FeCoquito/Robot-s-design/RoboFEI 2024/Design Data/XLS/en-US/clearance.xls

Sheet: Ansi Unified Screw Threads
I | Sort Order -1
Fastener Type | Size | Shaft Diameters |  |  | Head Dimensions
 |  | Close | Normal | Loose | Diameter | Depth/Angle | Head Type
Flat Head Machine Screw (82) | #0 | 0.0635 | 0.07 | 0.073 | 0.119 | 82 | 2
Flat Head Machine Screw (82) | #1 | 0.076 | 0.081 | 0.089 | 0.146 | 82 | 2
Flat Head Machine Screw (82) | #2 | 0.089 | 0.096 | 0.1065 | 0.172 | 82 | 2
Flat Head Machine Screw (82) | #3 | 0.104 | 0.11 | 0.12 | 0.199 | 82 | 2
Flat Head Machine Screw (82) | #4 | 0.116 | 0.1285 | 0.136 | 0.225 | 82 | 2
Flat Head Machine Screw (82) | #5 | 0.1285 | 0.136 | 0.154 | 0.252 | 82 | 2
Flat Head Machine Screw (82) | #6 | 0.144 | 0.1495 | 0.1695 | 0.279 | 82 | 2
Flat Head Machine Screw (82) | #8 | 0.1695 | 0.177 | 0.1935 | 0.332 | 82 | 2
Flat Head Machine Screw (82) | #10 | 0.196 | 0.201 | 0.221 | 0.385 | 82 | 2
Flat Head Machine Screw (82) | #12 | 0.221 | 0.228 | 0.246 | 0.438 | 82 | 2
Flat Head Machine Screw (82) | 1/4 | 0.257 | 0.266 | 0.2812 | 0.507 | 82 | 2
Flat Head Machine Screw (82) | 5/16 | 0.323 | 0.332 | 0.3437 | 0.635 | 82 | 2
Flat Head Machine Screw (82) | 3/8 | 0.386 | 0.397 | 0.4062 | 0.762 | 82 | 2
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
