FeCoquito/Robot-s-design/RoboFEI 2014/Conjunto Roda/Vista explodida roda.png

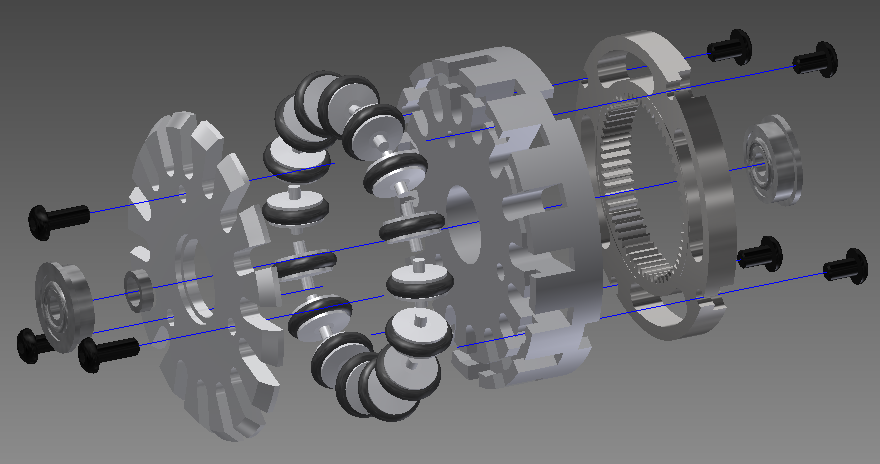
RoboFEI 2014/Conjunto Roda/Vista explodida roda.png
