FeCoquito/Robot-s-design/RoboFEI 2014/Work in Progress 2014/Projeto Nova Frente/CAD/F-180 Fundo branco.jpg

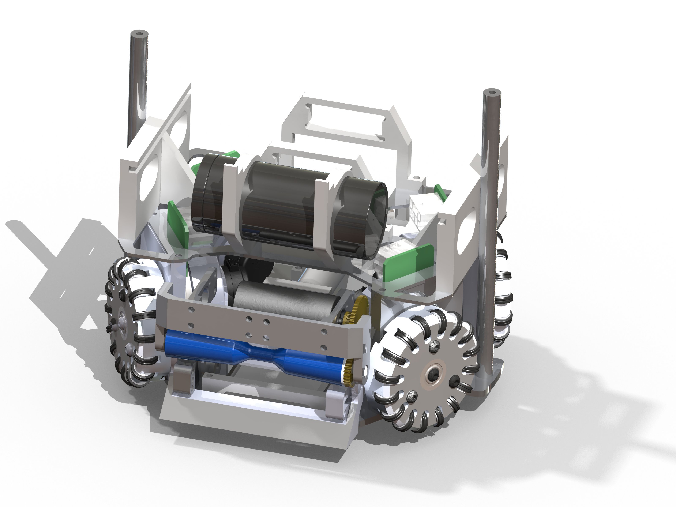
RoboFEI 2014/Work in Progress 2014/Projeto Nova Frente/CAD/F-180 Fundo branco.jpg
