FeCoquito/Robot-s-design/RoboFEI 2014/Work in Progress 2014/Projeto Nova Frente/CAD/Small Size 2011.bmp

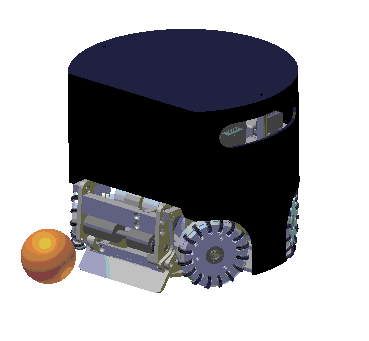
RoboFEI 2014/Work in Progress 2014/Projeto Nova Frente/CAD/Small Size 2011.bmp
