FeCoquito/Robot-s-design/RoboFEI 2014/Work in Progress 2014/Projeto Nova Frente/Distancia Polia.png

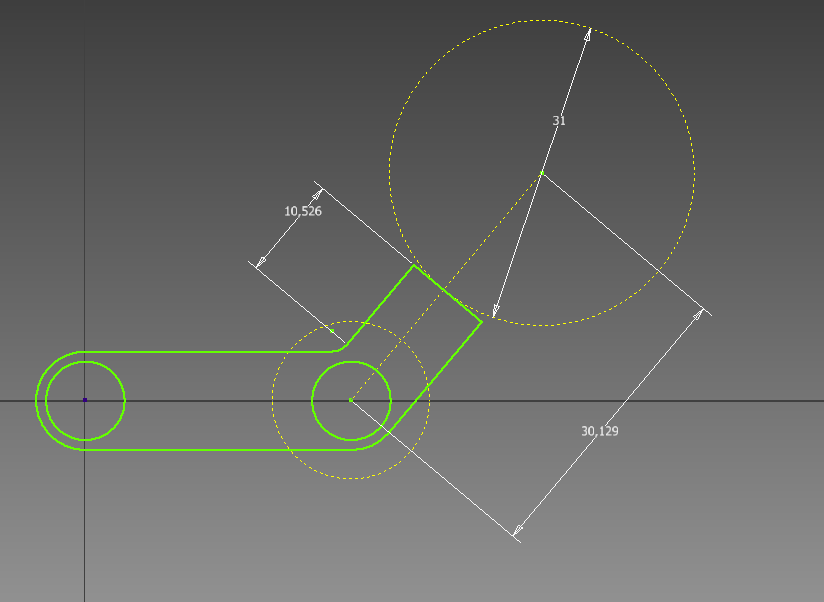
RoboFEI 2014/Work in Progress 2014/Projeto Nova Frente/Distancia Polia.png
