FeCoquito/Robot-s-design/RoboFEI 2023/2D/VistaExplodidaRodaMontada2.PNG

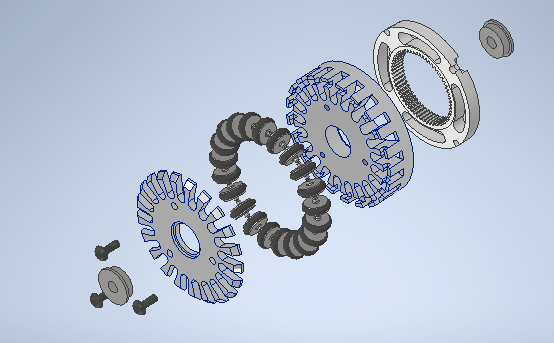
RoboFEI 2023/2D/VistaExplodidaRodaMontada2.PNG
