FeCoquito/Robot-s-design/RoboFEI 2014/Work in Progress 2014/Projeto Nova Frente/Componentes/Lista de Componentes.txt

Componentes F-180 2011

Polia motora:
https://sdp-si.com/eStore/PartDetail.asp?Opener=Group&PartID=84782&GroupID=346

Polia movida:
https://sdp-si.com/eStore/PartDetail.asp?Opener=Group&PartID=84800&GroupID=346

Correia:
https://sdp-si.com/eStore/PartDetail.asp?Opener=Group&PartID=84505&GroupID=342
