FeCoquito/Robot-s-design/Documentação - Mecânica/Checklist Mecânica materias para viagem.xlsx

Sheet: Planilha1
Chek List Mecânica
Status | Quantidade | Item | Descrição | FCA
 | 2 | Câmeras | Camêras de jogo: TAMRON CCTV Lens - M12M1412 C 1/2" 4-12 mm F/1.4 | 034341 / 034342
 | 2 | Suportes | Suporte das câmeras para fixação
 | 1 | Paquímetro | Paquímetro Digital Insize 150 mm na caixa(verde) | 45097
 | 1 | Tesoura
 | 1 | Pincel
 | 1 | Dremel e suas pontas
 | 1 | WD 40
 | 1 | Alicate Universal
 | 1 | Alicate de corte
 | 4 | Chaves de Fenda
 | 3 | Chaves Phillips
 | 1 | Alicate de Pressão
 | 1 | Super Bonder
 | 1 | Fita Crepe
 | 2 | Fita Isolante
 | 3 | Tubos cola quente
 | 1 | Pistola de cola quente
 | 1 | Abraçadeira de Nylon
 | 1 | Óculos de segurança
 | 1 | Limas agulhas
 | 1 | Lima média
 | 1 | Caixa de ferramentas
 | 1 | Fita verde (3M dupla face)
 | 1 | Caixa de peças reservas | com frente atual, chapa inferior, conjunto chipkick, suporte capacitores, batentes dianteiros, chute reto
 | 1 | Sargento
 | 1 | Cola de fixação (Loctite)
 | 1 | Cola trava-rosca (Loctite)
 | 5 | Chaves allen M3
 | 2 | Chaves allen M4
 | 5 | Lixas com granulações diferentes (36 a 320)
 | 2 | Conjuntos de machos M3
 | 1 | Conjuntos de machos M4
 | 1 | Pacote de elástico
 | 1 | Estilete
 | 1 | Kit de chaves Stanley
 | 1 | Conjunto de perfurador de pino paralelo
 | 1 | Martelo de borracha
 | 1 | Martelo de metal
 | 1 | Fita Silver Tape
 | 2 | Pratos magnéticos
 | 1 | Saco de borrachas o’rings
 | 1 | Saco de parafusos M3x6mm - reto
 | 1 | Saco de parafusos M3x6mm – oval
 | 1 | Saco de parafusos M3x8mm - reto
 | 1 | Saco de parafusos M3x8mm - oval
 | 1 | Saco de parafusos M3x12mm - reto
 | 1 | Saco de parafusos M3x12mm - oval
 | 1 | Saco de parafusos extra
 | 1 | Saco de parafusos do motor
 | 20 | Barra roscada M3 (segurar capinha)
 | 20 | Porca M3 para capinha
 | Até 24 | Espaçador f5x7mm
 | Até 24 | Arruela f5x10mm
 | Até 24 | Rolamentos f2mm
 | Até 24 | Rolamentos f4mm
 | Até 24 | Rolamentos f5mm
 | 1 | Kit para montar enconder
 | 2 | Potinho para desmontar robô
 | 1 | Rolo de fio de nylon f1 mm
OBS: |  | Sujeito à mudança nas quantidades de chaves, alicates e ferramentas em geral.

Sheet: Planilha2
Equipamentos com FCA
Quantidade | Item | Descrição | FCA
1 | Paquimetro | Páquimetro Digital Insize 150 mm na caixa(verde) | 45097
