FeCoquito/Robot-s-design/RoboFEI 2014/Work in Progress 2014/Projeto Nova Frente/IPTs/Conector femea.igs

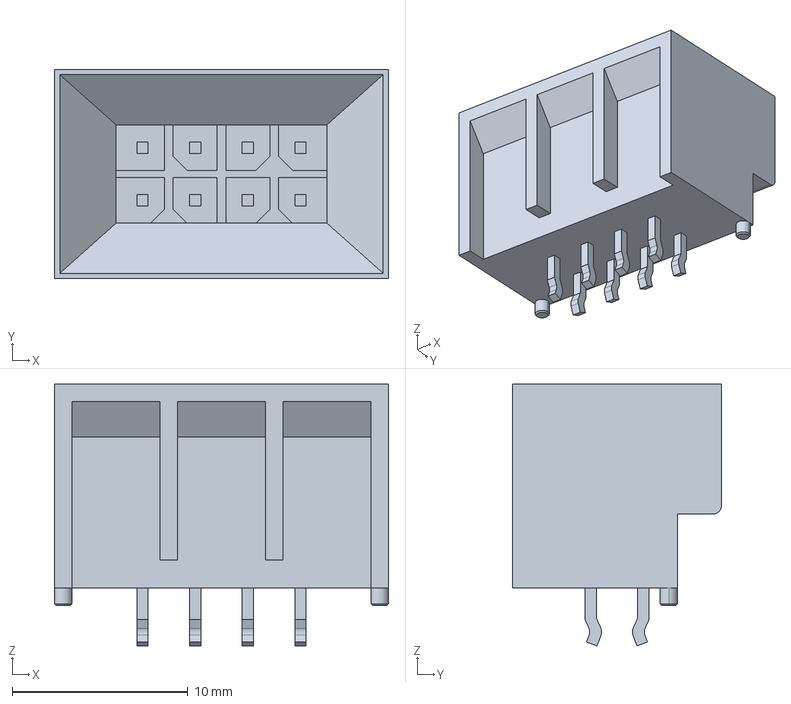
[picture p13: CAD file, 2024-11-05]
RoboFEI 2014/Work in Progress 2014/Projeto Nova Frente/IPTs/Conector femea.igs
19.0 x 11.9 x 14.9 mm
