FeCoquito/Robot-s-design/RoboFEI 2024/Espaço de trabalho/Montagem/Eletronica/Kick 2023/Placa do Robo 2023-Robo_KickBoard.STEP

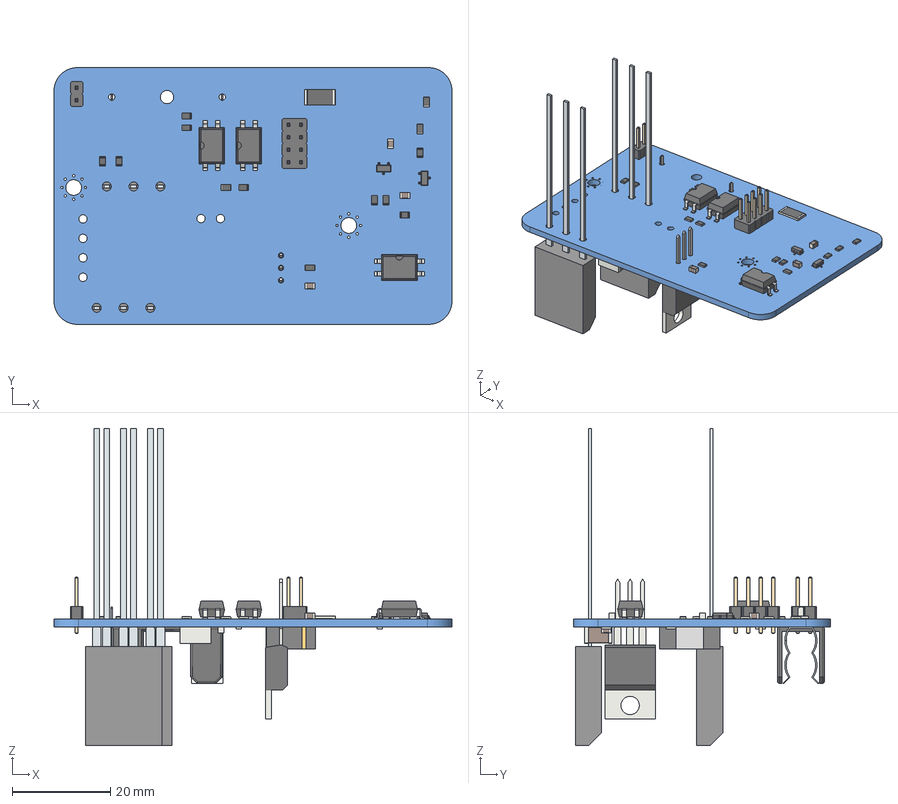
[picture p14: CAD file, 2024-11-05]
RoboFEI 2024/Espaço de trabalho/Montagem/Eletronica/Kick 2023/Placa do Robo 2023-Robo_KickBoard.STEP
81.0 x 52.2 x 64.6 mm
Local_CS_c183
Pcb_c183
PCB_Sketch_c183
J1_PinHeader_1x02_P254mm_Vertical_07a2cd0370b9
R3_R_0805_2012Metric_4932296f9c37 x 16
C4_C_0805_2012Metric_1e1440775f3d x 4
T1_SOT_23_5417db4c4c69 x 2
J2_PinHeader_2x04_P254mm_Vertical_f3ec95ff4443
U1_DIP_4_W889mm_SMDSocket_6d69d3870eff x 3
R1_R_2512_6332Metric_d473d7db04ea
PinsArray x 2
PinsArray001 x 2
PinsArray002 x 2
F1_A_Schurter_0031_8201_004fb87c2d73
C2_C_2225_5664Metric_0d0f440394aa
Q1_TO-220-3_Vertical_c507db9e14b4
