FeCoquito/Robot-s-design/RoboFEI 2014/Work in Progress 2014/Projeto Nova Frente/IPTs/Conector macho.igs

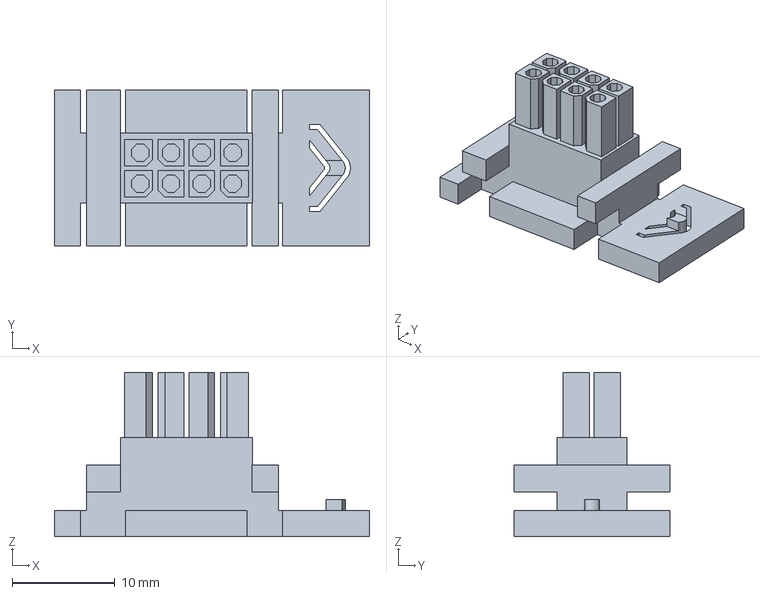
[picture p15: CAD file, 2024-11-05]
RoboFEI 2014/Work in Progress 2014/Projeto Nova Frente/IPTs/Conector macho.igs
30.7 x 15.2 x 16.0 mm
