FeCoquito/Robot-s-design/(list of files, cad)

Other CAD files:
RoboFEI 2024/Espaço de trabalho/Montagem/Eletronica/MainBoard sem componente/RoboFEI_MainBoard_v2022.0.stp
RoboFEI 2014/Work in Progress 2014/Projeto Nova Frente/Molde da Capa/Planificação da Capa.dwg
RoboFEI 2023/STEP's/Conjunto das Placas/Placa + Kick.stp
RoboFEI 2023/STEP's/Conjunto das Rodas/RBF22.P403-1 Rolete.stp
RoboFEI 2023/STEP's/Conjunto dos Mancais/EspelharEspelharEncoder_4.stp
RoboFEI 2023/STEP's/Conjunto Frontal/RBF22.P215-1 Roller.stp
RoboFEI 2023/STEP's/Conjunto Inferior/RBF22.P112-1 Amortecedor inferior.stp
RoboFEI 2023/STEP's/Conjunto Superior/RBF22.P501-1 Chapa dos Capacitores Superior.stp
RoboFEI 2023/STEP's/Montagem/RBF22.A100-1 Conjunto Inferior.stp
RoboFEI 2024/Templates/English/ANSI (in).dwg
RoboFEI 2024/Templates/Metric/DIN.dwg
RoboFEI 2024/Templates/standard.dwg
RoboFEI 2023/STEP's/Conjunto das Rodas/RBF22.P401-1 Roda.stp
RoboFEI 2023/STEP's/Conjunto dos Mancais/EspelharEspelharEncoder_6.stp
RoboFEI 2023/STEP's/Conjunto Frontal/RBF22.P202-1 Suporte do Roller Esquerdo.stp
RoboFEI 2023/STEP's/Conjunto Inferior/RBF22.P106-1 Carretel.stp
RoboFEI 2023/STEP's/Conjunto Superior/RBF22.P503-1 Amortecedor.stp
RoboFEI 2023/STEP's/Montagem/RBF22.A500-1 Conjunto Superior.stp
RoboFEI 2024/Templates/Metric/GOST.dwg
RoboFEI 2023/STEP's/Conjunto das Rodas/RBF22.P404-2 Coroa Engrenada.stp
RoboFEI 2023/STEP's/Conjunto dos Mancais/RBF22.P301-1 Mancal da Roda Par.stp
RoboFEI 2023/STEP's/Conjunto Frontal/RBF22.P212-1 Engrenagem Intermediária.stp
RoboFEI 2023/STEP's/Conjunto Inferior/RBF22.P109-1 Hastes de Suporte.stp
RoboFEI 2023/STEP's/Conjunto Superior/RBF22.P502-1 Chapa dos Capacitores Inferior.stp
RoboFEI 2023/STEP's/Montagem/RBF22.A000-1 Montagem Completa.stp
RoboFEI 2024/Templates/Metric/GB.dwg
RoboFEI 2023/STEP's/Conjunto das Rodas/RBF22.P402-1 Tampa.stp
RoboFEI 2023/STEP's/Conjunto dos Mancais/RBF22.P303-1 Eixo Par.stp
RoboFEI 2023/STEP's/Conjunto Frontal/RBF22.P205-1 Suporte do Roller Superior.stp
RoboFEI 2023/STEP's/Conjunto Inferior/RBF22.P105-1 Kick Modificado.stp
RoboFEI 2023/STEP's/Conjunto Superior/RBF22.P506-1 Haste de Fixação da Placa.stp
RoboFEI 2023/STEP's/Montagem/RBF22.A200-1 Conjunto Frontal.stp
RoboFEI 2024/Templates/Metric/BSI.dwg
RoboFEI 2023/STEP's/Conjunto das Rodas/RBF22.P405-1 Oring.stp
RoboFEI 2023/STEP's/Conjunto dos Mancais/EspelharEspelharEncoder.stp
RoboFEI 2023/STEP's/Conjunto Frontal/RBF22.P217-1 Chapa do Chip Kick.stp
RoboFEI 2023/STEP's/Conjunto Inferior/RBF22.P107-1 Carretel Flat.stp
RoboFEI 2023/STEP's/Conjunto Superior/RBF22.P502-1 Haste de Fixação das Chapas.stp
RoboFEI 2023/STEP's/Montagem/RBF22.A300-1 Mancal Ímpar.stp
RoboFEI 2024/Templates/Metric/JIS.dwg
RoboFEI 2023/STEP's/Conjunto dos Mancais/EspelharEspelharEncoder_1.stp
RoboFEI 2023/STEP's/Conjunto Frontal/RBF22.P211-1 Espaçador da engrenagem intermediaria.stp
RoboFEI 2023/STEP's/Conjunto Inferior/RBF22.P111-1 Haste do Êmbolo.stp
RoboFEI 2023/STEP's/Conjunto Superior/RBF22.P505-1 Fixação do Suporte da Placa Direita.stp
RoboFEI 2023/STEP's/Montagem/RBF22.A301-1 Mancal Par.stp
RoboFEI 2024/Templates/Metric/ISO.dwg
RoboFEI 2023/STEP's/Conjunto dos Mancais/RBF22.P302-1 Mancal da Roda Impar.stp
RoboFEI 2023/STEP's/Conjunto Frontal/RBF22.P201-2 Suporte do Roller Direito.stp
RoboFEI 2023/STEP's/Conjunto Inferior/RBF22.P110-1 Corpo do Êmbolo.stp
RoboFEI 2023/STEP's/Conjunto Superior/Capacitor 35x35.stp
RoboFEI 2023/STEP's/Montagem/RBF22.A400-1 Conjunto das Rodas.stp
RoboFEI 2024/Templates/Metric/ANSI (mm).dwg
RoboFEI 2023/STEP's/Conjunto dos Mancais/EspelharEspelharEncoder_3.stp
RoboFEI 2023/STEP's/Conjunto Frontal/RBF22.P209-1 Eixo do da Engrenagem Intermediária.stp
RoboFEI 2023/STEP's/Conjunto Inferior/RBF22.P108-1Haste de fixação traseira.stp
RoboFEI 2023/STEP's/Conjunto Superior/RBF22.P504-1 Fixação do Suporte da Placa Esquerda.stp
RoboFEI 2023/STEP's/Conjunto dos Mancais/RBF22.P305-1 Suporte Encoder.stp
RoboFEI 2023/STEP's/Conjunto Frontal/RBF22.P216-1 Suporte do Carretel Flat.stp
RoboFEI 2023/STEP's/Conjunto Inferior/RBF22.P103-1 Suporte Solenoide Traseiro.stp
RoboFEI 2023/STEP's/Conjunto Superior/Bateria.stp
RoboFEI 2023/STEP's/Conjunto dos Mancais/EspelharEspelharEncoder_7.stp
RoboFEI 2023/STEP's/Conjunto Frontal/RBF22.P203-2 Mancal Direito.stp
RoboFEI 2023/STEP's/Conjunto Inferior/RBF22.P104-1 Êmbolo Chipkick.stp
RoboFEI 2023/STEP's/Conjunto dos Mancais/RBF22.P306-1 Espaçador Encoder.stp
RoboFEI 2023/STEP's/Conjunto Frontal/RBF22.P207-1 Eixo Mancal.stp
RoboFEI 2023/STEP's/Conjunto Inferior/RBF22.P101-1 Chapa Inferior.stp
RoboFEI 2023/STEP's/Conjunto dos Mancais/EC-45.stp
RoboFEI 2023/STEP's/Conjunto Frontal/RBF22.P213-1 Engrenagem Motriz.stp
RoboFEI 2023/STEP's/Conjunto Inferior/RBF22.P102-1 Suporte Solenoide.stp
RoboFEI 2023/STEP's/Conjunto dos Mancais/EspelharEspelharEncoder_5.stp
RoboFEI 2023/STEP's/Conjunto Frontal/RBF22.P218-2 Chip Kick.stp
RoboFEI 2023/STEP's/Conjunto dos Mancais/RBF22.P304-1 Eixo Ímpar.stp
RoboFEI 2023/STEP's/Conjunto Frontal/RBF22.P214-1 Engrenagem do Eixo do Roller.stp
RoboFEI 2023/STEP's/Conjunto dos Mancais/Encoder.stp
RoboFEI 2023/STEP's/Conjunto Frontal/RBF22.P210-1 Fixação do eixo intermediario v2.stp
RoboFEI 2023/STEP's/Conjunto dos Mancais/EspelharEspelharEncoder_2.stp
RoboFEI 2023/STEP's/Conjunto Frontal/RBF22.P208-2 Eixo Roller.stp
RoboFEI 2023/STEP's/Conjunto Frontal/RBF22.P206-1 Eixo Chip Kick.stp
RoboFEI 2023/STEP's/Conjunto Frontal/RBF22.P204-2 Mancal Esquerdo.stp
RoboFEI 2014/Area 180mm.ipt
RoboFEI 2014/Capa.ipt
RoboFEI 2014/Comercial/Bateria.ipt
RoboFEI 2014/Comercial/Bola.ipt
RoboFEI 2014/Comercial/Capacitor.ipt
RoboFEI 2014/Comercial/EC-22.ipt
RoboFEI 2014/Comercial/EC-45.ipt
RoboFEI 2014/Comercial/Encoder.ipt
RoboFEI 2014/Comercial/OldVersions/Bateria.0006.ipt
RoboFEI 2014/Comercial/OldVersions/Bola.0004.ipt
RoboFEI 2014/Comercial/OldVersions/Capacitor.0006.ipt
RoboFEI 2014/Comercial/OldVersions/EC-22.0005.ipt
RoboFEI 2014/Comercial/OldVersions/EC-45.0014.ipt
RoboFEI 2014/Comercial/OldVersions/Encoder.0006.ipt
RoboFEI 2014/Comercial/OldVersions/Parafuso - Amortecimento.0004.ipt
RoboFEI 2014/Comercial/OldVersions/Placa Main.0004.ipt
RoboFEI 2014/Comercial/OldVersions/Rolamento - 13 mm.0002.ipt
RoboFEI 2014/Comercial/OldVersions/Rolamento - 8 mm.0005.ipt
RoboFEI 2014/Comercial/Parafuso - Amortecimento.ipt
RoboFEI 2014/Comercial/Parafuso - Amortecimento.newVer.ipt
RoboFEI 2014/Comercial/Placa Kick.ipt
RoboFEI 2014/Comercial/Placa Main.ipt
RoboFEI 2014/Comercial/Rolamento - 13 mm.ipt
RoboFEI 2014/Comercial/Rolamento - 8 mm.ipt
RoboFEI 2014/Conjunto Frontal/OldVersions/RBF.A1-1 Conjunto Frontal.0002.iam
RoboFEI 2014/Conjunto Frontal/OldVersions/RBF14.A1-1 Conjunto Frontal.0003.iam
RoboFEI 2014/Conjunto Frontal/OldVersions/RBF14.A100-1 Conjunto Frontal.0004.iam
RoboFEI 2014/Conjunto Frontal/OldVersions/RBF14.A200-0 Conjunto Frontal.0005.iam
RoboFEI 2014/Conjunto Frontal/OldVersions/RBF14.A200-1 Conjunto Frontal.0009.iam
RoboFEI 2014/Conjunto Frontal/OldVersions/RBF14.A200-1 Conjunto Frontal.0011.iam
RoboFEI 2014/Conjunto Frontal/OldVersions/RBF14.D202-0 Mancal Dianteiro Esquerdo.0018.ipt
RoboFEI 2014/Conjunto Frontal/OldVersions/RBF14.P100-1 Mancal Dianteiro Esquerdo.0038.ipt
RoboFEI 2014/Conjunto Frontal/OldVersions/RBF14.P100-1 Mancal Dianteiro_MIR.0014.ipt
RoboFEI 2014/Conjunto Frontal/OldVersions/RBF14.P101-1 Mancal Dianteiro Direito.0016.ipt
RoboFEI 2014/Conjunto Frontal/OldVersions/RBF14.P101-1 Mancal Dianteiro Esquerdo.0017.ipt
RoboFEI 2014/Conjunto Frontal/OldVersions/RBF14.P102-1 Bucha de bronze.0002.ipt
RoboFEI 2014/Conjunto Frontal/OldVersions/RBF14.P103-1 Eixo 4.4.0004.ipt
RoboFEI 2014/Conjunto Frontal/OldVersions/RBF14.P104-1 Chipkick.0013.ipt
RoboFEI 2014/Conjunto Frontal/OldVersions/RBF14.P105-1 Eixo 4.6.0007.ipt
RoboFEI 2014/Conjunto Frontal/OldVersions/RBF14.P106-1 Suporte Roller Direito.0019.ipt
RoboFEI 2014/Conjunto Frontal/OldVersions/RBF14.P107-1 Suporte Roller Esquerdo.0007.ipt
RoboFEI 2014/Conjunto Frontal/OldVersions/RBF14.P108-1 Eixo do Roller.0011.ipt
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
