FeCoquito/Robot-s-design/RoboFEI 2014/Montagem2.pdf

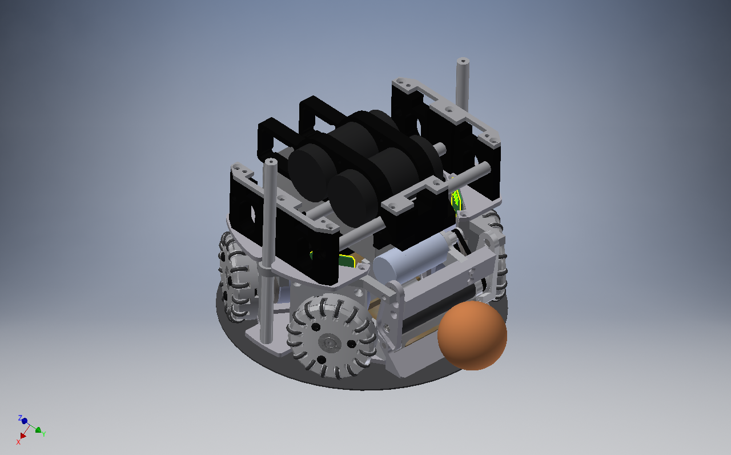
[picture p16: page 1]
