FeCoquito/Robot-s-design/RoboFEI 2024/Espaço de trabalho/Montagem/Comercial e Acessorios/Bandeira do Brasil.png

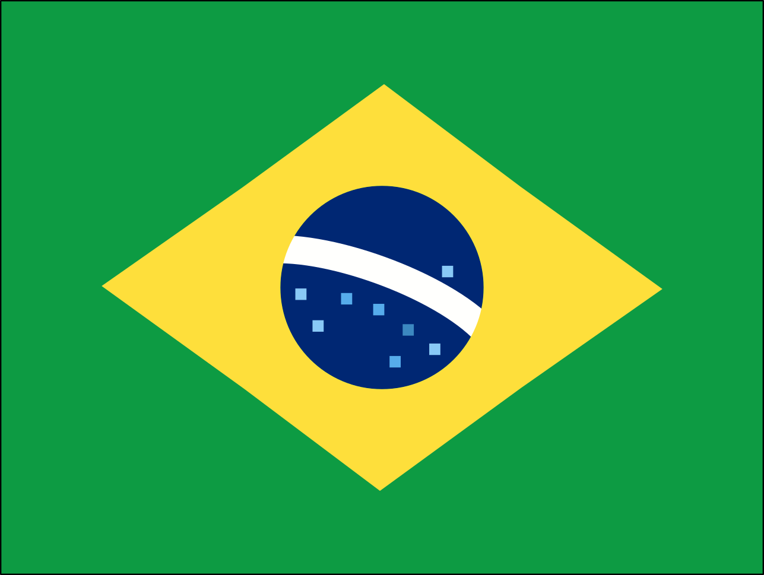
RoboFEI 2024/Espaço de trabalho/Montagem/Comercial e Acessorios/Bandeira do Brasil.png
