FeCoquito/Robot-s-design/RoboFEI 2014/Work in Progress 2014/Solução Mancal/Teste Mancais/02.03.15/Odometria Mancal Antigo.jpg

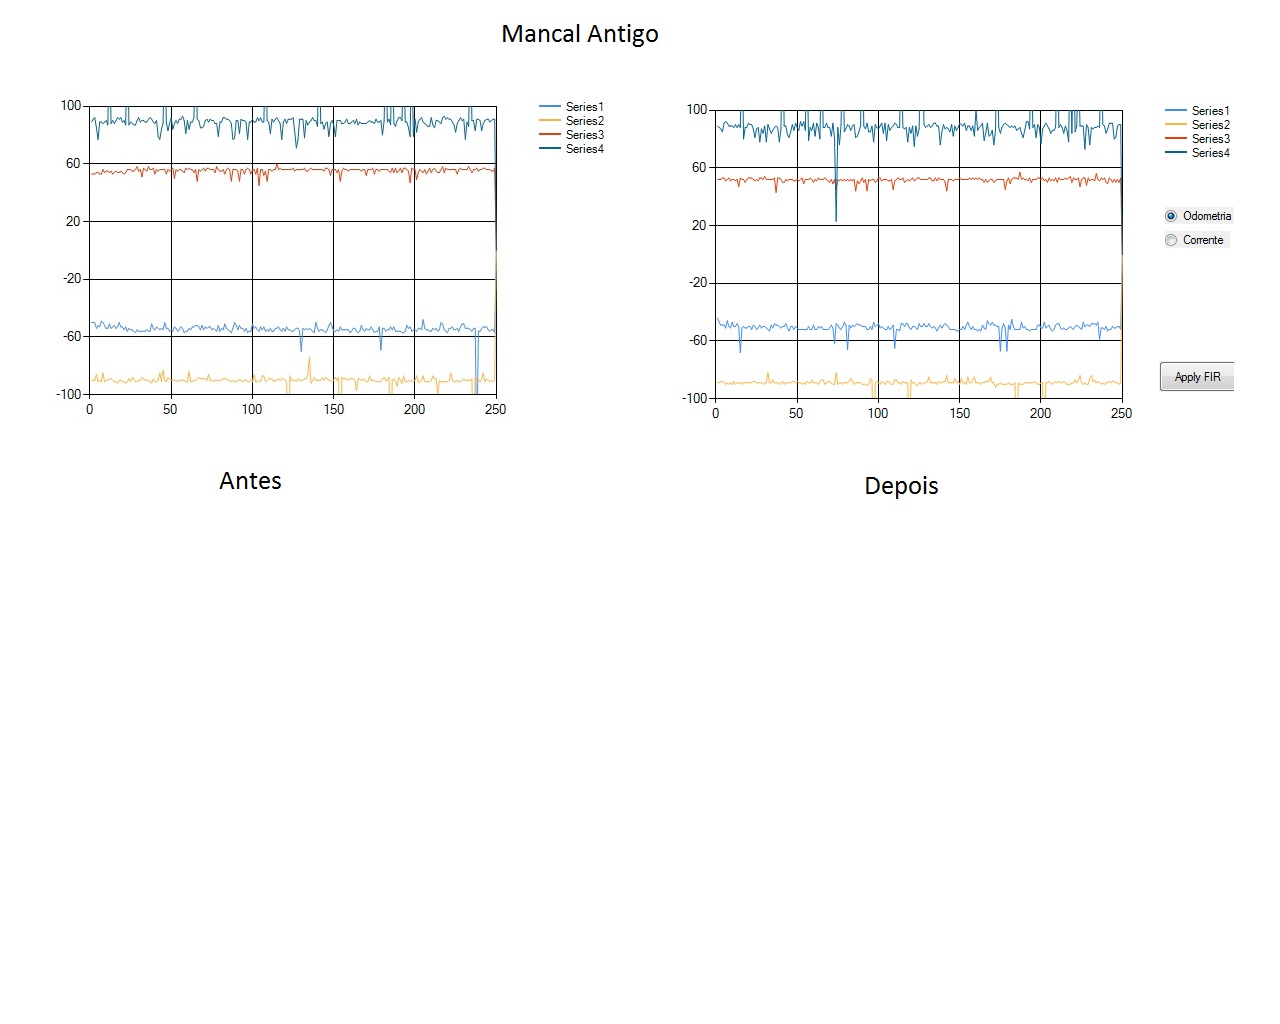
RoboFEI 2014/Work in Progress 2014/Solução Mancal/Teste Mancais/02.03.15/Odometria Mancal Antigo.jpg
