FeCoquito/Robot-s-design/RoboFEI 2014/Work in Progress 2014/Projeto Nova Frente/CAD/Montagem - Conjunto frontal.pdf

C

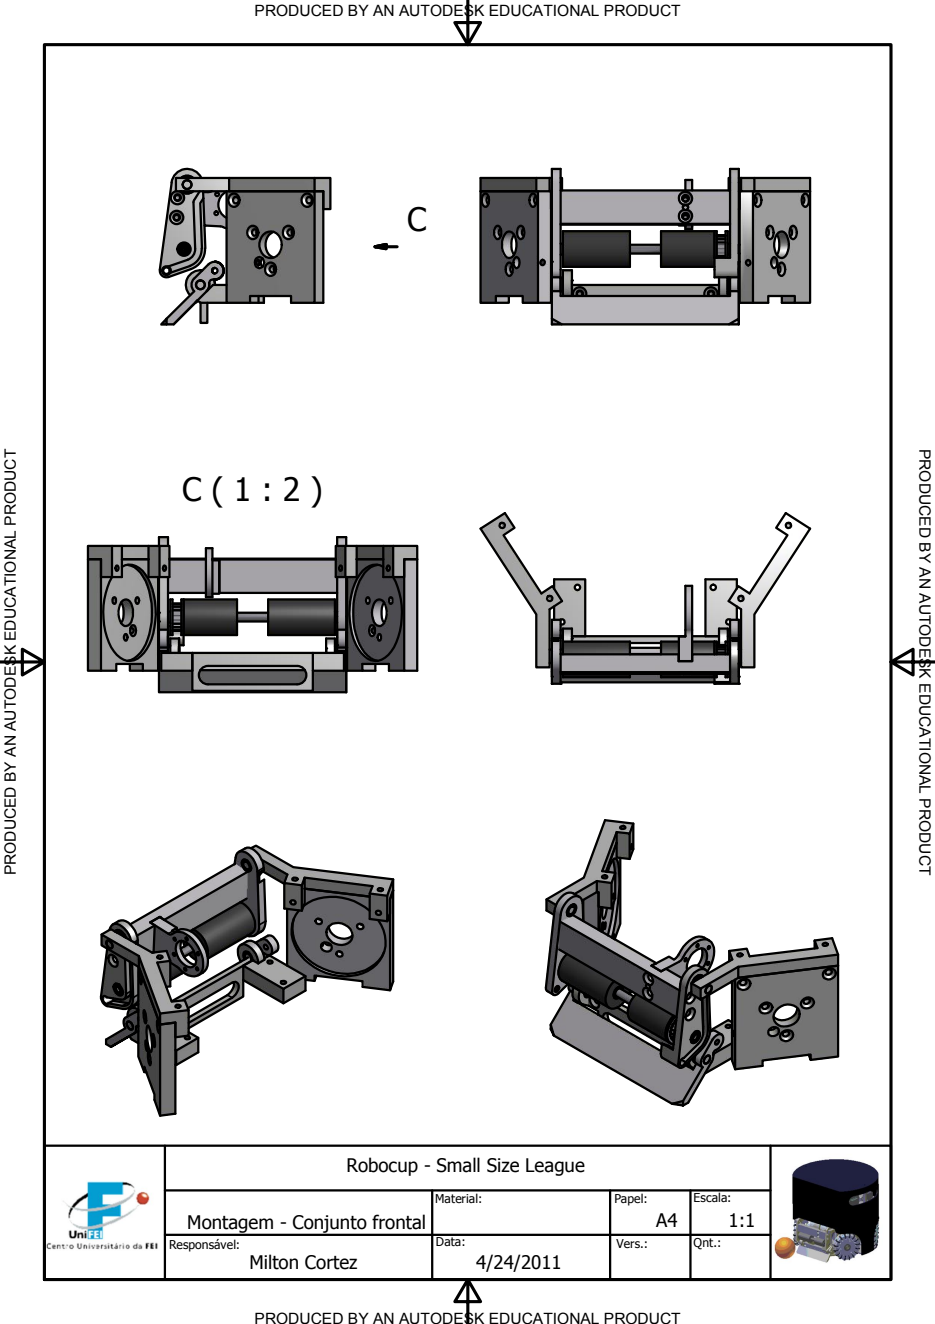
[picture p20: page 1]
TIO; A U T O D E S K E D U C A TIO; Qnt.:; Escala:; Responsivel:; Milton Cortez; Material:; Vers.:; Papel:; Data:

PRODUCED BY AN AUTODESK EDUCATIONAL PRODUCT

Robocup - Small Size League

Montagem - Conjunto frontal
