FeCoquito/Robot-s-design/RoboFEI 2014/Work in Progress 2014/Projeto Nova Frente/Conjuntos de Montagens/Conjunto Chipkick/Conjunto 5.pdf

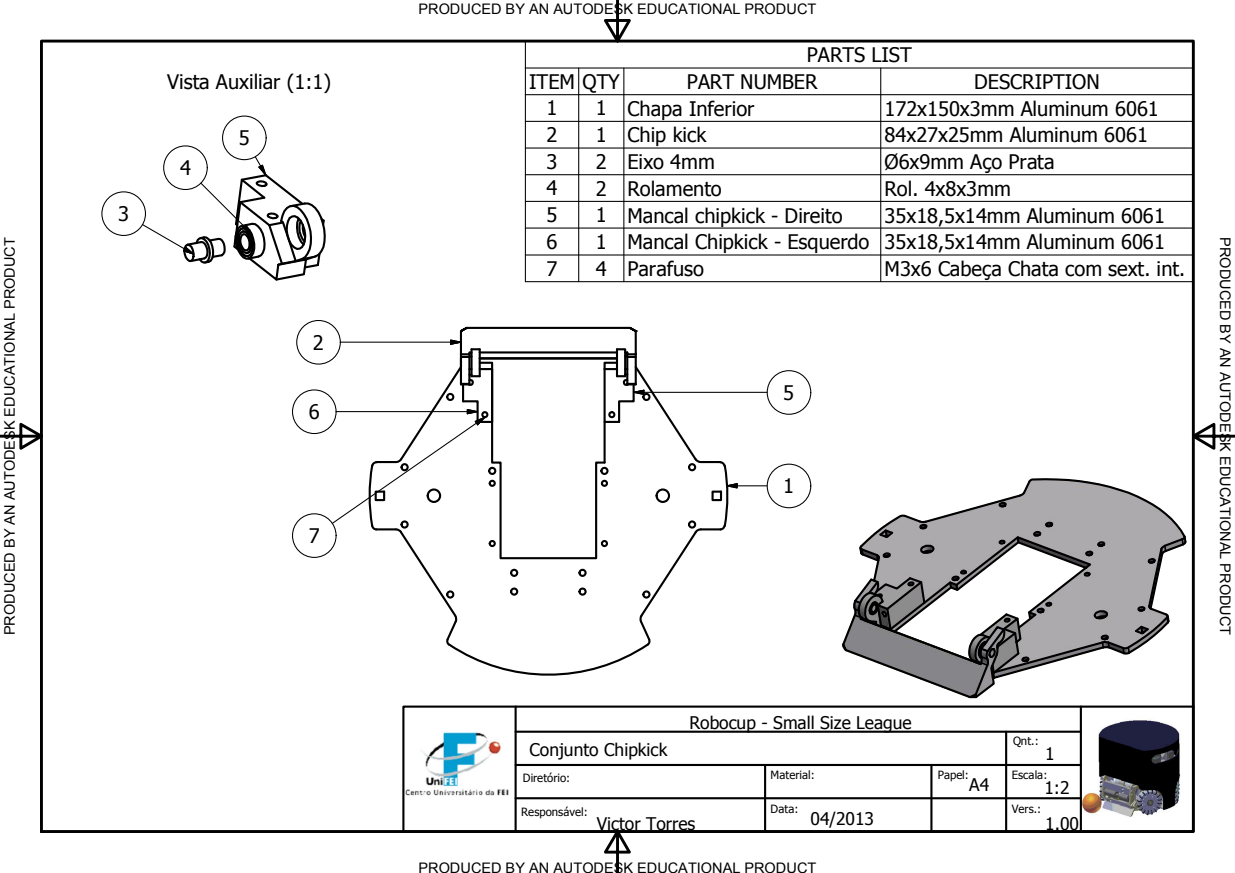
[picture p21: page 1]
PARTS LIST; ITEM; QTY; PART NUMBER; DESCRIPTION; Chapa Inferior; 172x150x3mm Aluminum 6061; Chip kick; 84x27x25mm Aluminum 6061; Eixo 4mm; Ø6x9mm Aoo Prata; Rolamento; Rol. 4x8x3mm; Mancal chipkick - Direito; 35x18,5x14mm Aluminum 6061; Mancal Chipkick - Esquerdo; Parafuso; M3x6 Cabeoa Chata com sext. int.; TIO; A U T O D E S K E D U C A TIO; Responsivel:; Victor Torres; Vers.:; Data:; Vista Auxiliar (1:1)

PRODUCED BY AN AUTODESK EDUCATIONAL PRODUCT

Robocup - Small Size League

Conjunto Chipkick | Qnt.: 1

Diretyrio: | Material: | Papel: A4 | Escala: 1:2
