FeCoquito/Robot-s-design/RoboFEI 2014/Work in Progress 2014/Projeto Nova Frente/Conjuntos de Montagens/Conjunto Roller/Conjunto 3.pdf

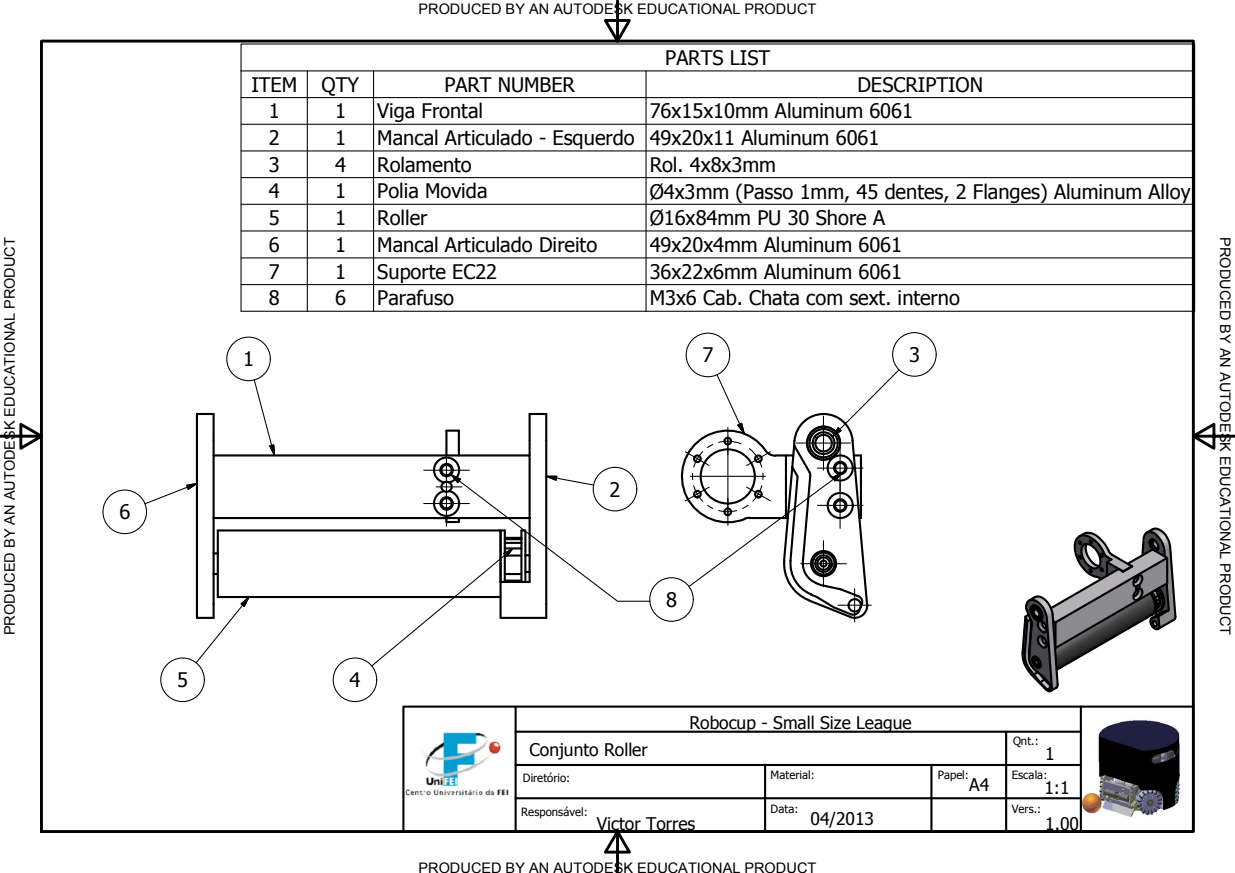
[picture p22: page 1]
PARTS LIST; ITEM; QTY; PART NUMBER; DESCRIPTION; Viga Frontal; 76x15x10mm Aluminum 6061; Mancal Articulado - Esquerdo; 49x20x11 Aluminum 6061; Rolamento; Rol. 4x8x3mm; Polia Movida; Ø4x3mm (Passo 1mm, 45 dentes, 2 Flanges) Aluminum Alloy; Roller; Ø16x84mm PU 30 Shore A; Mancal Articulado Direito; 49x20x4mm Aluminum 6061; Suporte EC22; 36x22x6mm Aluminum 6061; Parafuso; M3x6 Cab. Chata com sext. interno; TIO; A U T O D E S K E D U C A TIO; Responsivel:; Victor Torres; Vers.:; Data:

PRODUCED BY AN AUTODESK EDUCATIONAL PRODUCT

Robocup - Small Size League

Conjunto Roller | Qnt.: 1

Diretyrio: | Material: | Papel: A4 | Escala: 1:1
