FeCoquito/Robot-s-design/RoboFEI 2014/Work in Progress 2014/Projeto Nova Frente/Conjuntos de Montagens/Conjuntos PDF/Conjunto Mancal Direito.pdf

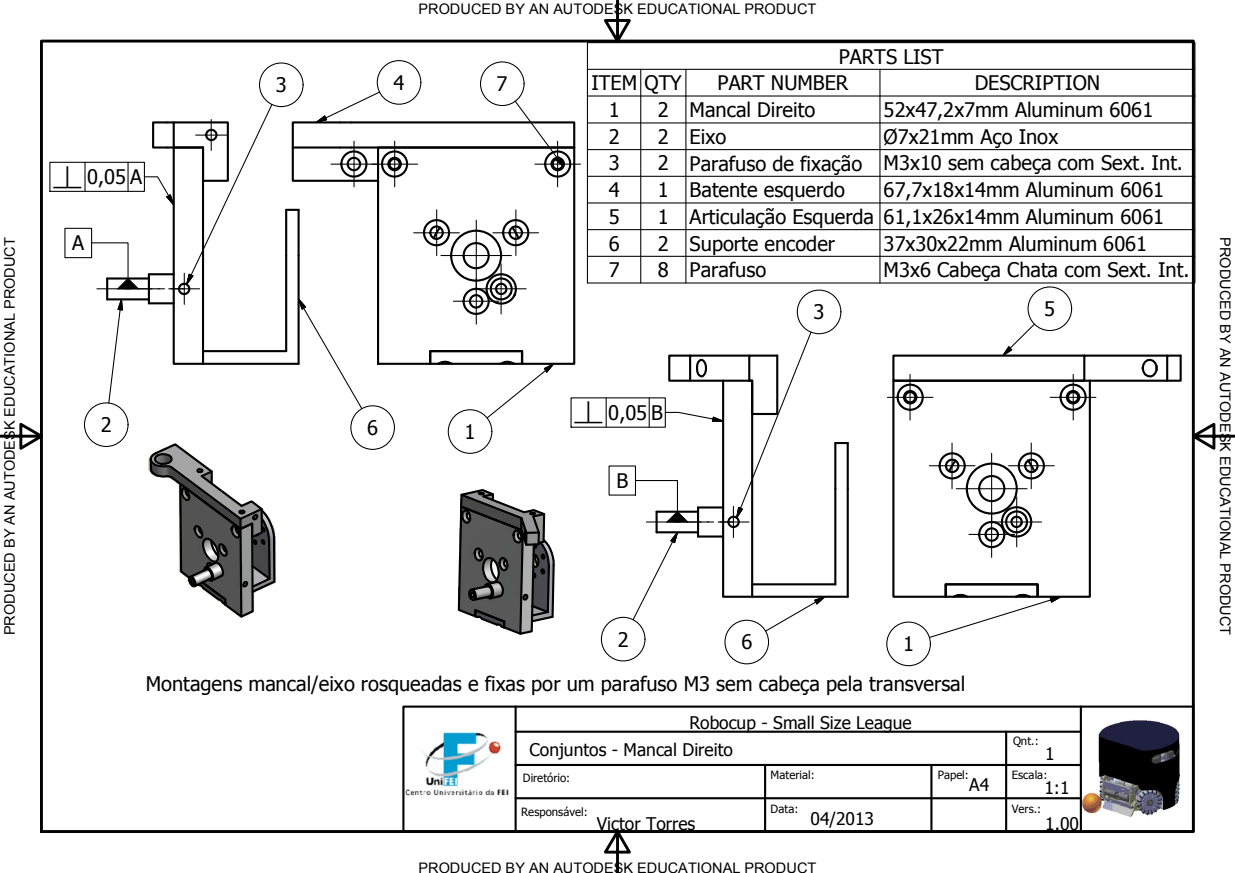
[picture p23: page 1]
PARTS LIST; ITEM; QTY; PART NUMBER; DESCRIPTION; Mancal Direito; 52x47,2x7mm Aluminum 6061; Eixo; Ø7x21mm Aoo Inox; Parafuso de fixaomo; M3x10 sem cabeoa com Sext. Int.; Batente esquerdo; 67,7x18x14mm Aluminum 6061; Articulaomo Esquerda; 61,1x26x14mm Aluminum 6061; Suporte encoder; 37x30x22mm Aluminum 6061; Parafuso; M3x6 Cabeoa Chata com Sext. Int.; TIO; A U T O D E S K E D U C A TIO; Responsivel:; Victor Torres; Vers.:; Data:

PRODUCED BY AN AUTODESK EDUCATIONAL PRODUCT

Montagens mancal/eixo rosqueadas e fixas por um parafuso M3 sem cabeoa pela transversal

Robocup - Small Size League

Conjuntos - Mancal Direito | Qnt.: 1

Diretyrio: | Material: | Papel: A4 | Escala: 1:1
