FeCoquito/Robot-s-design/RoboFEI 2014/RBF14.A300-0 Conjunto Mancal Antigo Impar-1.pdf

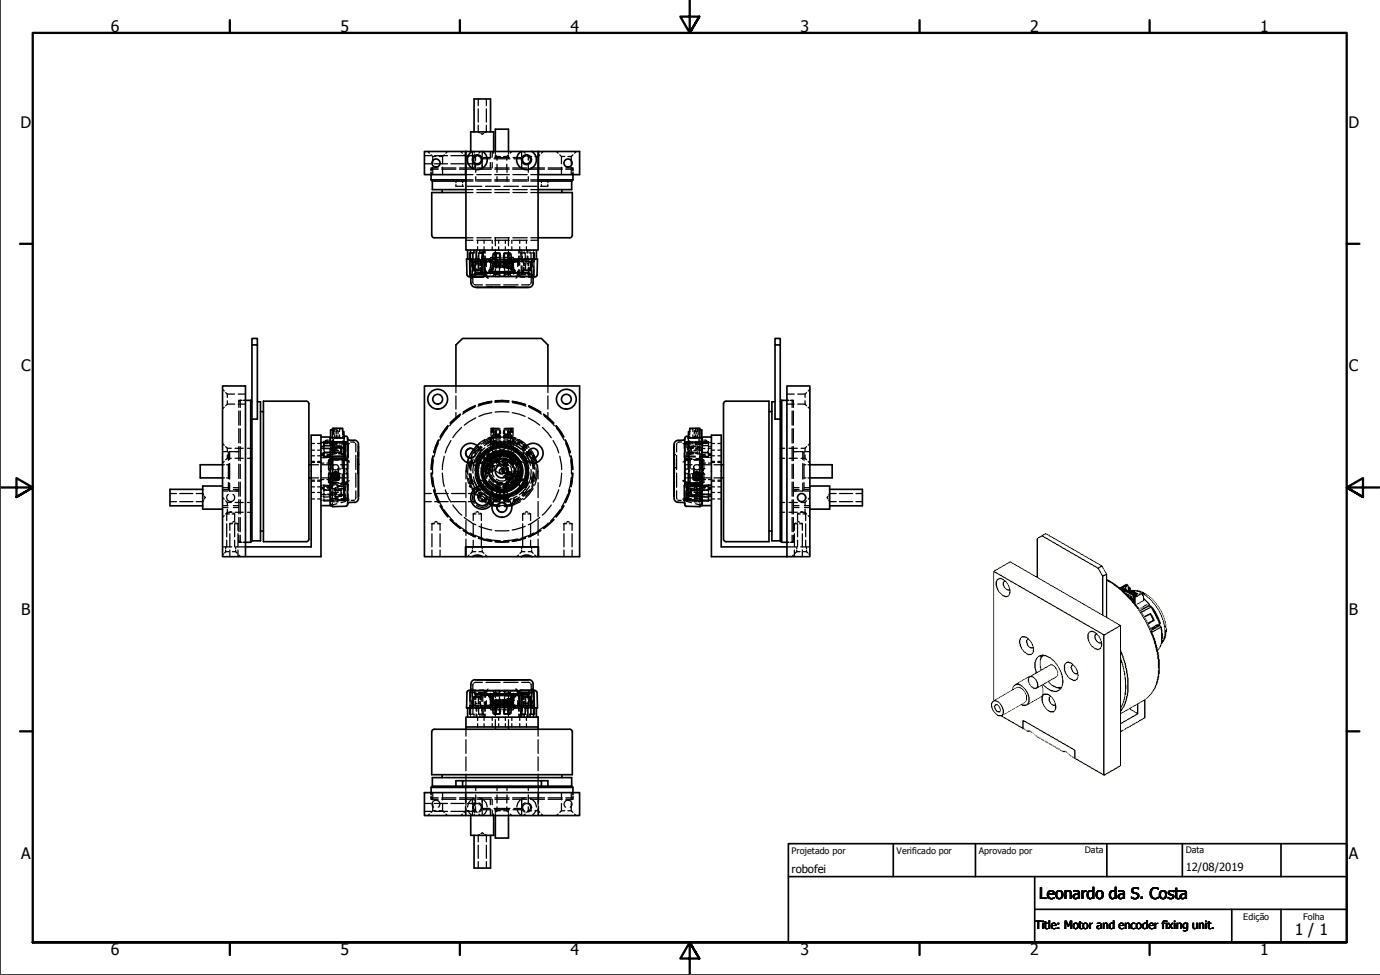
[picture p25: page 1]
Projetado por; Verificado por; Aprovado por; Data

Leonardo da S. Costa

Title: Motor and encoder fixing unit.
