FeCoquito/Robot-s-design/RoboFEI 2023/2D/Engrenagem do Eixo do Roller.pdf

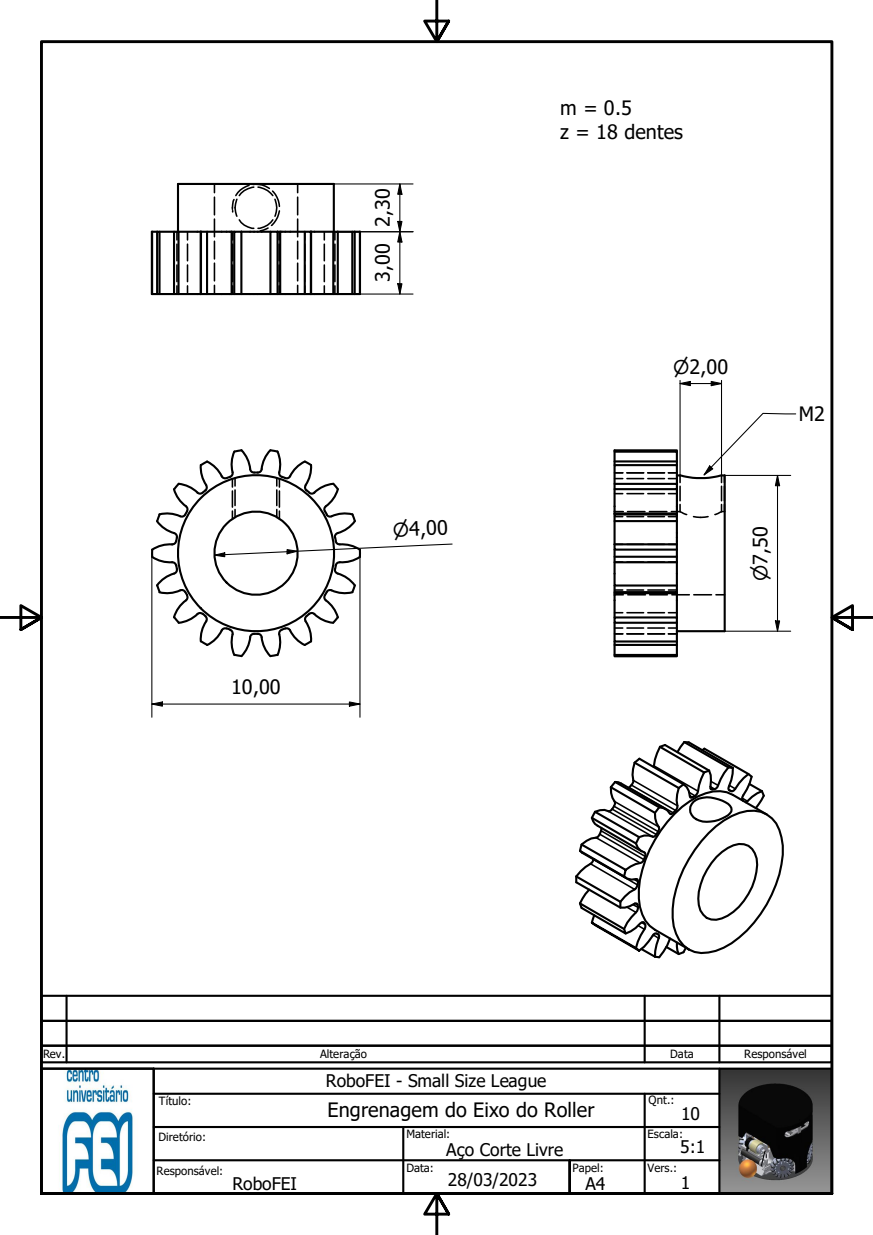
[picture p26: page 1]
m = 0.5 z = 18 dentes

RoboFEI - Small Size League

Título: Engrenagem do Eixo do Roller | Qnt.: 10

Diretório: | Material: Aço Corte Livre | Escala: 5:1

Responsável: RoboFEI | Data: 28/03/2023 | Papel: A4 | Vers.: 1
