FeCoquito/Robot-s-design/RoboFEI 2023/2D/RBF22.P212-1 Engrenagem Intermediária.pdf

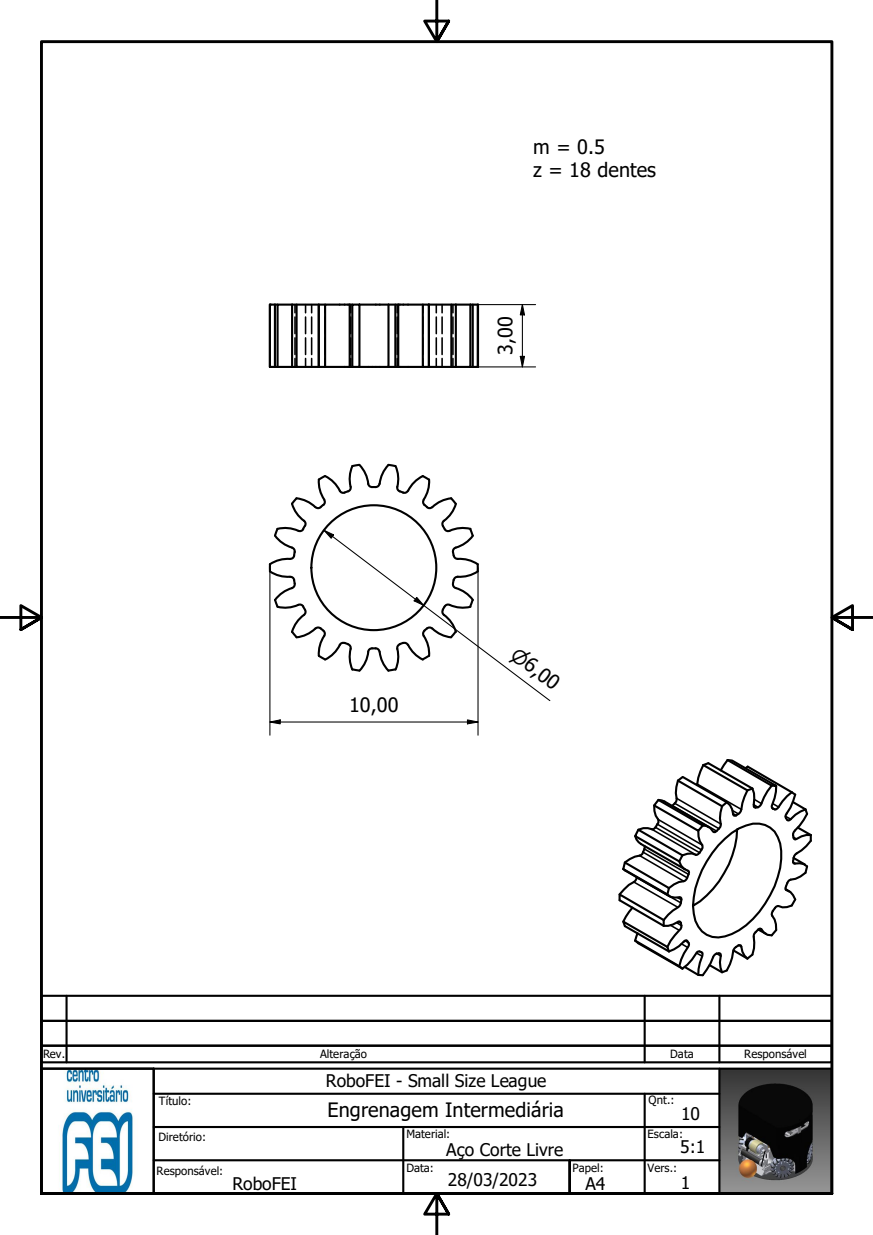
[picture p27: page 1]
m = 0.5 z = 18 dentes

RoboFEI - Small Size League

Título: Engrenagem Intermediária | Qnt.: 10

Diretório: | Material: Aço Corte Livre | Escala: 5:1

Responsável: RoboFEI | Data: 28/03/2023 | Papel: A4 | Vers.: 1
