FeCoquito/Robot-s-design/RoboFEI 2023/2D/RBF22.P213-1 Engrenagem Motriz.pdf

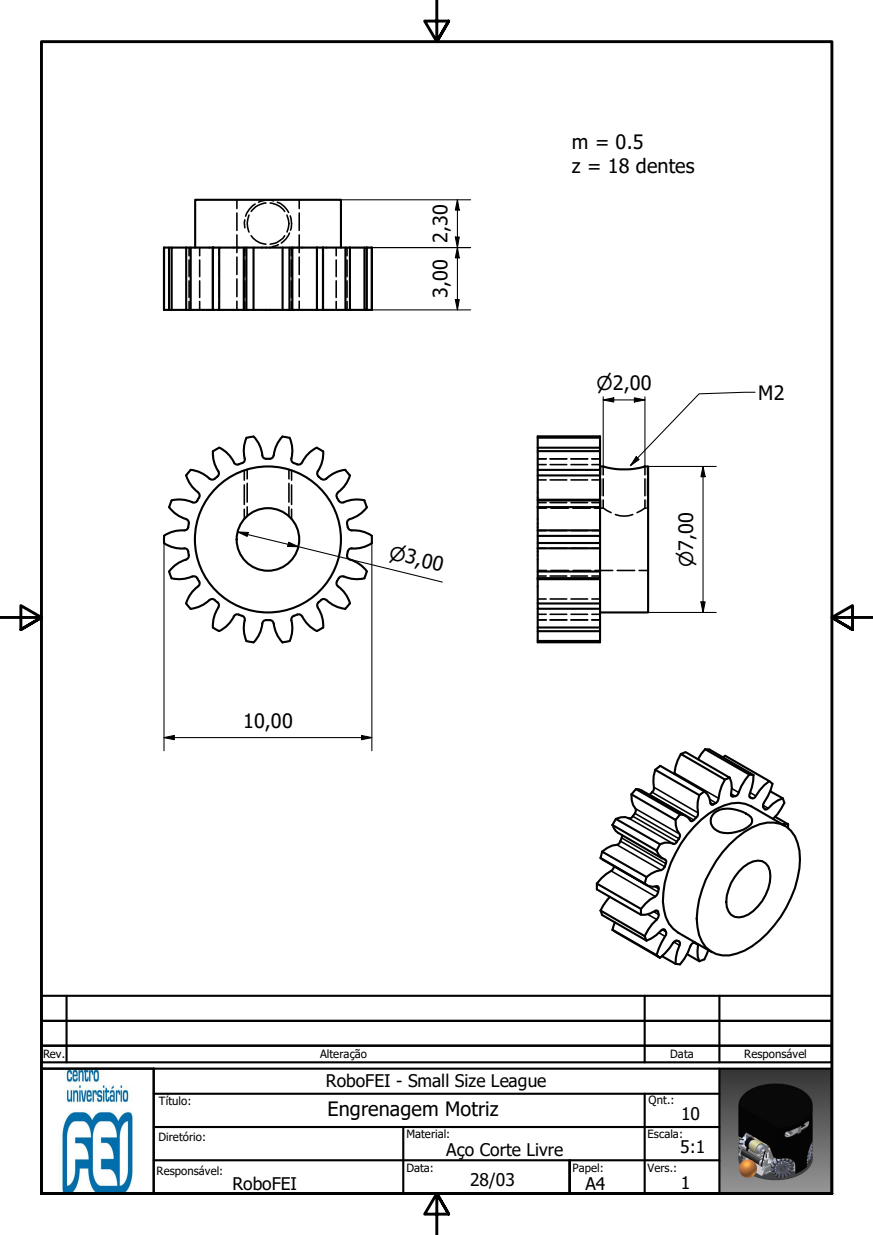
[picture p28: page 1]
m = 0.5 z = 18 dentes

RoboFEI - Small Size League

Título: Engrenagem Motriz | Qnt.: 10

Diretório: | Material: Aço Corte Livre | Escala: 5:1

Responsável: RoboFEI | Data: 28/03 | Papel: A4 | Vers.: 1
