FeCoquito/Robot-s-design/RoboFEI 2014/Work in Progress 2014/Projeto Nova Frente/CAD/Amortecedor - Chapa.pdf

A-A ( 1 : 1 )
A

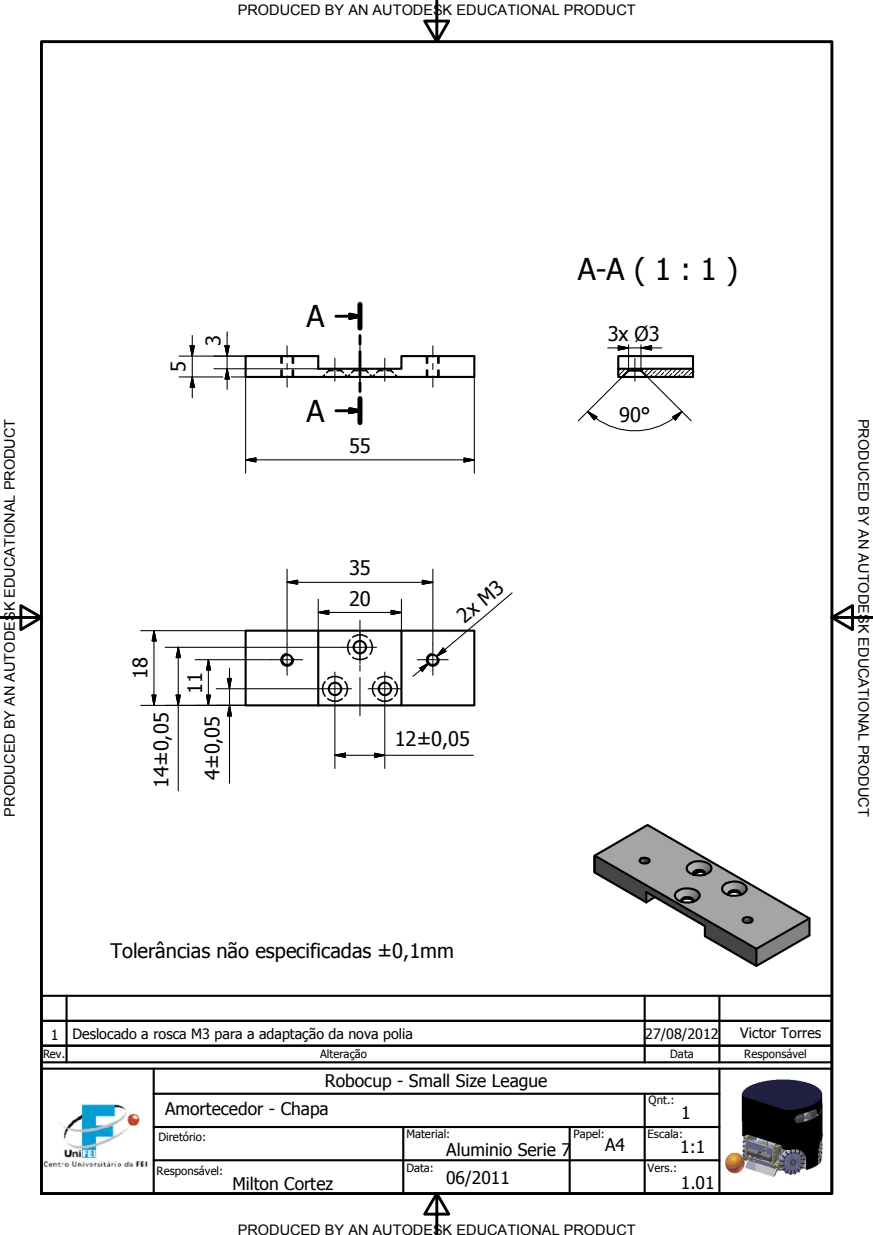
[picture p29: page 1]
TIO; A U T O D E S K E D U C A TIO; Responsivel:; Milton Cortez; Vers.:; Data:; Rev.; Alteraomo; Data; Responsivel; Deslocado a rosca M3 para a adaptaomo da nova polia; Victor Torres

PRODUCED BY AN AUTODESK EDUCATIONAL PRODUCT

Tolerkncias nmo especificadas ±0,1mm

Robocup - Small Size League

Amortecedor - Chapa | Qnt.: 1

Diretyrio: | Material: Aluminio Serie 7 | Papel: A4 | Escala: 1:1
