FeCoquito/Robot-s-design/RoboFEI 2014/Work in Progress 2014/Projeto Nova Frente/CAD/Amortecedor - Suporte.pdf

### PRODUCED BY AN AUTODESK EDUCATIONAL PRODUCT

90°

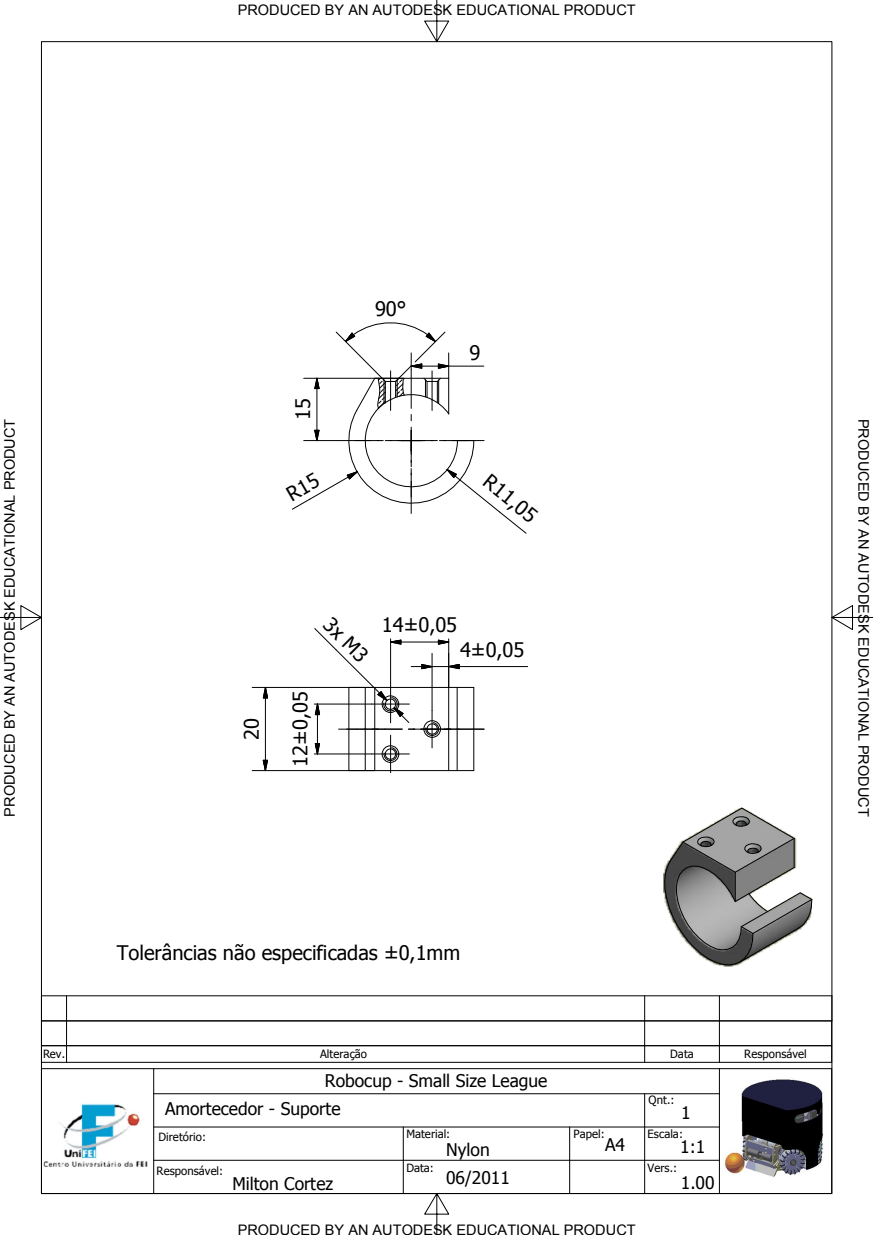
[picture p30: page 1]
TIO; A U T O D E S K E D U C A TIO; Rev.; Alteraomo; Data; Responsivel

Tolerkncias nmo especificadas ±0,1mm

Robocup - Small Size League

Amortecedor - Suporte | Qnt.: 1

Diretyrio: | Material: Nylon | Papel: A4 | Escala: 1:1

Responsivel: Milton Cortez | Data: 06/2011 | | Vers.: 1.00

PRODUCED BY AN AUTODESK EDUCATIONAL PRODUCT
