FeCoquito/Robot-s-design/RoboFEI 2014/Work in Progress 2014/Projeto Nova Frente/CAD/Batente direito.pdf

### PRODUCED BY AN AUTODESK EDUCATIONAL PRODUCT

4 M³

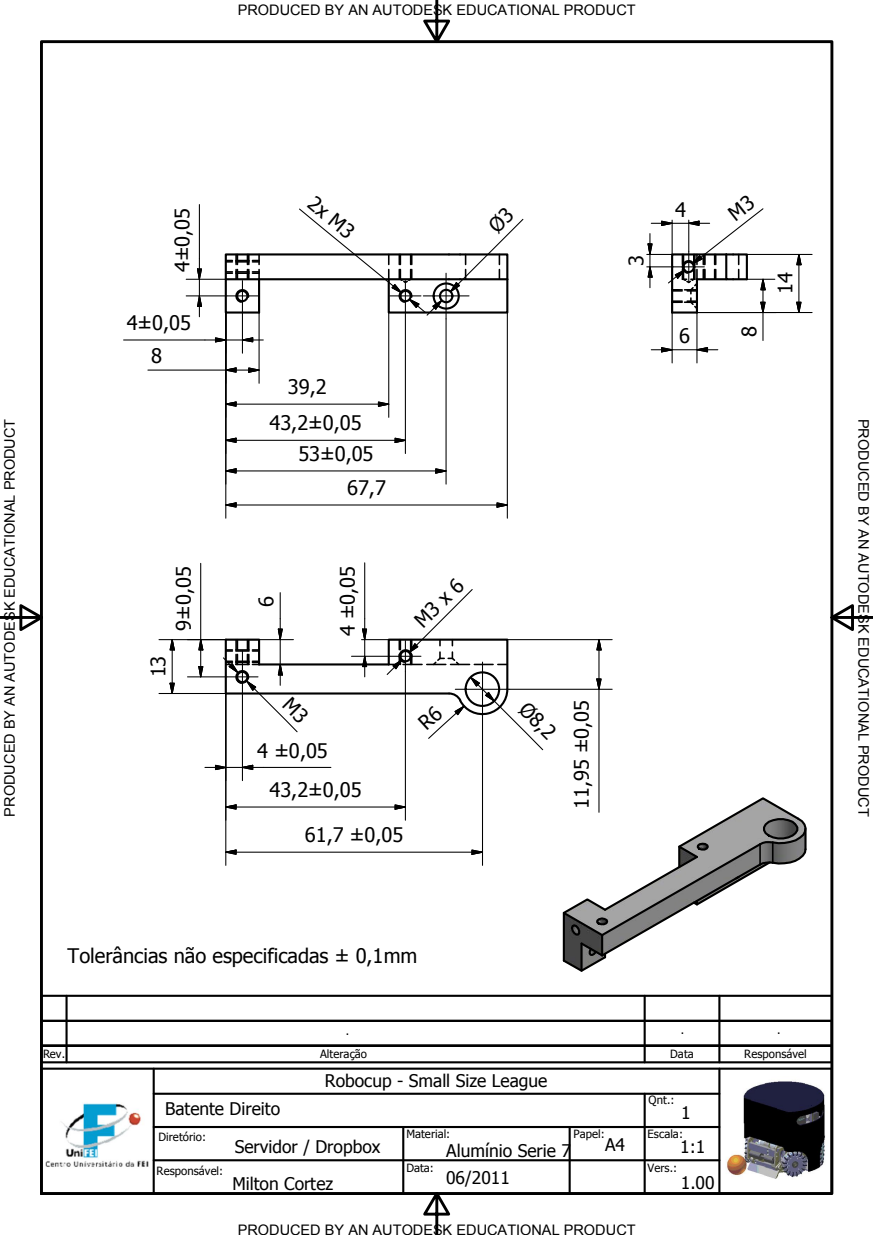
[picture p32: page 1]
TIO; A U T O D E S K E D U C A TIO

Tolerkncias nmo especificadas ± 0,1mm

Rev. | Alteraomo | Data | Responsivel

Robocup - Small Size League

Batente Direito | Qnt.: 1

D iretyrio: Servidor / Dropbox | Material: | Papel: A4 Alumtnio Serie 7 | Escala: 1:1

Responsivel: Milton Cortez | Data: 06/2011 | | Vers.: 1.00

PRODUCED BY AN AUTODESK EDUCATIONAL PRODUCT
