FeCoquito/Robot-s-design/RoboFEI 2014/Work in Progress 2014/Projeto Nova Frente/CAD/Batente Esquerdo.pdf

### PRODUCED BY AN AUTODESK EDUCATIONAL PRODUCT

4 ±0,05

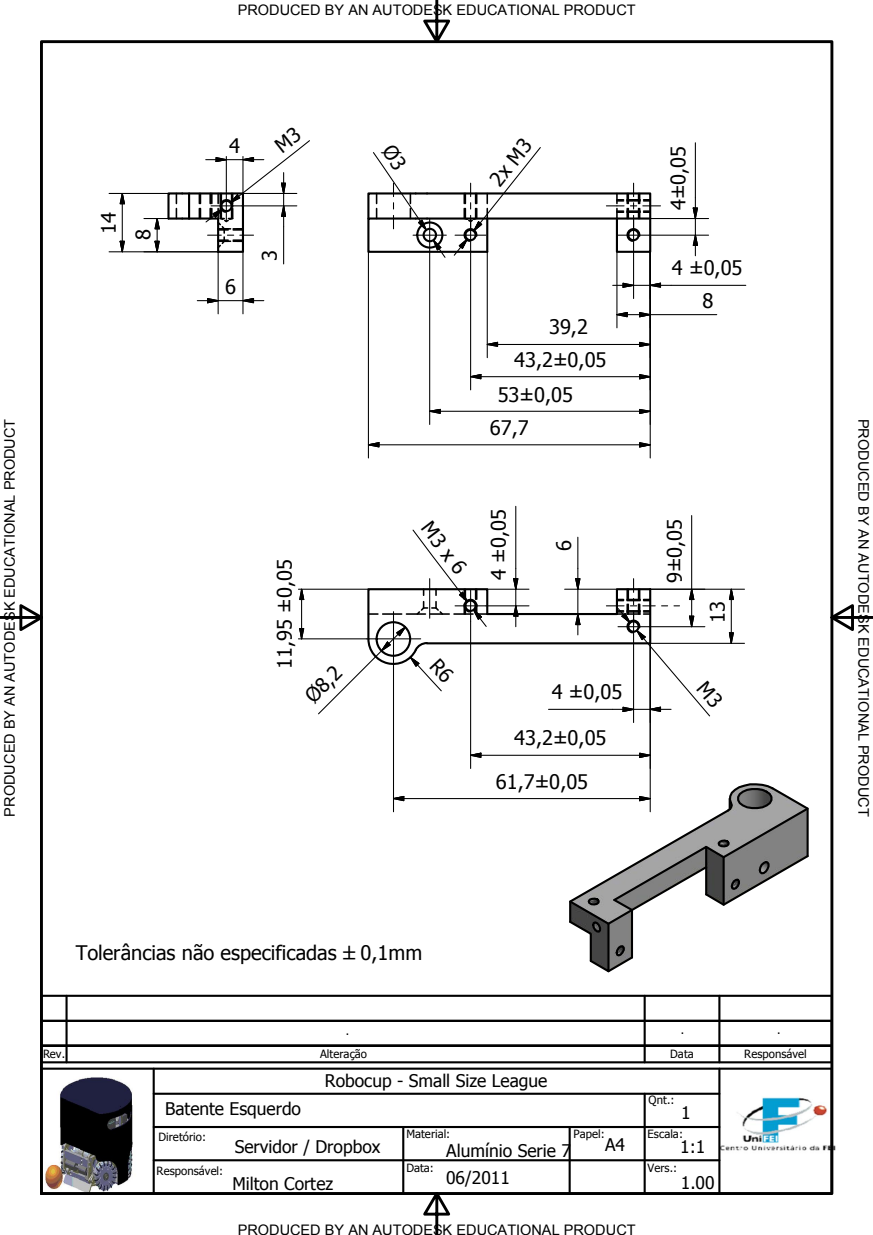
[picture p33: page 1]
TIO; A U T O D E S K E D U C A TIO

Tolerkncias nmo especificadas B0,1mm

Rev. | Alteraomo | Data | Responsivel

Robocup - Small Size League

Batente Esquerdo | Qnt.: 1

Diretyrio: Servidor / Dropbox | Material: Alumtnio Serie 7 | Papel: A4 | Escala: 1:1

Responsivel: Milton Cortez | Data: 06/2011 | | Vers.: 1.00

PRODUCED BY AN AUTODESK EDUCATIONAL PRODUCT
