FeCoquito/Robot-s-design/RoboFEI 2014/Work in Progress 2014/Projeto Nova Frente/CAD/Borracha.pdf

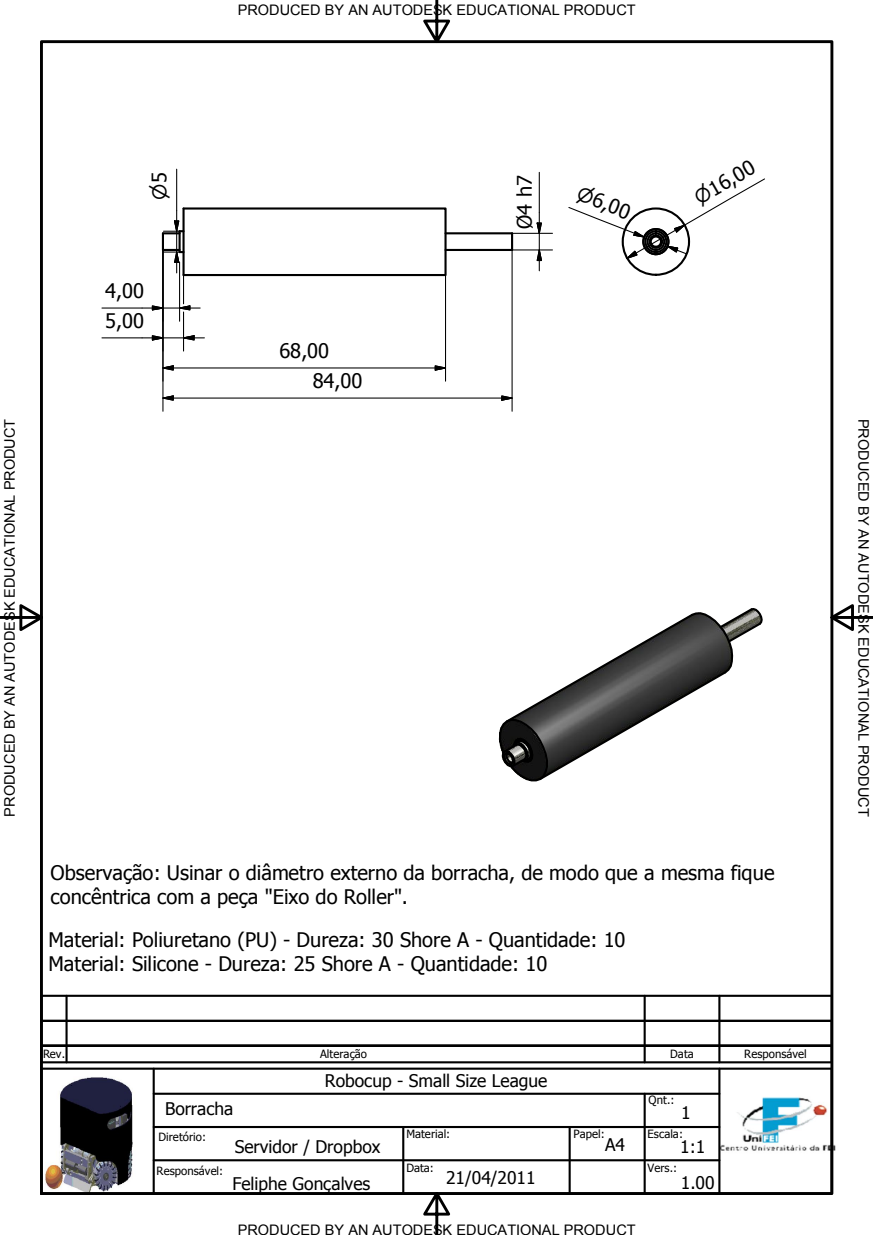
[picture p34: page 1]
TIO; A U T O D E S K E D U C A TIO; Rev.; Data; Responsivel; Alteraomo

PRODUCED BY AN AUTODESK EDUCATIONAL PRODUCT

Observaomo: Usinar o dikmetro externo da borracha, de modo que a mesma fique
concrntrica com a peoa "Eixo do Roller".

Material: Poliuretano (PU) - Dureza: 30 Shore A - Quantidade: 10
Material: Silicone - Dureza: 25 Shore A - Quantidade: 10

Robocup - Small Size League

Borracha | Qnt.: 1

Diretyrio: Servidor / Dropbox | Material: | Papel: A4 | Escala: 1:1

Responsivel: Feliphe Gonoalves | Data: 21/04/2011 | | Vers.: 1.00
