FeCoquito/Robot-s-design/RoboFEI 2014/Work in Progress 2014/Projeto Nova Frente/CAD/Chapa Inferior - Contorno.pdf

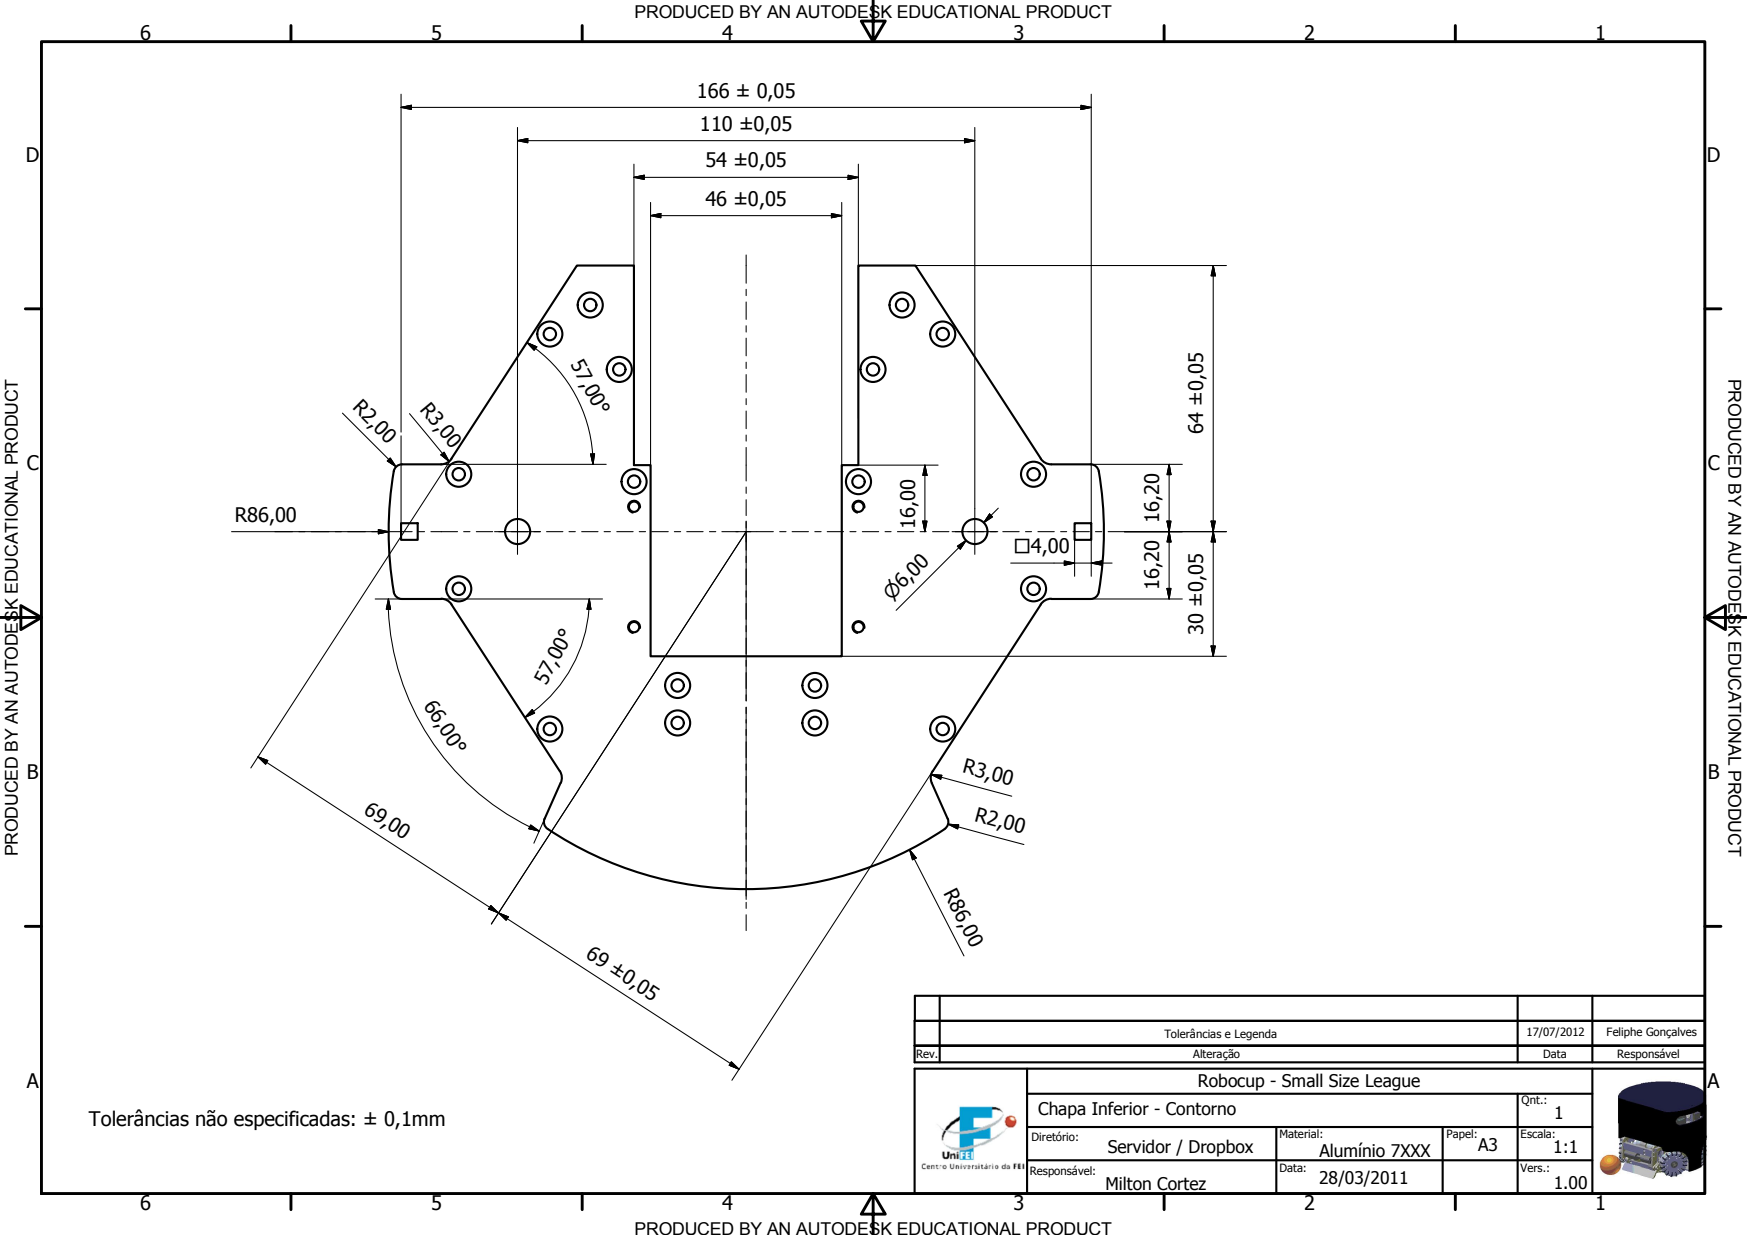
[picture p36: page 1]
TIO; P R O D U C E D B Y A N A U T O D E S K E D U C A TIO

PRODUCED BY AN AUTODESK EDUCATIONAL PRODUCT

Tolerkncias e Legenda | 17/07/2012 | Feliphe Gonoalves

Rev. | Alteraomo | Data | Responsivel

Robocup - Small Size League

Chapa Inferior - Contorno | Qnt.: 1

Tolerkncias nmo especificadas: ± 0,1mm

Diretyrio: Servidor / Dropbox | Material: Alumtnio 7XXX | Papel: A3 | Escala: 1:1

Responsivel: Milton Cortez | Data: 28/03/2011 | | Vers.: 1.00
