FeCoquito/Robot-s-design/RoboFEI 2014/Work in Progress 2014/Projeto Nova Frente/CAD/Chapa Inferior - Furação.pdf

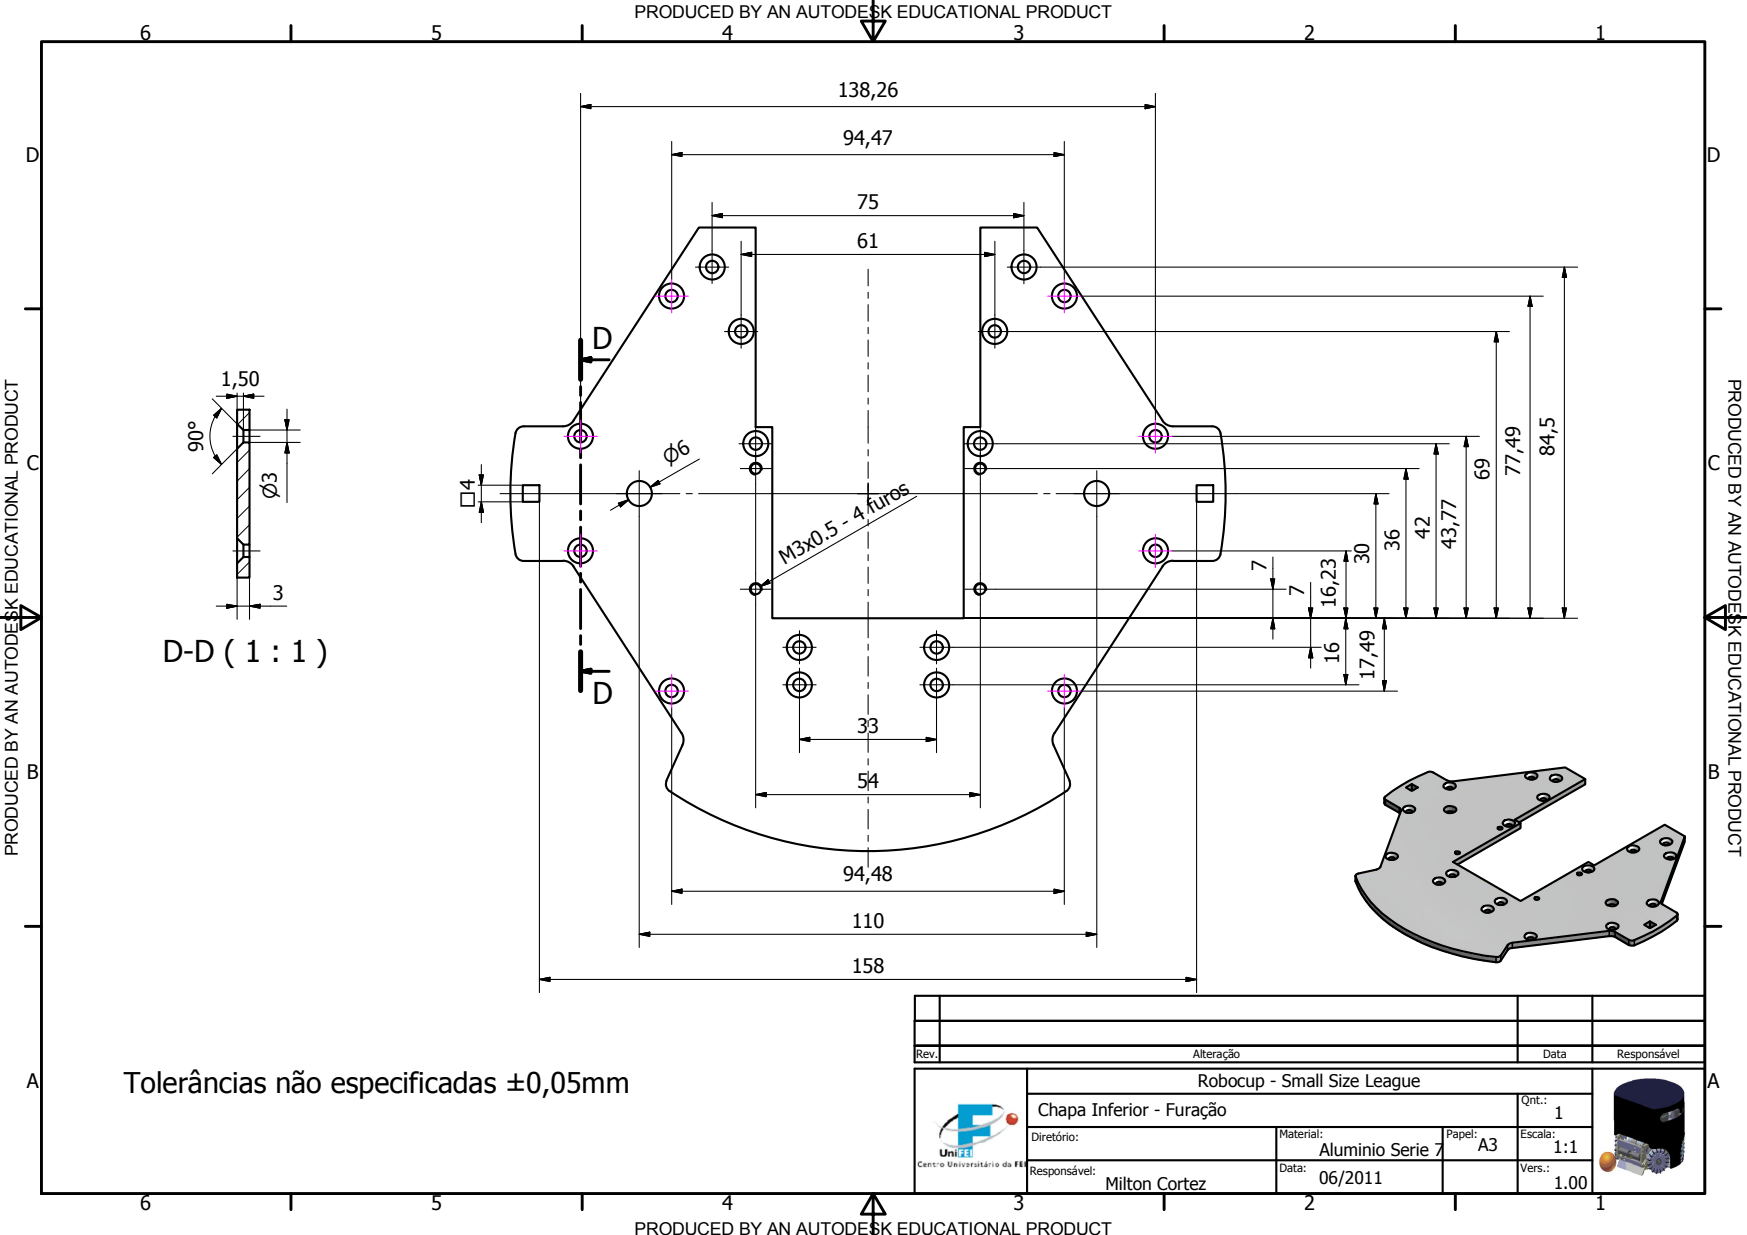
[picture p37: page 1]
TIO; P R O D U C E D B Y A N A U T O D E S K E D U C A TIO; Alteraomo; Rev.; Responsivel; Data; M3x0.5 - 4 furos

PRODUCED BY AN AUTODESK EDUCATIONAL PRODUCT

Tolerkncias nmo especificadas ±0,05mm

Robocup - Small Size League

Chapa Inferior - Furaomo | Qnt.: 1

Diretyrio: | Material: Aluminio Serie 7 | Papel: A3 | Escala: 1:1

Re M | Data: 06/2011 ilton Cortez | | Vers.: sponsivel: 1.00
