FeCoquito/Robot-s-design/RoboFEI 2014/Work in Progress 2014/Projeto Nova Frente/CAD/Chapa Lateral - Direita.pdf

### PRODUCED BY AN AUTODESK EDUCATIONAL PRODUCT

43,64

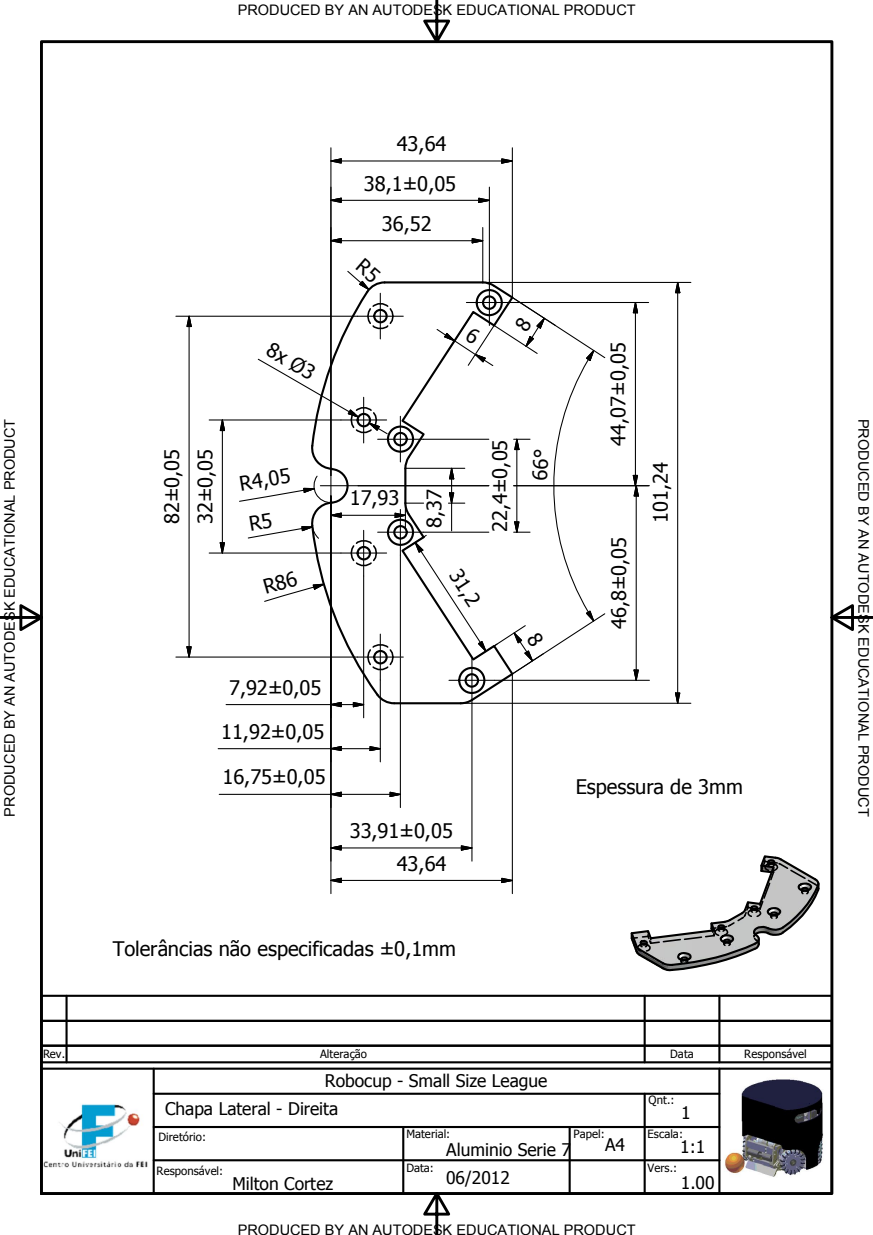
[picture p38: page 1]
TIO; A U T O D E S K E D U C A TIO; Responsivel:; Milton Cortez; Vers.:; Data:; Rev.; Alteraomo; Data; Responsivel; Espessura de 3mm

Tolerkncias nmo especificadas ±0,1mm

Robocup - Small Size League

Chapa Lateral - Direita | Qnt.: 1

Diretyrio: | Material: Aluminio Serie 7 | Papel: A4 | Escala: 1:1

PRODUCED BY AN AUTODESK EDUCATIONAL PRODUCT
