FeCoquito/Robot-s-design/RoboFEI 2014/Work in Progress 2014/Projeto Nova Frente/CAD/Chapa Superior.pdf

### PRODUCED BY AN AUTODESK EDUCATIONAL PRODUCT

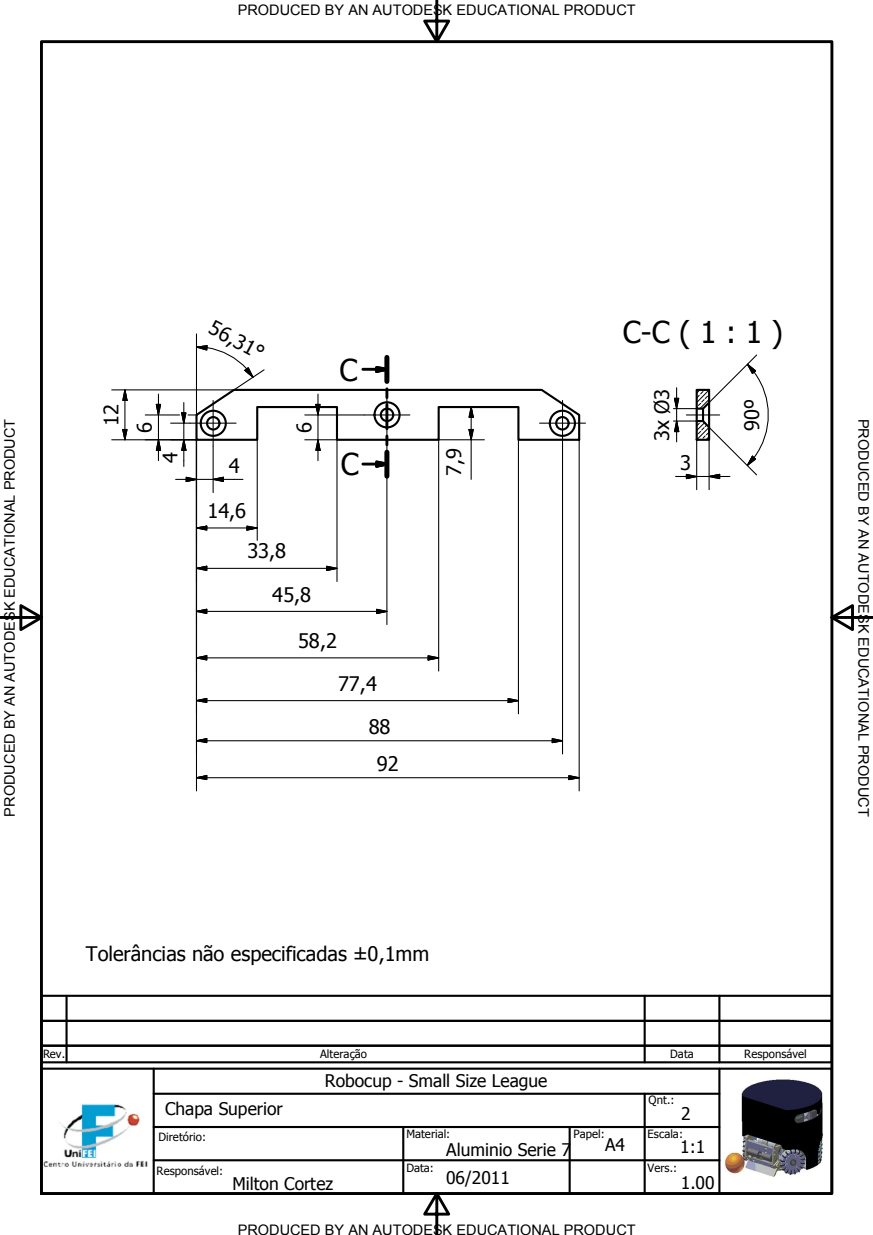
[picture p39: page 1]
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

Tolerkncias nmo especificadas ±0,1mm

Robocup - Small Size League

Chapa Superior | Qnt.: 2

Diretyrio: | Material: Aluminio Serie 7 | Papel: A4 | Escala: 1:1

PRODUCED BY AN AUTODESK EDUCATIONAL PRODUCT
