FeCoquito/Robot-s-design/RoboFEI 2014/Work in Progress 2014/Projeto Nova Frente/CAD/Chip kick.pdf

A
84

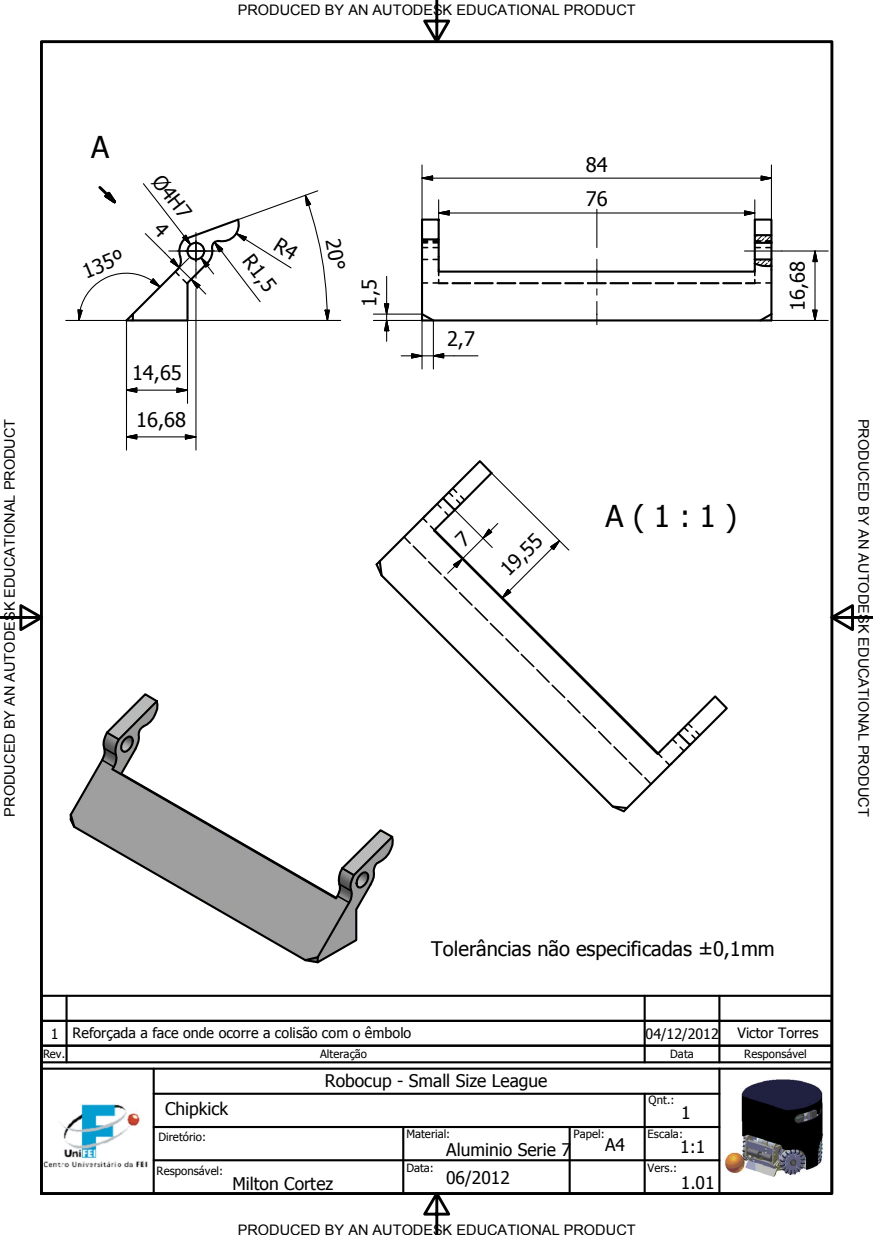
[picture p40: page 1]
TIO; A U T O D E S K E D U C A TIO; Responsivel:; Milton Cortez; Vers.:; Data:; Rev.; Alteraomo; Data; Responsivel; Reforoada a face onde ocorre a colismo com o rmbolo; Victor Torres

PRODUCED BY AN AUTODESK EDUCATIONAL PRODUCT

Tolerkncias nmo especificadas ±0,1mm

Robocup - Small Size League

Chipkick | Qnt.: 1

Diretyrio: | Material: Aluminio Serie 7 | Papel: A4 | Escala: 1:1
