FeCoquito/Robot-s-design/RoboFEI 2014/Work in Progress 2014/Projeto Nova Frente/CAD/Corpo do Êmbolo.pdf

### PRODUCED BY AN AUTODESK EDUCATIONAL PRODUCT

20

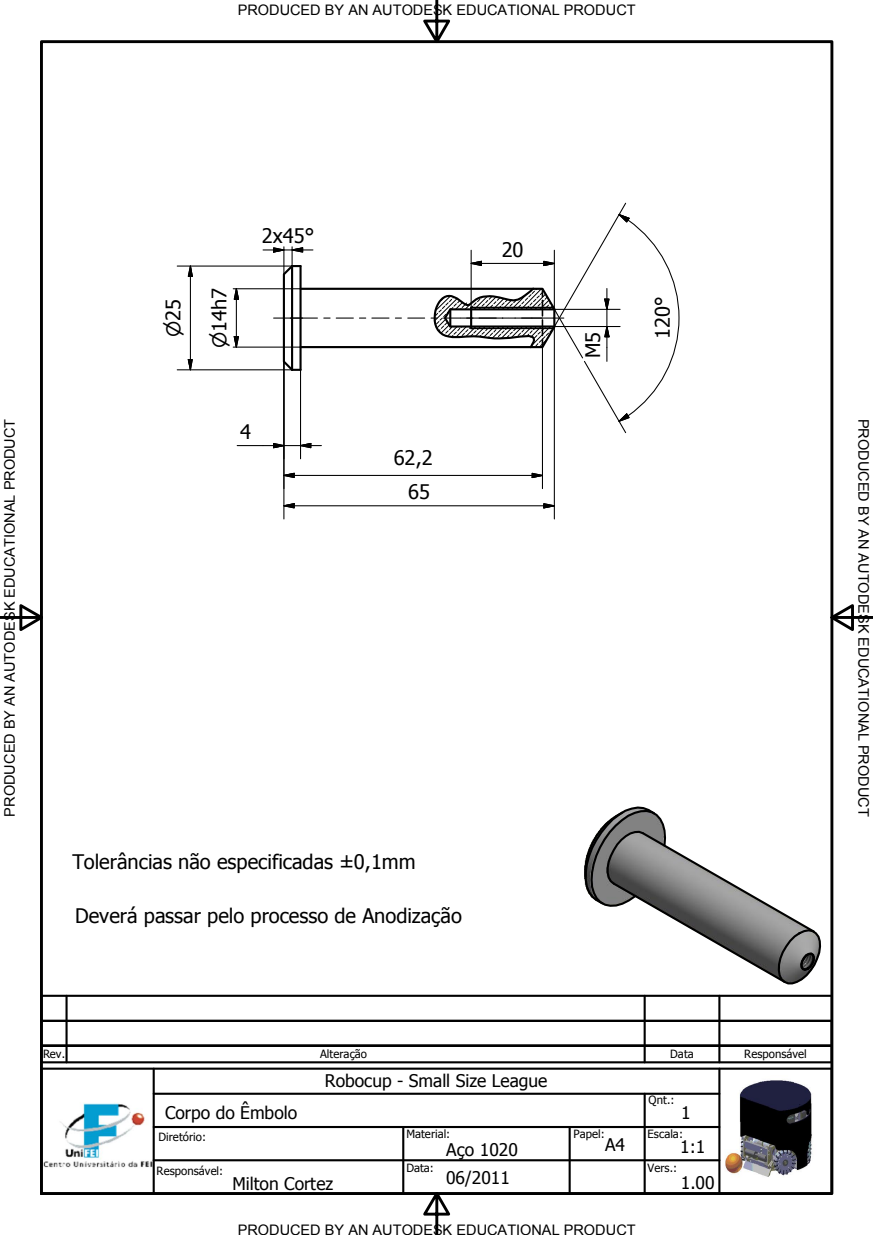
[picture p41: page 1]
TIO; A U T O D E S K E D U C A TIO; Alteraomo; Data; Responsivel; Rev.

Tolerkncias nmo especificadas ±0,1mm

Deveri passar pelo processo de Anodizaomo

Robocup - Small Size League

Corpo do Çmbolo | Qnt.: 1

Diretyrio: | Material: Aoo 1020 | Papel: A4 | Escala: 1:1

Responsivel: Milton Cortez | Data: 06/2011 | | Vers.: 1.00

PRODUCED BY AN AUTODESK EDUCATIONAL PRODUCT
