FeCoquito/Robot-s-design/RoboFEI 2014/Work in Progress 2014/Projeto Nova Frente/CAD/Eixo 4.4.pdf

### PRODUCED BY AN AUTODESK EDUCATIONAL PRODUCT

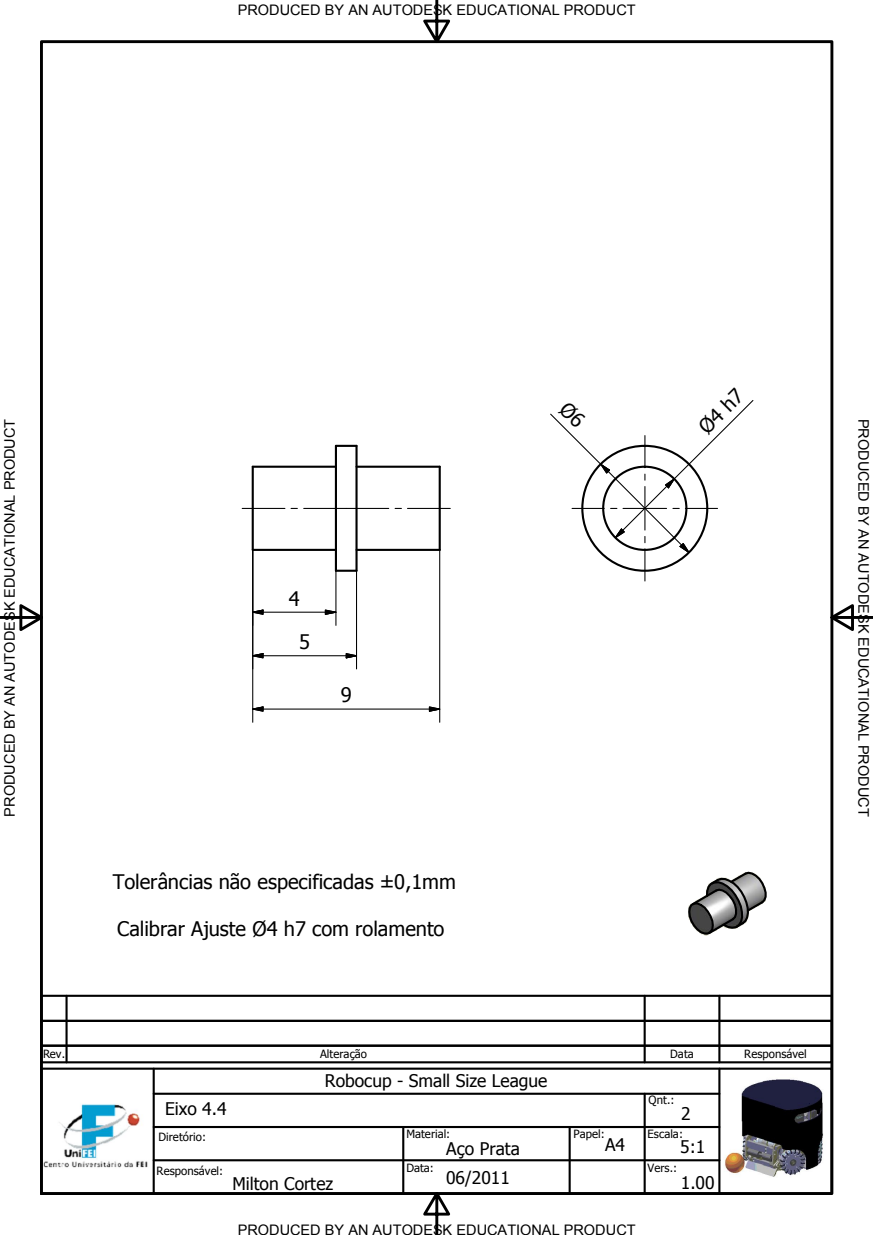
[picture p42: page 1]
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

Tolerkncias nmo especificadas ±0,1mm

Calibrar Ajuste Ø4 h7 com rolamento

Robocup - Small Size League

Eixo 4.4 | Qnt.: 2

Diretyrio: | Material: Aoo Prata | Papel: A4 | Escala: 5:1

PRODUCED BY AN AUTODESK EDUCATIONAL PRODUCT
