FeCoquito/Robot-s-design/RoboFEI 2014/Work in Progress 2014/Projeto Nova Frente/CAD/Eixo do roller.pdf

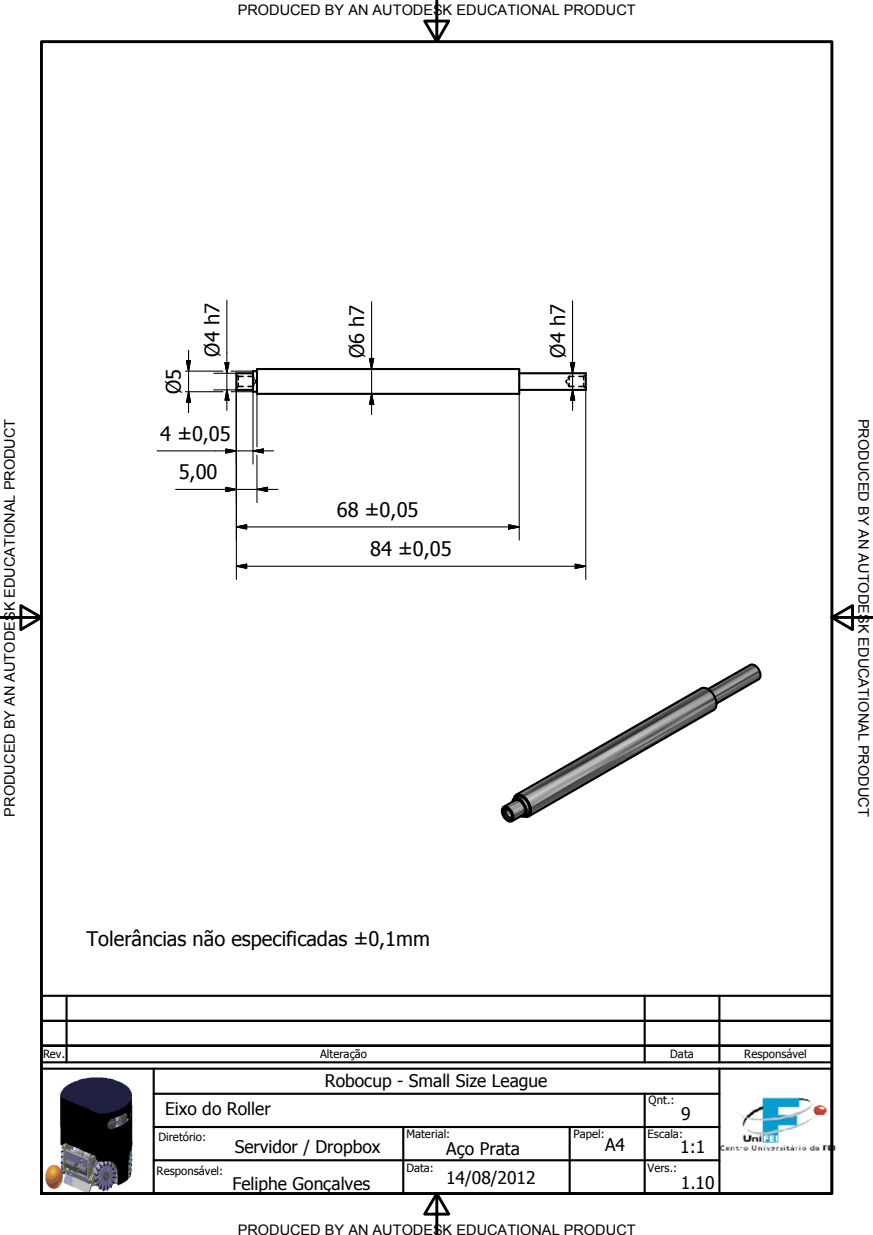
[picture p44: page 1]
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

PRODUCED BY AN AUTODESK EDUCATIONAL PRODUCT

Tolerkncias nmo especificadas ±0,1mm

Robocup - Small Size League

Eixo do Roller | Qnt.: 9

Diretyrio: Servidor / Dropbox | Material: Aoo Prata | Papel: A4 | Escala: 1:1

Responsivel: Feliphe Gonoalves | Data: 14/08/2012 | | Vers.: 1.10
