FeCoquito/Robot-s-design/RoboFEI 2014/Work in Progress 2014/Projeto Nova Frente/CAD/Eixo.pdf

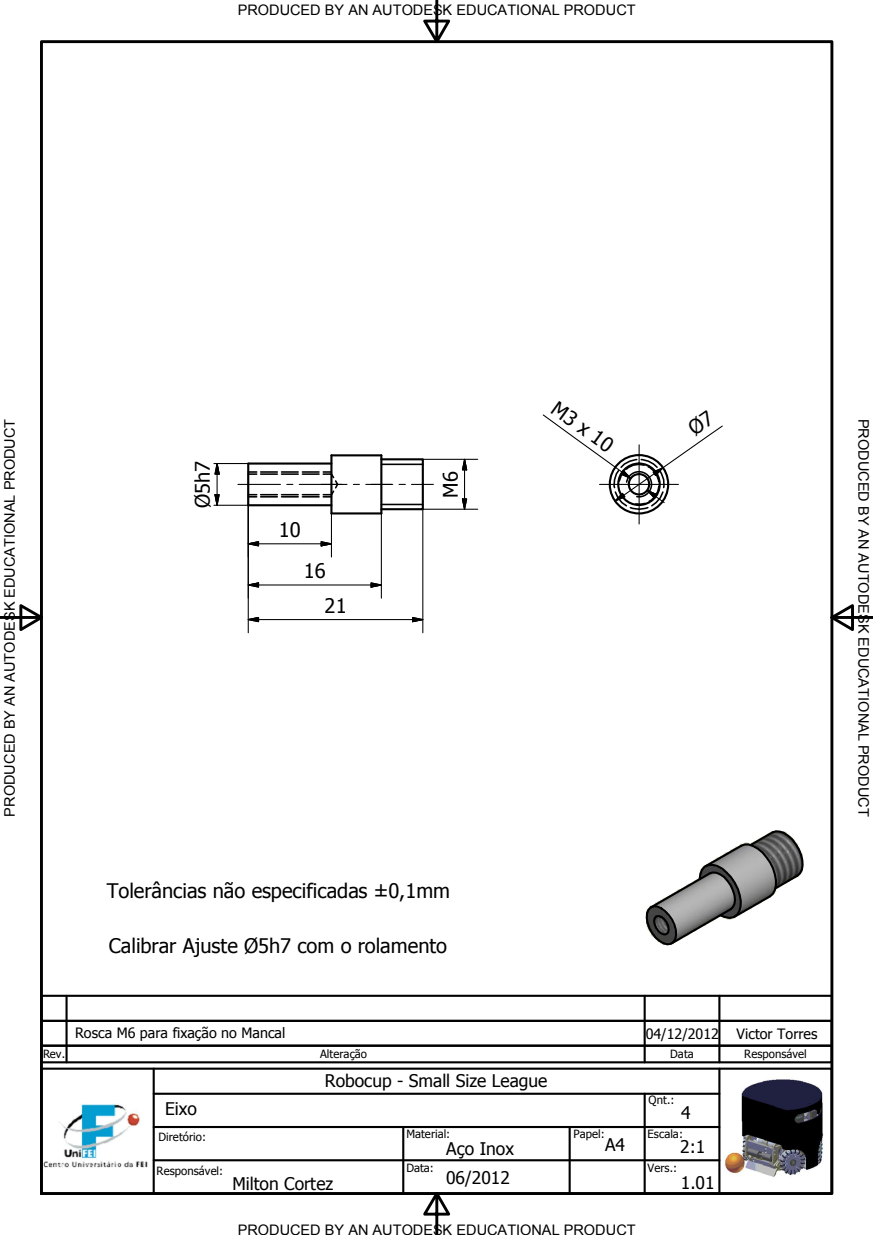
[picture p45: page 1]
TIO; A U T O D E S K E D U C A TIO; Responsivel:; Milton Cortez; Vers.:; Data:; Rev.; Alteraomo; Data; Responsivel; Rosca M6 para fixaomo no Mancal; Victor Torres

PRODUCED BY AN AUTODESK EDUCATIONAL PRODUCT

Tolerkncias nmo especificadas ±0,1mm

Calibrar Ajuste Ø5h7 com o rolamento

Robocup - Small Size League

Eixo | Qnt.: 4

Diretyrio: | Material: Aoo Inox | Papel: A4 | Escala: 2:1
