FeCoquito/Robot-s-design/RoboFEI 2014/Work in Progress 2014/Projeto Nova Frente/CAD/Espaçador - Capacitores.pdf

### PRODUCED BY AN AUTODESK EDUCATIONAL PRODUCT

6,6

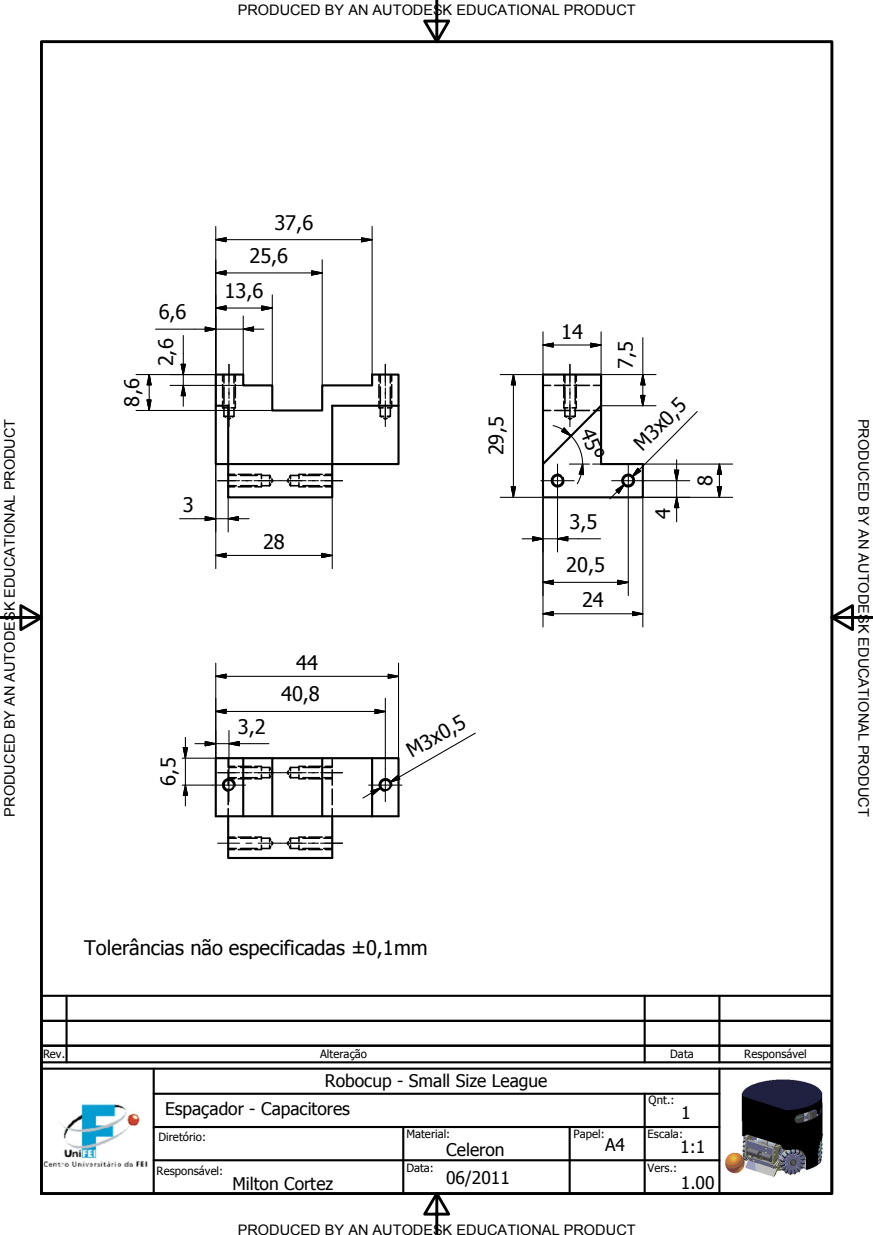
[picture p46: page 1]
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

Tolerkncias nmo especificadas ±0,1mm

Robocup - Small Size League

Espaoador - Capacitores | Qnt.: 1

Diretyrio: | Material: Celeron | Papel: A4 | Escala: 1:1

PRODUCED BY AN AUTODESK EDUCATIONAL PRODUCT
