FeCoquito/Robot-s-design/RoboFEI 2014/Work in Progress 2014/Projeto Nova Frente/CAD/Espaçador da roda.pdf

### PRODUCED BY AN AUTODESK EDUCATIONAL PRODUCT

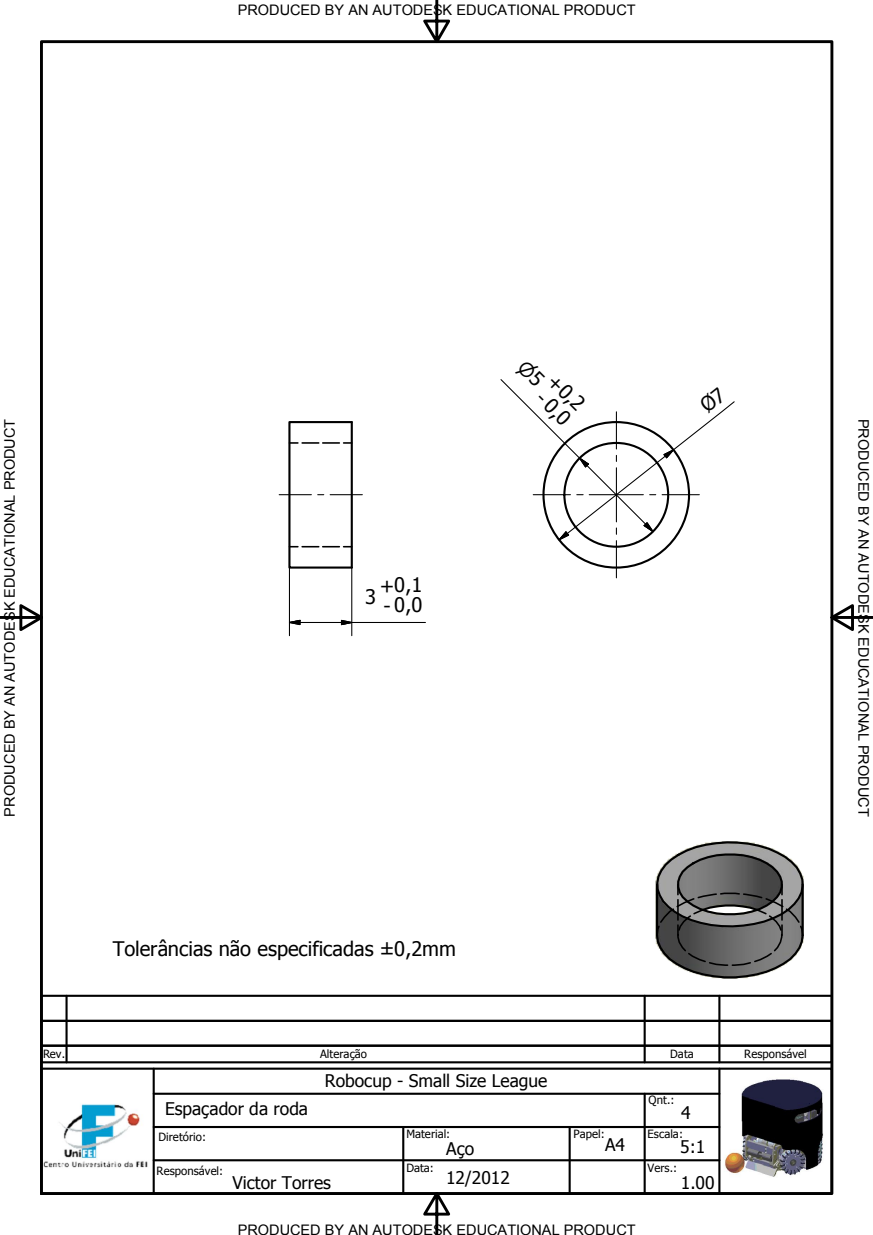
[picture p47: page 1]
TIO; A U T O D E S K E D U C A TIO; Responsivel:; Victor Torres; Vers.:; Data:; Rev.; Alteraomo; Data; Responsivel

Tolerkncias nmo especificadas ±0,2mm

Robocup - Small Size League

Espaoador da roda | Qnt.: 4

Diretyrio: | Material: Aoo | Papel: A4 | Escala: 5:1

PRODUCED BY AN AUTODESK EDUCATIONAL PRODUCT
