FeCoquito/Robot-s-design/RoboFEI 2014/Work in Progress 2014/Projeto Nova Frente/CAD/Espaçadores de Nylon.pdf

### PRODUCED BY AN AUTODESK EDUCATIONAL PRODUCT

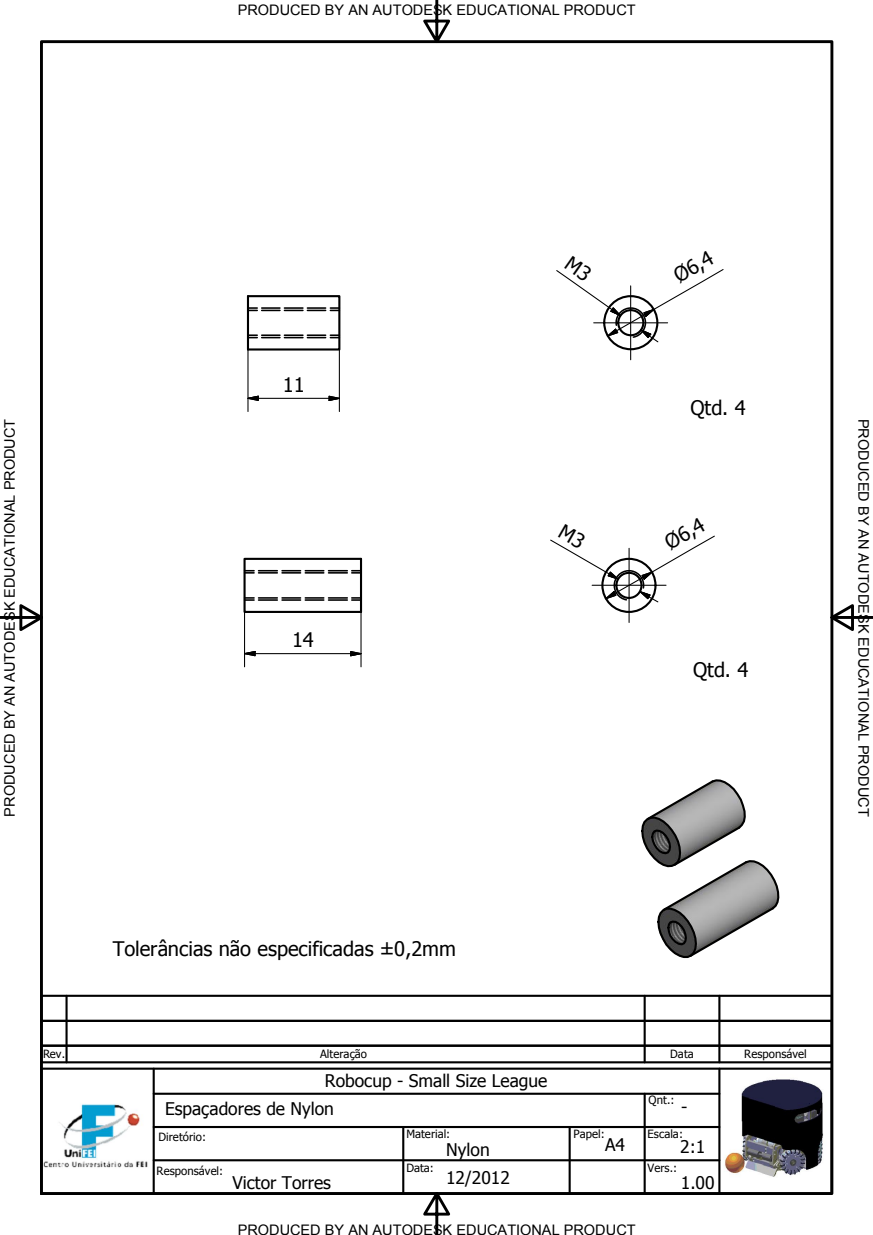
[picture p48: page 1]
TIO; A U T O D E S K E D U C A TIO; Responsivel:; Victor Torres; Vers.:; Data:; Rev.; Alteraomo; Data; Responsivel; Qtd. 4

Tolerkncias nmo especificadas ±0,2mm

Robocup - Small Size League

Espaoadores de Nylon | Qnt.: -

Diretyrio: | Material: Nylon | Papel: A4 | Escala: 2:1

PRODUCED BY AN AUTODESK EDUCATIONAL PRODUCT
