FeCoquito/Robot-s-design/RoboFEI 2014/Work in Progress 2014/Projeto Nova Frente/CAD/Flat.pdf

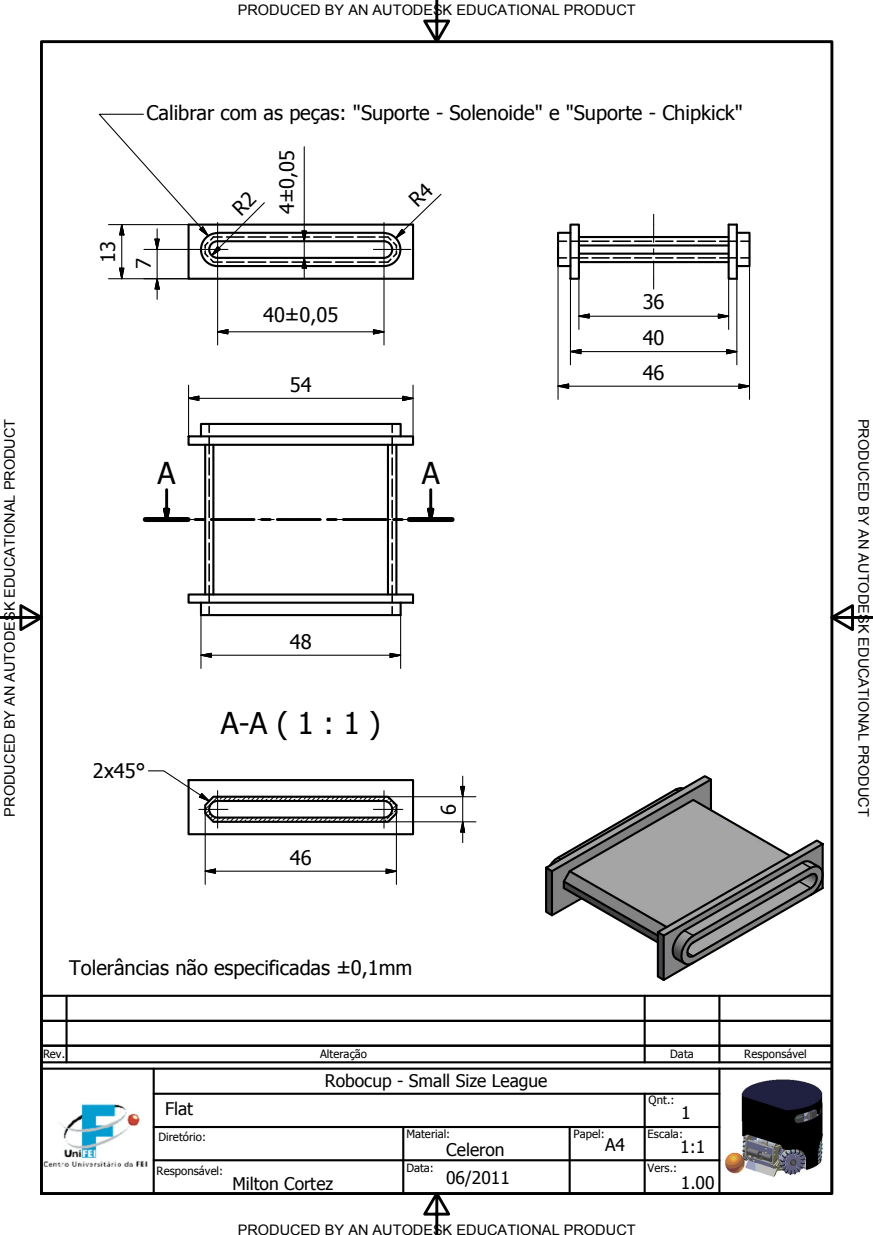
[picture p49: page 1]
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

PRODUCED BY AN AUTODESK EDUCATIONAL PRODUCT

Calibrar com as peoas: "Suporte - Solenoide" e "Suporte - Chipkick"

Tolerkncias nmo especificadas ±0,1mm

Robocup - Small Size League

Flat | Qnt.: 1

Diretyrio: | Material: Celeron | Papel: A4 | Escala: 1:1
