FeCoquito/Robot-s-design/RoboFEI 2014/Work in Progress 2014/Projeto Nova Frente/CAD/Haste do êmbolo.pdf

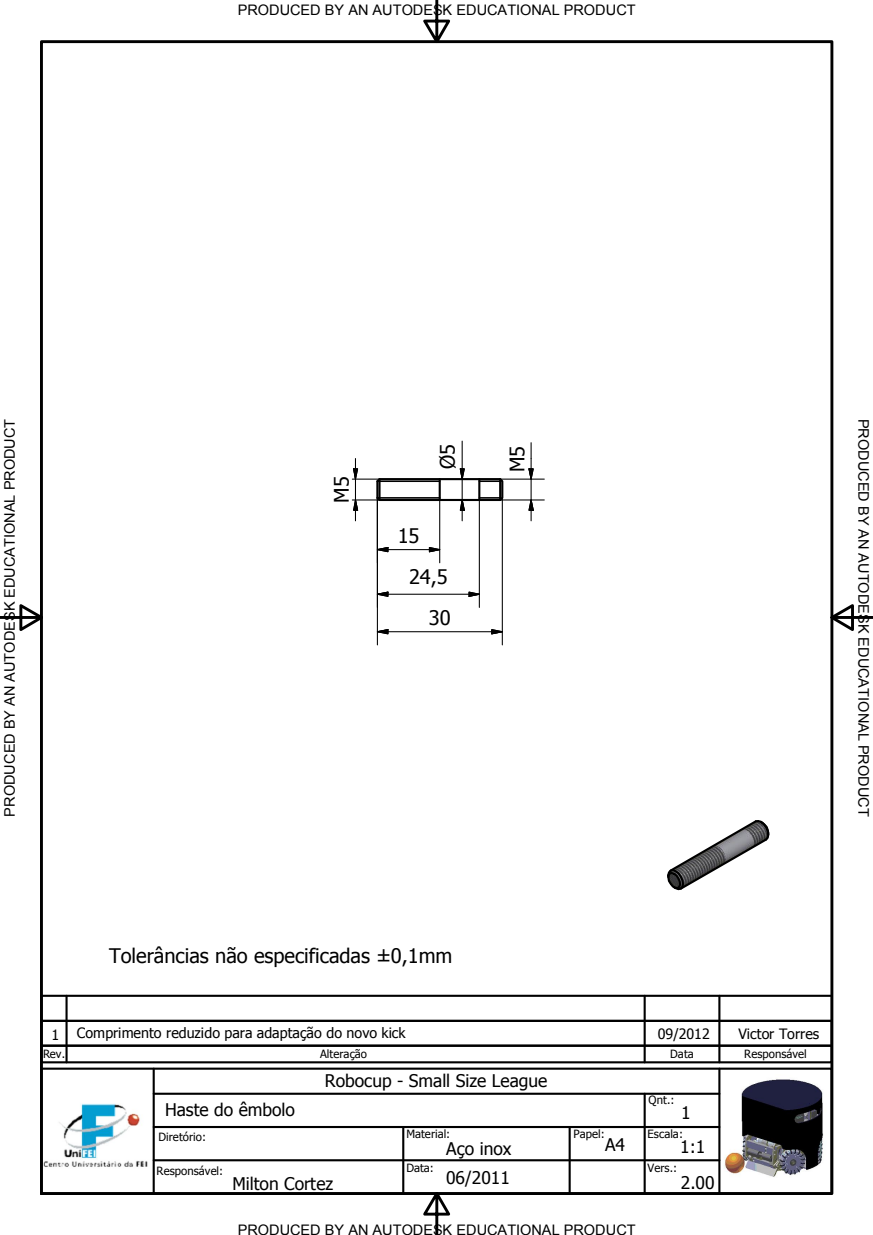
[picture p51: page 1]
TIO; A U T O D E S K E D U C A TIO; Responsivel:; Milton Cortez; Vers.:; Data:; Rev.; Alteraomo; Data; Responsivel; Comprimento reduzido para adaptaomo do novo kick; Victor Torres

PRODUCED BY AN AUTODESK EDUCATIONAL PRODUCT

Tolerkncias nmo especificadas ±0,1mm

Robocup - Small Size League

Haste do rmbolo | Qnt.: 1

Diretyrio: | Material: Aoo inox | Papel: A4 | Escala: 1:1
