FeCoquito/Robot-s-design/RoboFEI 2014/Work in Progress 2014/Projeto Nova Frente/CAD/Kick Modificado.pdf

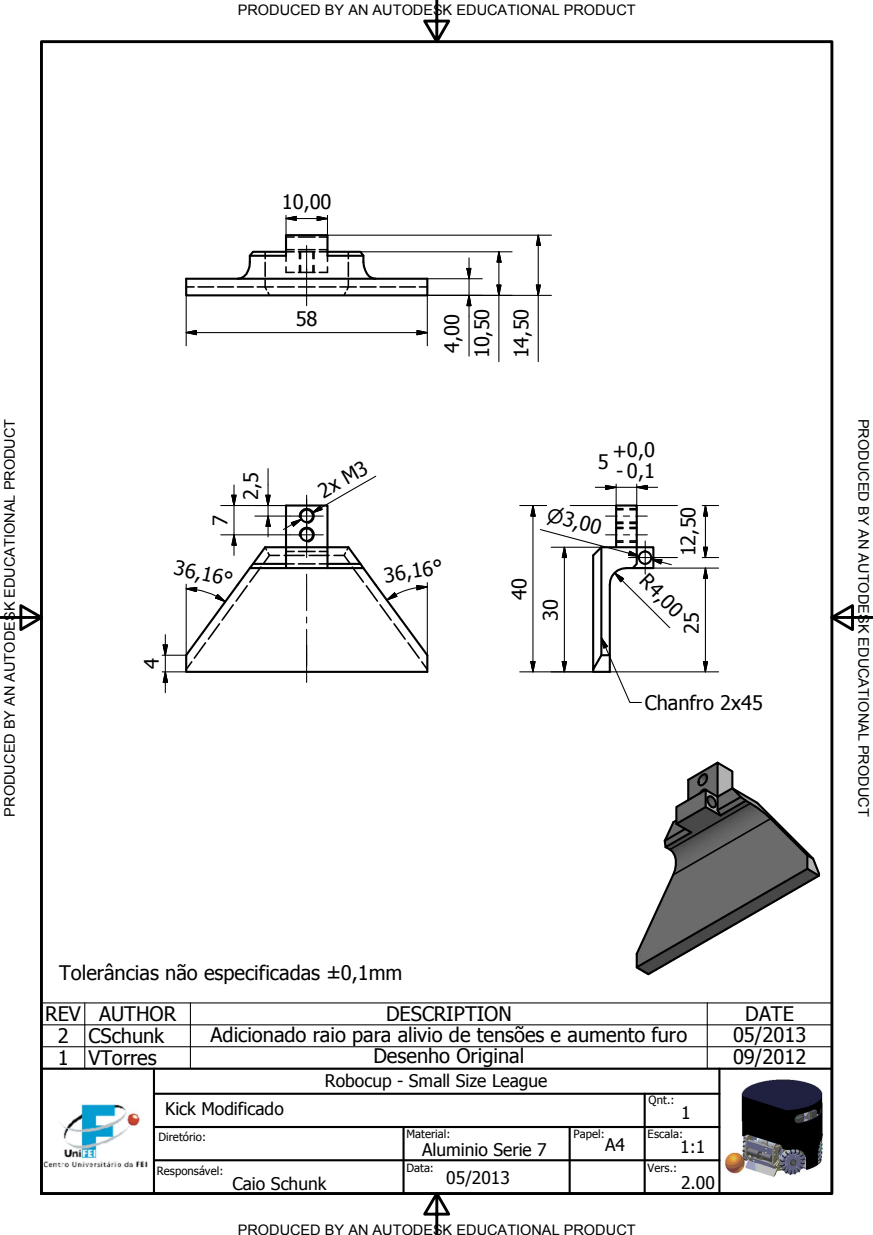
[picture p52: page 1]
TIO; A U T O D E S K E D U C A TIO; Responsivel:; Caio Schunk; Vers.:; Data:; Chanfro 2x45; REV; AUTHOR; DESCRIPTION; DATE; CSchunk; Adicionado raio para alivio de tens}es e aumento furo; VTorres; Desenho Original

PRODUCED BY AN AUTODESK EDUCATIONAL PRODUCT

Tolerkncias nmo especificadas ±0,1mm

Robocup - Small Size League

Kick Modificado | Qnt.: 1

Diretyrio: | Material: Aluminio Serie 7 | Papel: A4 | Escala: 1:1
