FeCoquito/Robot-s-design/RoboFEI 2014/Work in Progress 2014/Projeto Nova Frente/CAD/Lateral.pdf

30

37

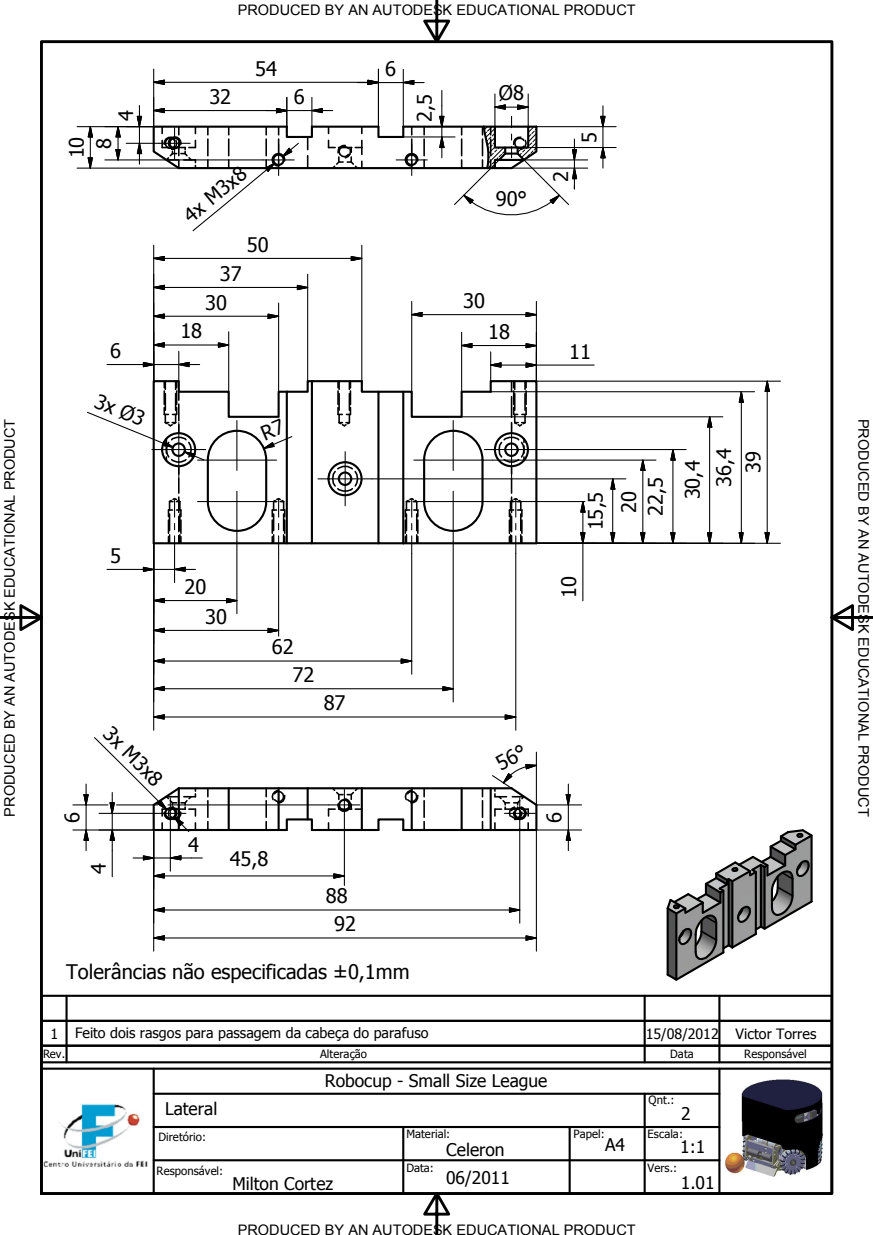
[picture p53: page 1]
TIO; A U T O D E S K E D U C A TIO; Responsivel:; Milton Cortez; Vers.:; Data:; Rev.; Alteraomo; Data; Responsivel; Feito dois rasgos para passagem da cabeoa do parafuso; Victor Torres

PRODUCED BY AN AUTODESK EDUCATIONAL PRODUCT

Tolerkncias nmo especificadas ±0,1mm

Robocup - Small Size League

Lateral | Qnt.: 2

Diretyrio: | Material: Celeron | Papel: A4 | Escala: 1:1
