FeCoquito/Robot-s-design/RoboFEI 2014/Work in Progress 2014/Projeto Nova Frente/CAD/Mancal Articulado - Direito.pdf

A | C

### PRODUCED BY AN AUTODESK EDUCATIONAL PRODUCT

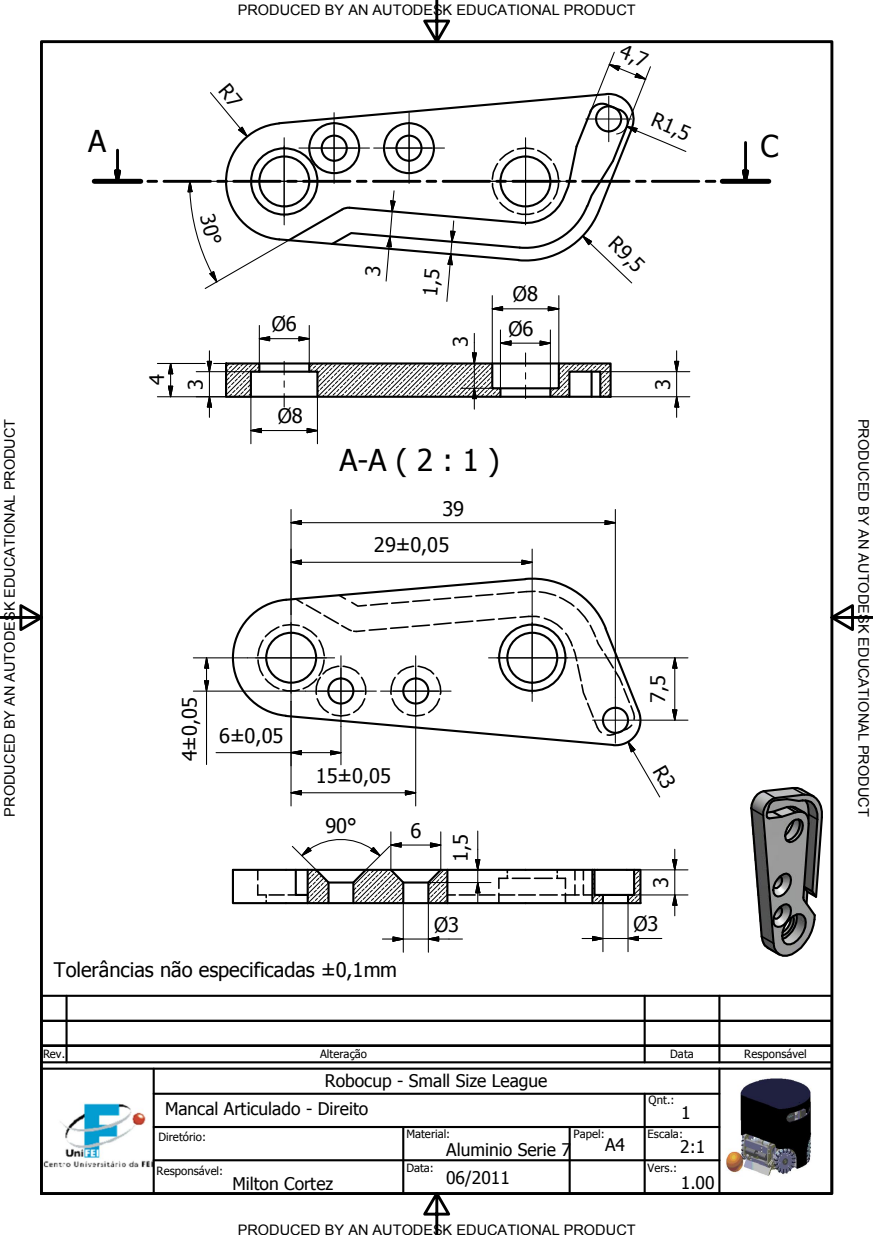
[picture p54: page 1]
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

Tolerkncias nmo especificadas ±0,1mm

Robocup - Small Size League

Mancal Articulado - Direito | Qnt.: 1

Diretyrio: | Material: Aluminio Serie 7 | Papel: A4 | Escala: 2:1

Responsivel: Milton Cortez | Data: 06/2011 | | Vers.: 1.00

PRODUCED BY AN AUTODESK EDUCATIONAL PRODUCT
