FeCoquito/Robot-s-design/RoboFEI 2014/Work in Progress 2014/Projeto Nova Frente/CAD/Mancal Chipkick - Direito.pdf

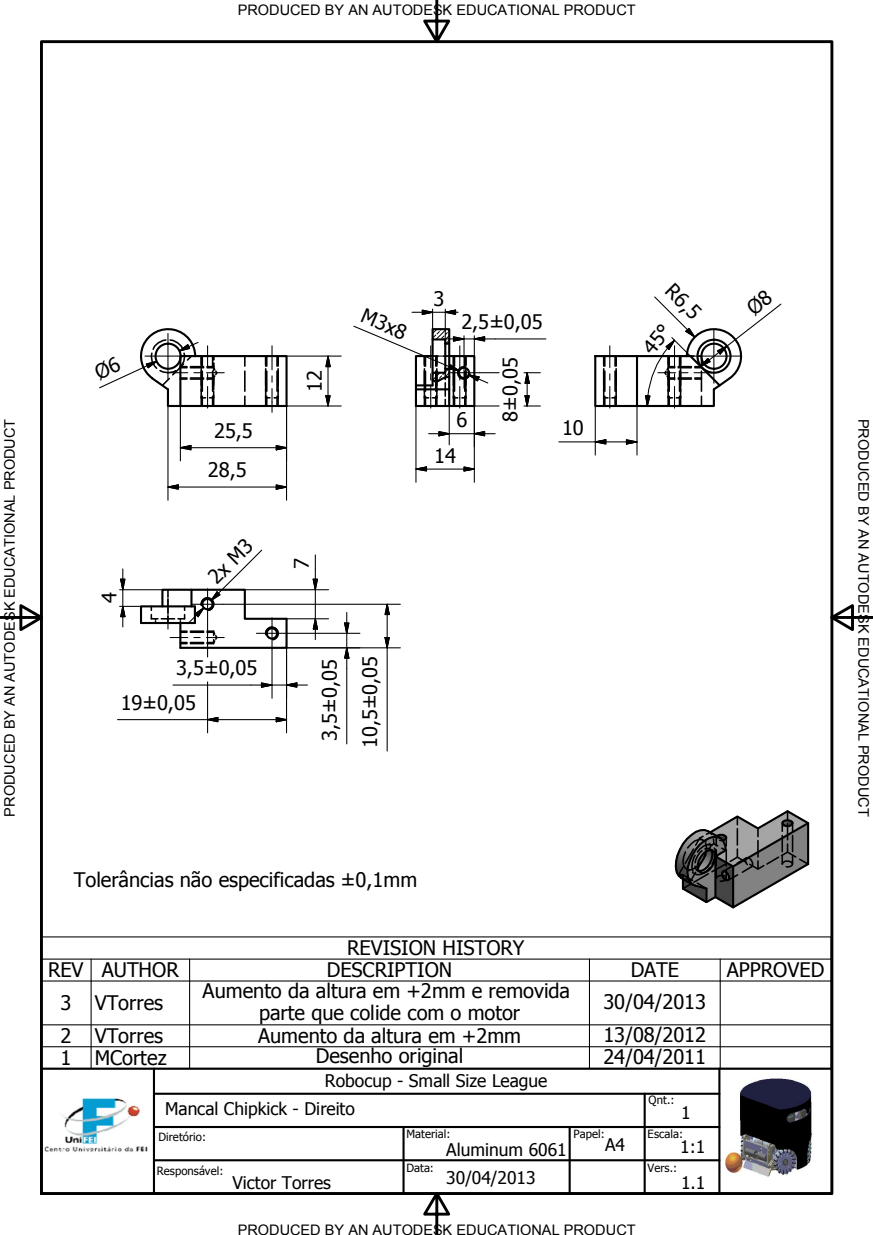
[picture p56: page 1]
TIO; A U T O D E S K E D U C A TIO; REVISION HISTORY; REV; AUTHOR; DESCRIPTION; DATE; APPROVED; VTorres; Aumento da altura em +2mm; MCortez; Desenho original

PRODUCED BY AN AUTODESK EDUCATIONAL PRODUCT

Tolerkncias nmo especificadas ±0,1mm

Aumento da altura em +2mm e removida
parte que colide com o motor

Robocup - Small Size League

Mancal Chipkick - Direito | Qnt.: 1

Diretyrio: | Material: Aluminum 6061 | Papel: A4 | Escala: 1:1

Re Victor Torres | Data: 30/04/2013 | | Vers.: sponsivel: 1.1
