FeCoquito/Robot-s-design/RoboFEI 2014/Work in Progress 2014/Projeto Nova Frente/CAD/Mancal Direito.pdf

A-A ( 1 : 1 )
A

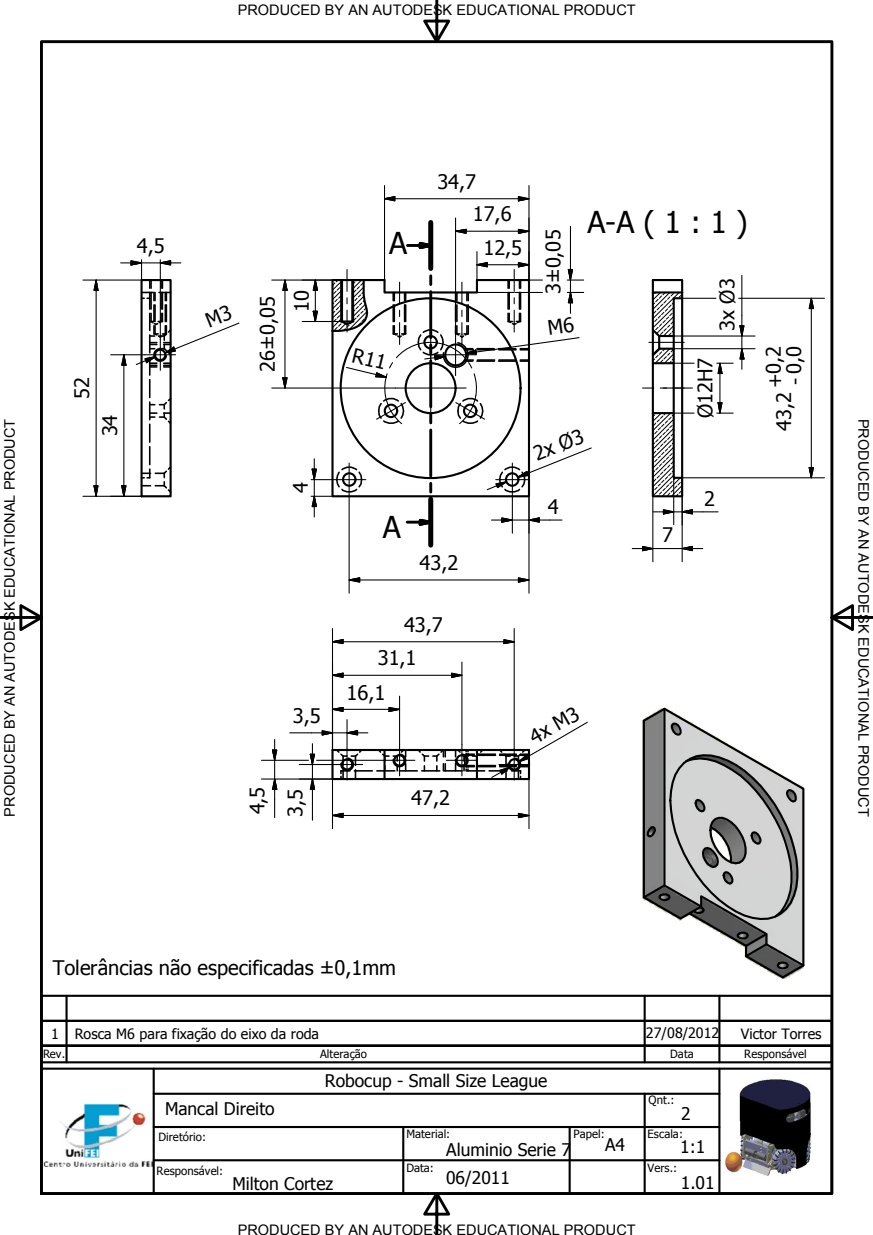
[picture p57: page 1]
TIO; A U T O D E S K E D U C A TIO

PRODUCED BY AN AUTODESK EDUCATIONAL PRODUCT

Tolerkncias nmo especificadas ±0,1mm

1 | Rosca M6 para fixaomo do eixo da roda | 27/08/2012 | Victor Torres

Rev. | Alteraomo | Data | Responsivel

Robocup - Small Size League

Mancal Direito | Qnt.: 2

Diretyrio: | Material: Aluminio Serie 7 | Papel: A4 | Escala: 1:1

Responsivel: Milton Cortez | Data: 06/2011 | | Vers.: 1.01
