FeCoquito/Robot-s-design/RoboFEI 2014/Work in Progress 2014/Projeto Nova Frente/CAD/Mancal Esquerdo.pdf

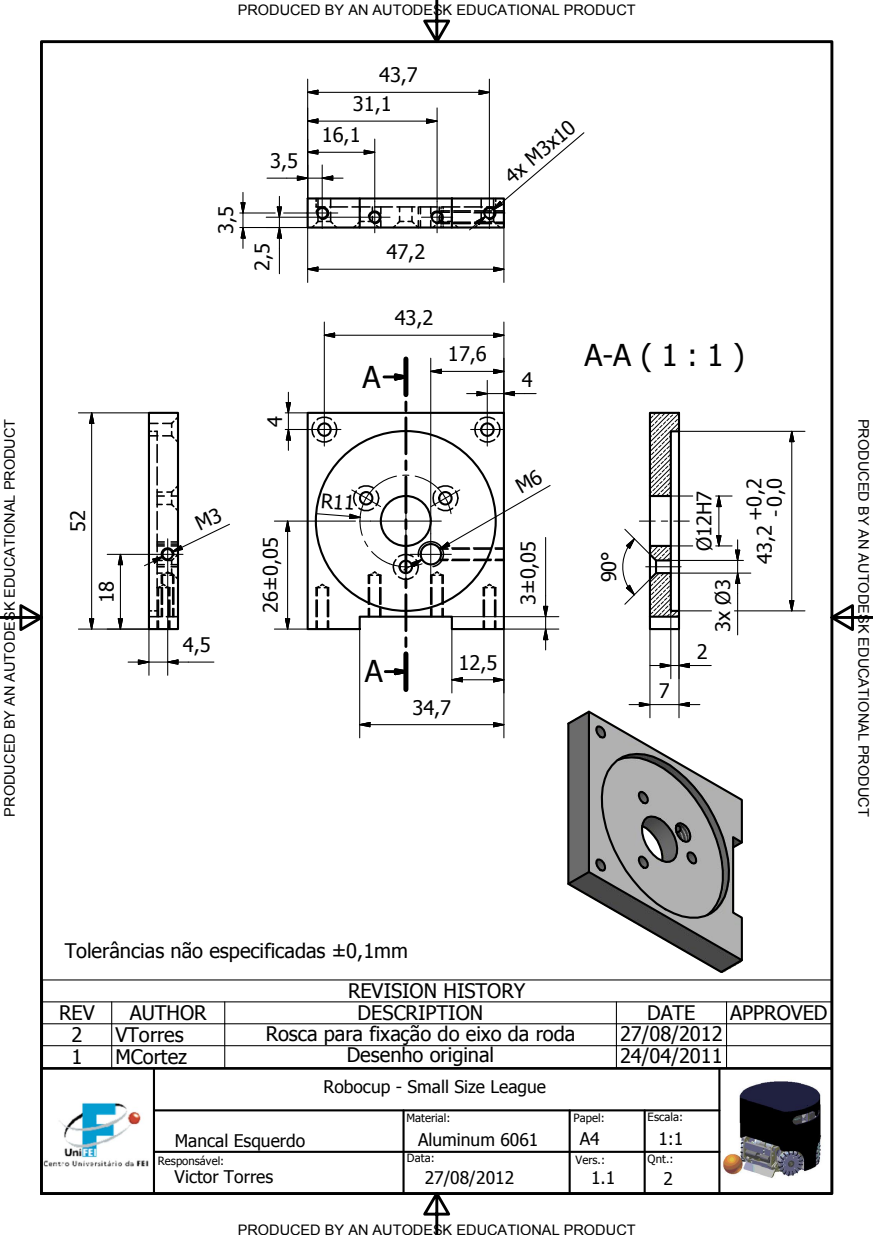
[picture p58: page 1]
TIO; A U T O D E S K E D U C A TIO; Qnt.:; Escala:; Responsivel:; Victor Torres; Material:; Mancal Esquerdo; Aluminum 6061; Vers.:; Papel:; Data:; REVISION HISTORY; REV; AUTHOR; DESCRIPTION; DATE; APPROVED; VTorres; Rosca para fixaomo do eixo da roda; MCortez; Desenho original

PRODUCED BY AN AUTODESK EDUCATIONAL PRODUCT

Tolerkncias nmo especificadas ±0,1mm

Robocup - Small Size League
