FeCoquito/Robot-s-design/RoboFEI 2014/Work in Progress 2014/Projeto Nova Frente/CAD/Placa de Chute.pdf

30,00

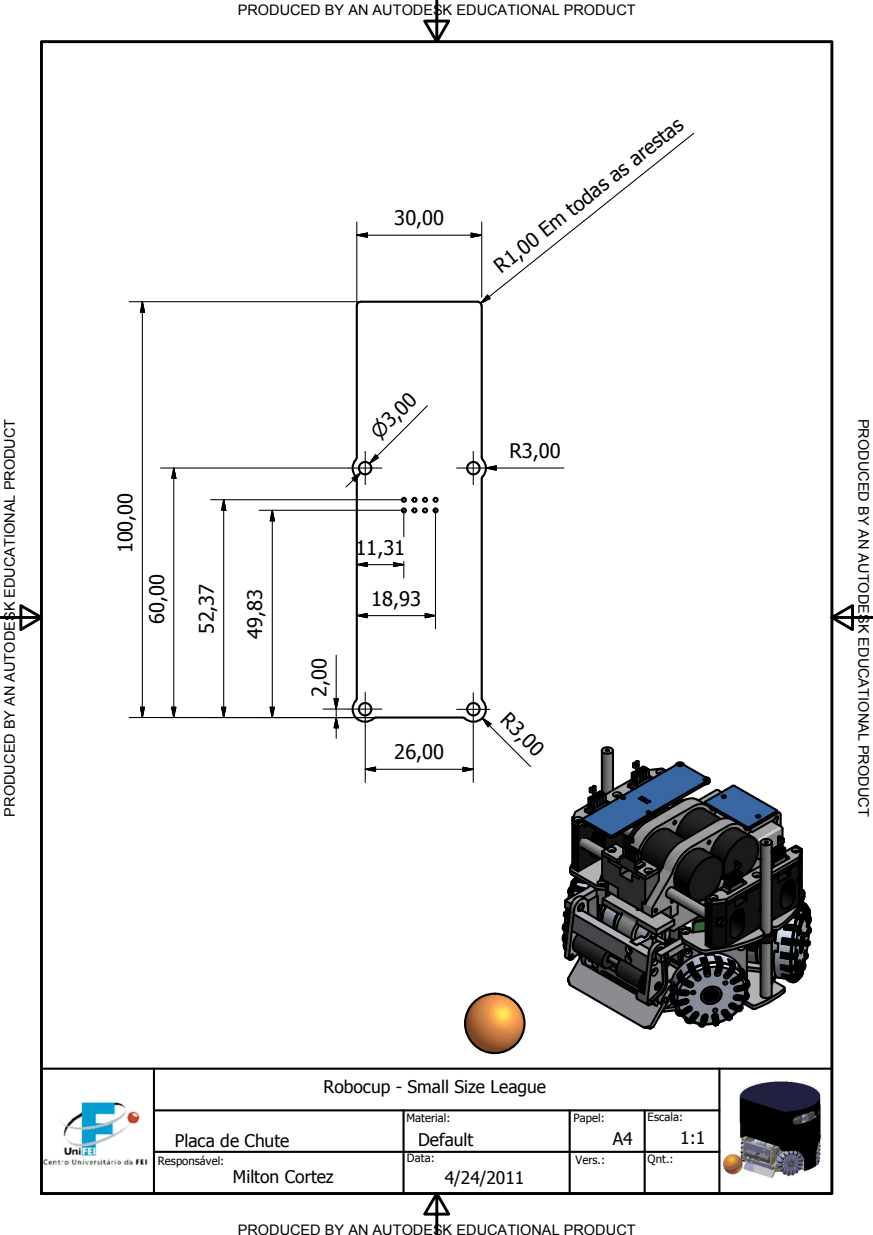
[picture p59: page 1]
TIO; A U T O D E S K E D U C A TIO; Qnt.:; Escala:; Responsivel:; Milton Cortez; Material:; Placa de Chute; Default; Vers.:; Papel:; Data:

PRODUCED BY AN AUTODESK EDUCATIONAL PRODUCT

R1,00 Em todas as arestas

Robocup - Small Size League
