FeCoquito/Robot-s-design/RoboFEI 2014/Work in Progress 2014/Projeto Nova Frente/CAD/Roda - Tampa.pdf

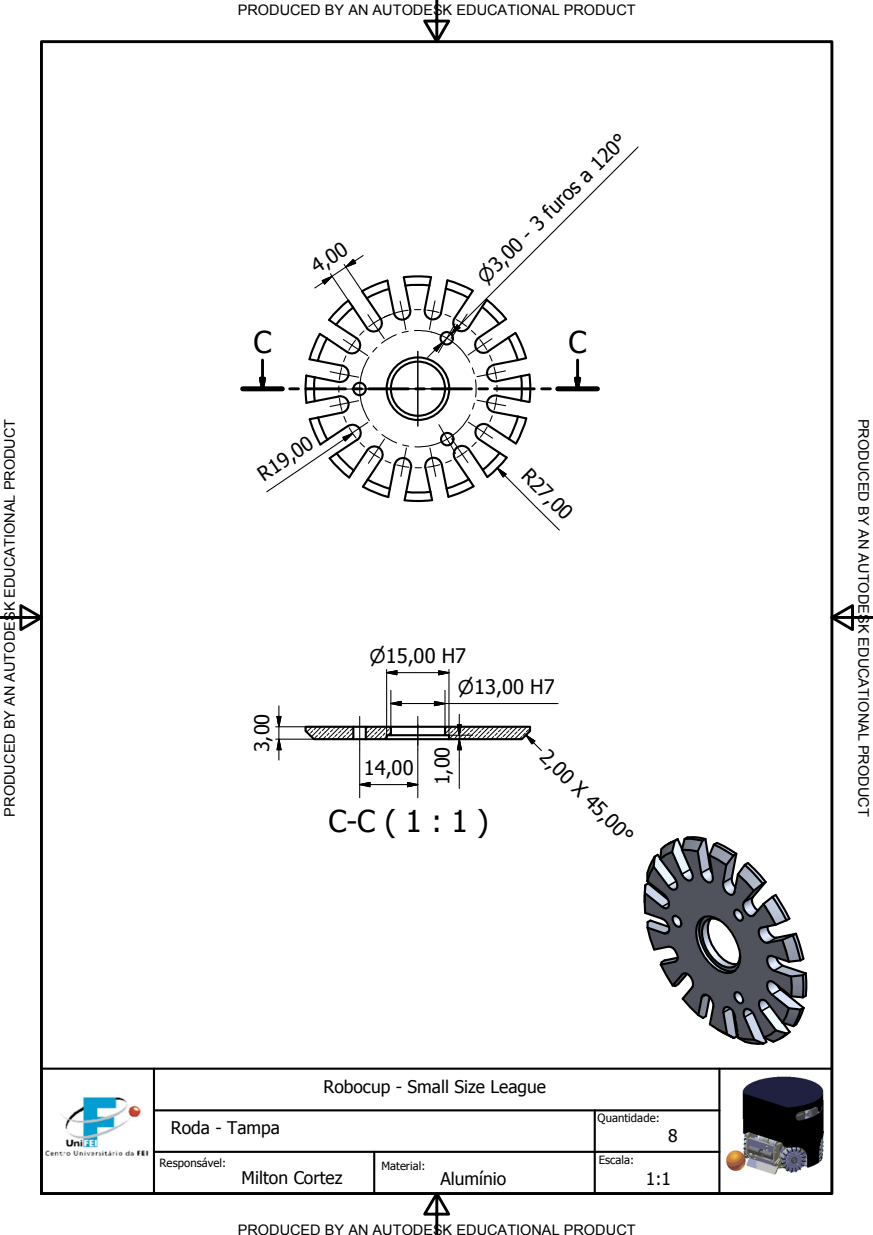
[picture p60: page 1]
TIO; A U T O D E S K E D U C A TIO; Quantidade:; Responsive; Escala: l:; Milton Cortez; Material:; Roda - Tampa; Alumtnio; P3,00 - 3 furos a 120°

PRODUCED BY AN AUTODESK EDUCATIONAL PRODUCT

Robocup - Small Size League
