FeCoquito/Robot-s-design/RoboFEI 2014/Work in Progress 2014/Projeto Nova Frente/CAD/Rolete.pdf

### PRODUCED BY AN AUTODESK EDUCATIONAL PRODUCT

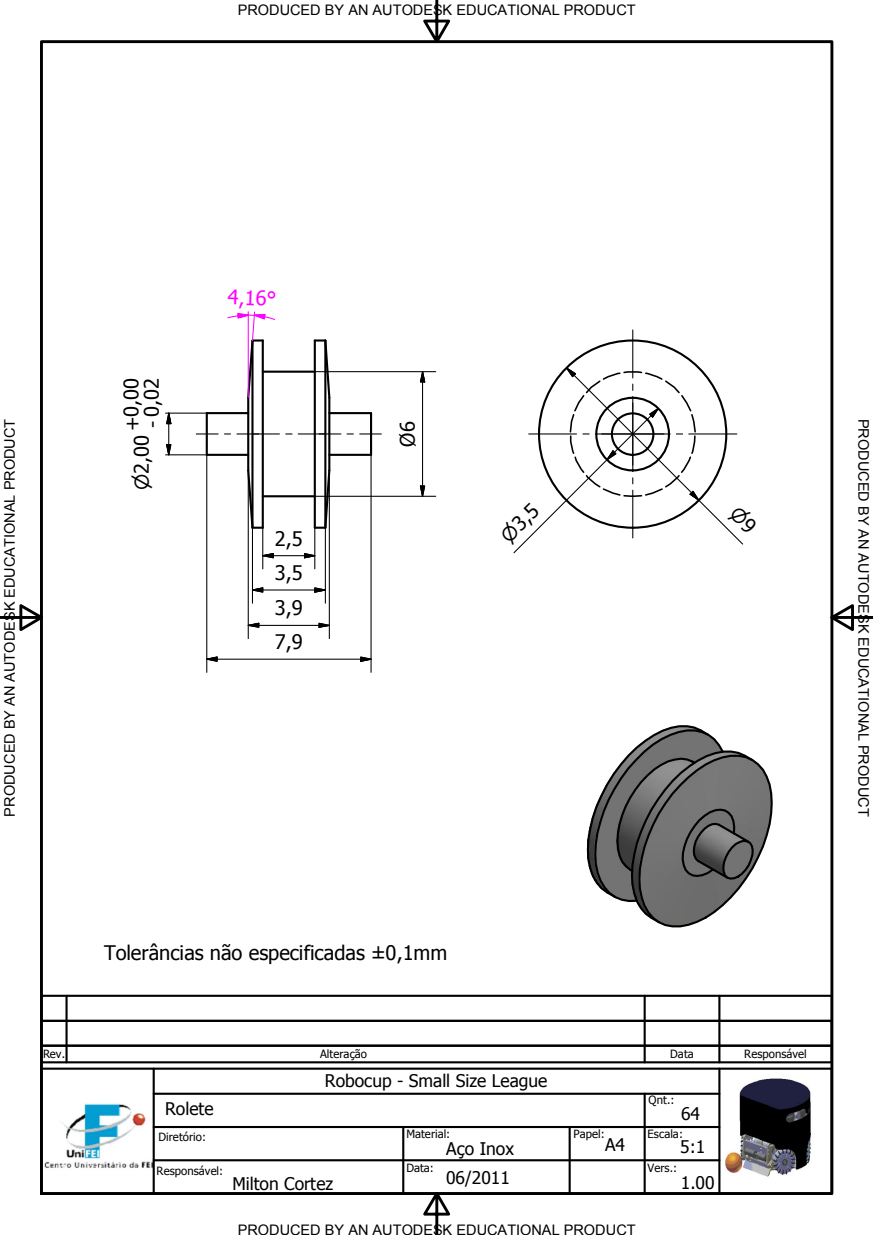
[picture p61: page 1]
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

Tolerkncias nmo especificadas ±0,1mm

Robocup - Small Size League

Rolete | Qnt.: 64

Diretyrio: | Material: Aoo Inox | Papel: A4 | Escala: 5:1

Re Milton Cortez | Data: 06/2011 | | Vers.: sponsivel: 1.00

PRODUCED BY AN AUTODESK EDUCATIONAL PRODUCT
