FeCoquito/Robot-s-design/RoboFEI 2014/Work in Progress 2014/Projeto Nova Frente/CAD/Roller.pdf

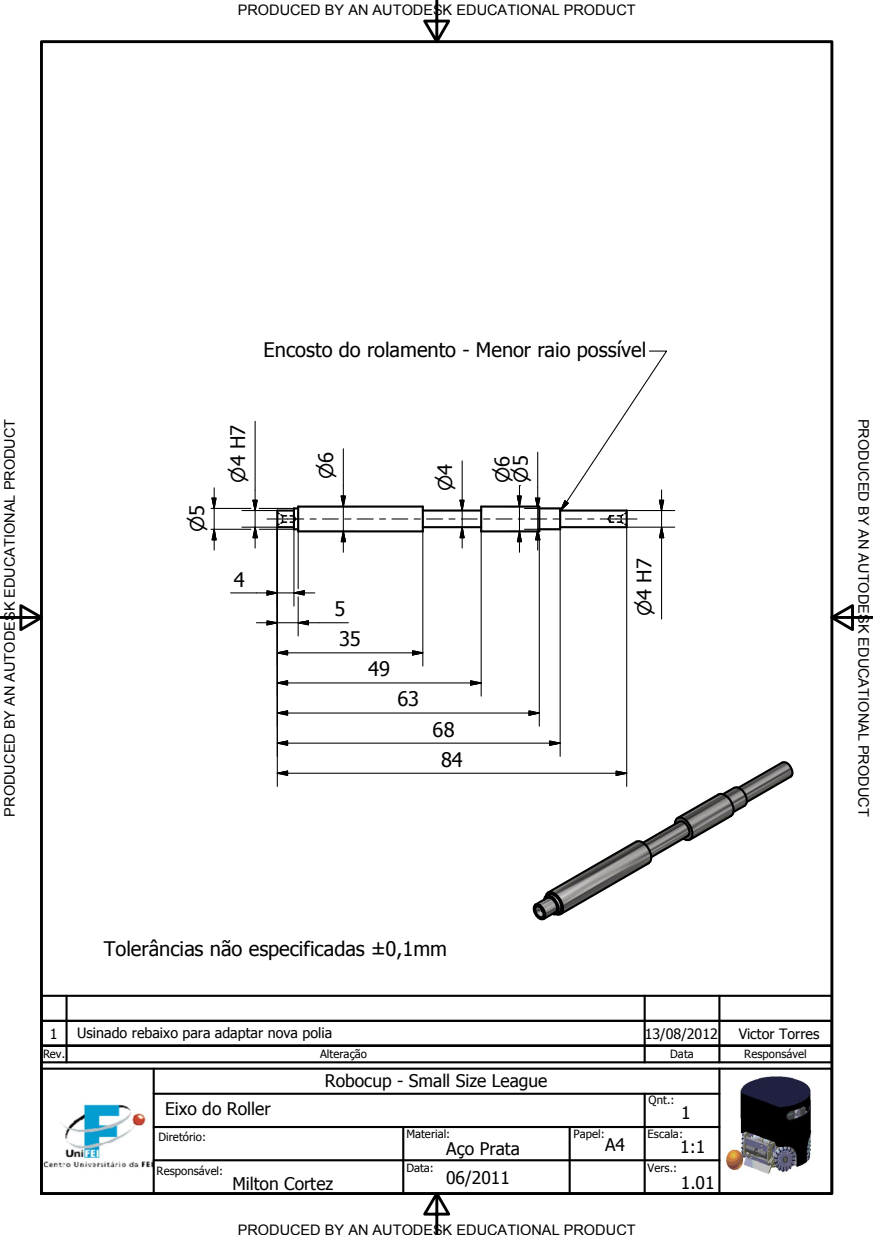
[picture p62: page 1]
TIO; A U T O D E S K E D U C A TIO

PRODUCED BY AN AUTODESK EDUCATIONAL PRODUCT

Encosto do rolamento - Menor raio posstvel

Tolerkncias nmo especificadas ±0,1mm

1 | Usinado rebaixo para adaptar nova polia | 13/08/2012 | Victor Torres

Rev. | Alteraomo | Data | Responsivel

Robocup - Small Size League

Eixo do Roller | Qnt.: 1

Diretyrio: | Material: Aoo Prata | Papel: A4 | Escala: 1:1

Responsivel: Milton Cortez | Data: 06/2011 | | Vers.: 1.01
