FeCoquito/Robot-s-design/RoboFEI 2014/Work in Progress 2014/Projeto Nova Frente/CAD/Suporte - Bateria Traseiro.pdf

### PRODUCED BY AN AUTODESK EDUCATIONAL PRODUCT

74

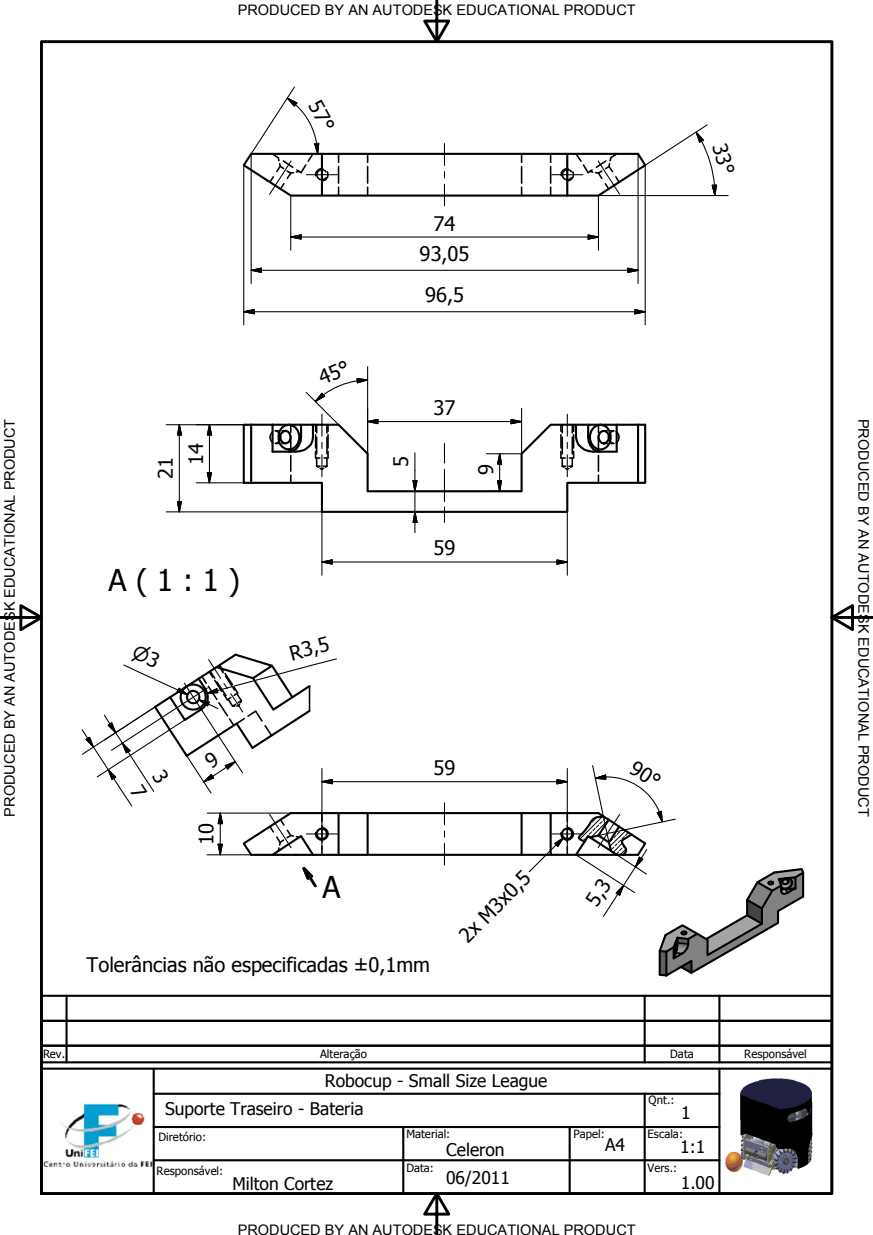
[picture p63: page 1]
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

Tolerkncias nmo especificadas ±0,1mm

Robocup - Small Size League

Suporte Traseiro - Bateria | Qnt.: 1

Diretyrio: | Material: Celeron | Papel: A4 | Escala: 1:1

Re Milton Cortez | Data: 06/2011 | | Vers.: sponsivel: 1.00

PRODUCED BY AN AUTODESK EDUCATIONAL PRODUCT
