FeCoquito/Robot-s-design/RoboFEI 2014/Work in Progress 2014/Projeto Nova Frente/CAD/Suporte - Baterias.pdf

### PRODUCED BY AN AUTODESK EDUCATIONAL PRODUCT

37

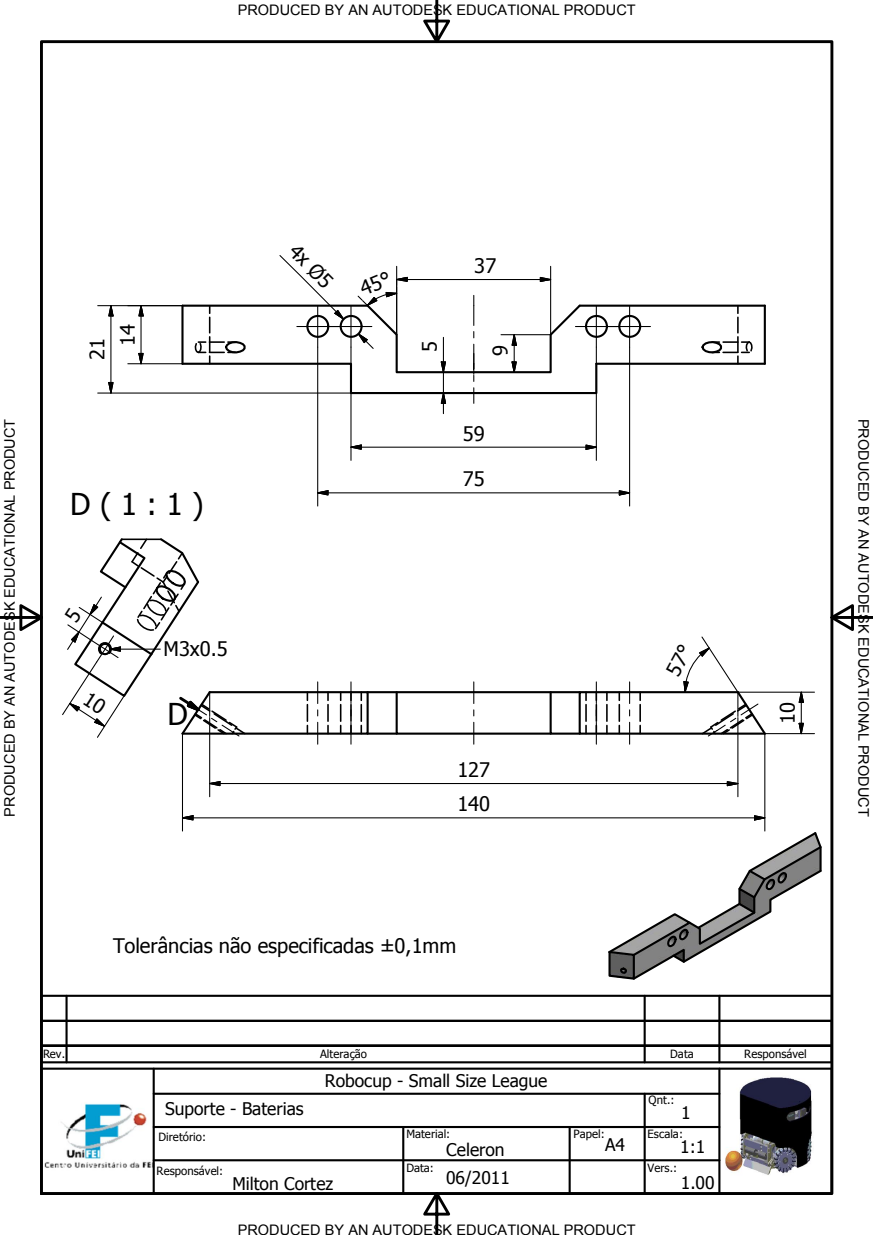
[picture p64: page 1]
TIO; A U T O D E S K E D U C A TIO; Alteraomo; Responsivel; Rev.; Data

Tolerkncias nmo especificadas ±0,1mm

Robocup - Small Size League

Suporte - Baterias | Qnt.: 1

Diretyrio: | Material: Celeron | Papel: A4 | Escala: 1:1

Responsivel: Milton Cortez | Data: 06/2011 | | Vers.: 1.00

PRODUCED BY AN AUTODESK EDUCATIONAL PRODUCT
