FeCoquito/Robot-s-design/RoboFEI 2014/Work in Progress 2014/Projeto Nova Frente/CAD/Suporte - Capacitores.pdf

### PRODUCED BY AN AUTODESK EDUCATIONAL PRODUCT

4

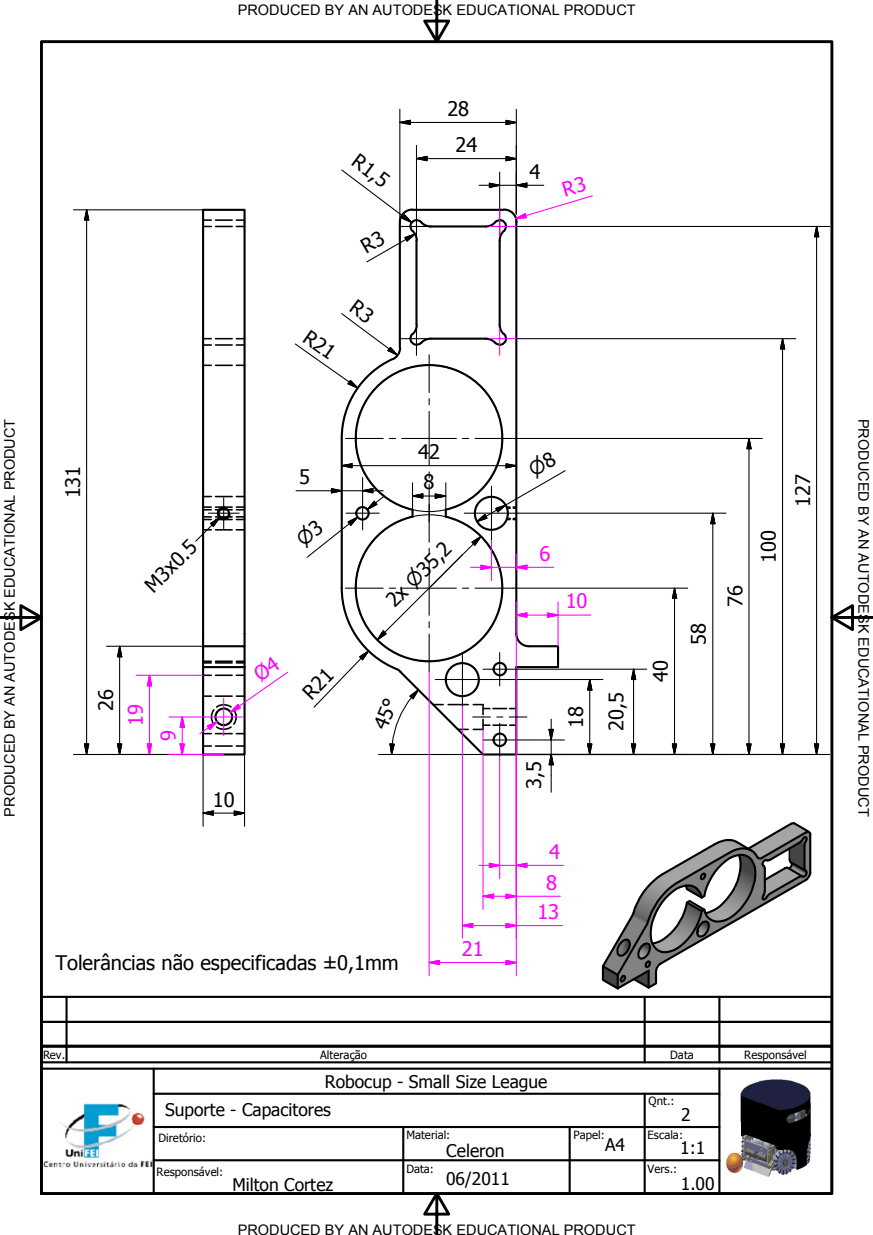
[picture p65: page 1]
TIO; A U T O D E S K E D U C A TIO; Alteraomo; Rev.; Data; Responsivel

Tolerkncias nmo especificadas ±0,1mm

Robocup - Small Size League

Suporte - Capacitores | Qnt.: 2

Diretyrio: | Material: Celeron | Papel: A4 | Escala: 1:1

Responsivel: Milton Cortez | Data: 06/2011 | | Vers.: 1.00

PRODUCED BY AN AUTODESK EDUCATIONAL PRODUCT
