FeCoquito/Robot-s-design/RoboFEI 2014/Work in Progress 2014/Projeto Nova Frente/CAD/Suporte - Chipkick.pdf

A | A

### PRODUCED BY AN AUTODESK EDUCATIONAL PRODUCT

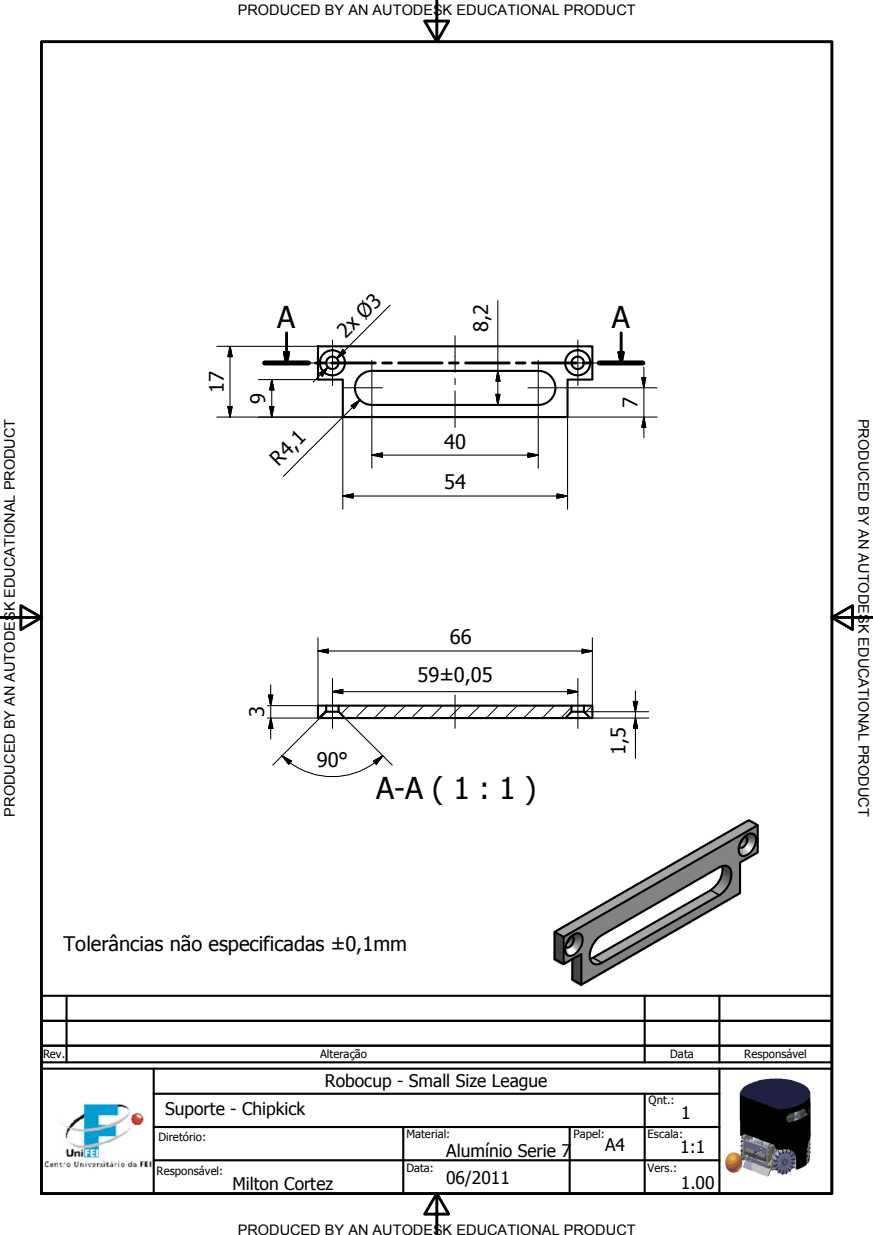
[picture p66: page 1]
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

Tolerkncias nmo especificadas ±0,1mm

Robocup - Small Size League

Suporte - Chipkick | Qnt.: 1

Diretyrio: | Material: Alumtnio Serie 7 | Papel: A4 | Escala: 1:1

Re Milton Cortez | Data: 06/2011 | | Vers.: sponsivel: 1.00

PRODUCED BY AN AUTODESK EDUCATIONAL PRODUCT
