FeCoquito/Robot-s-design/RoboFEI 2014/Work in Progress 2014/Projeto Nova Frente/Componentes/conector - cabo.pdf

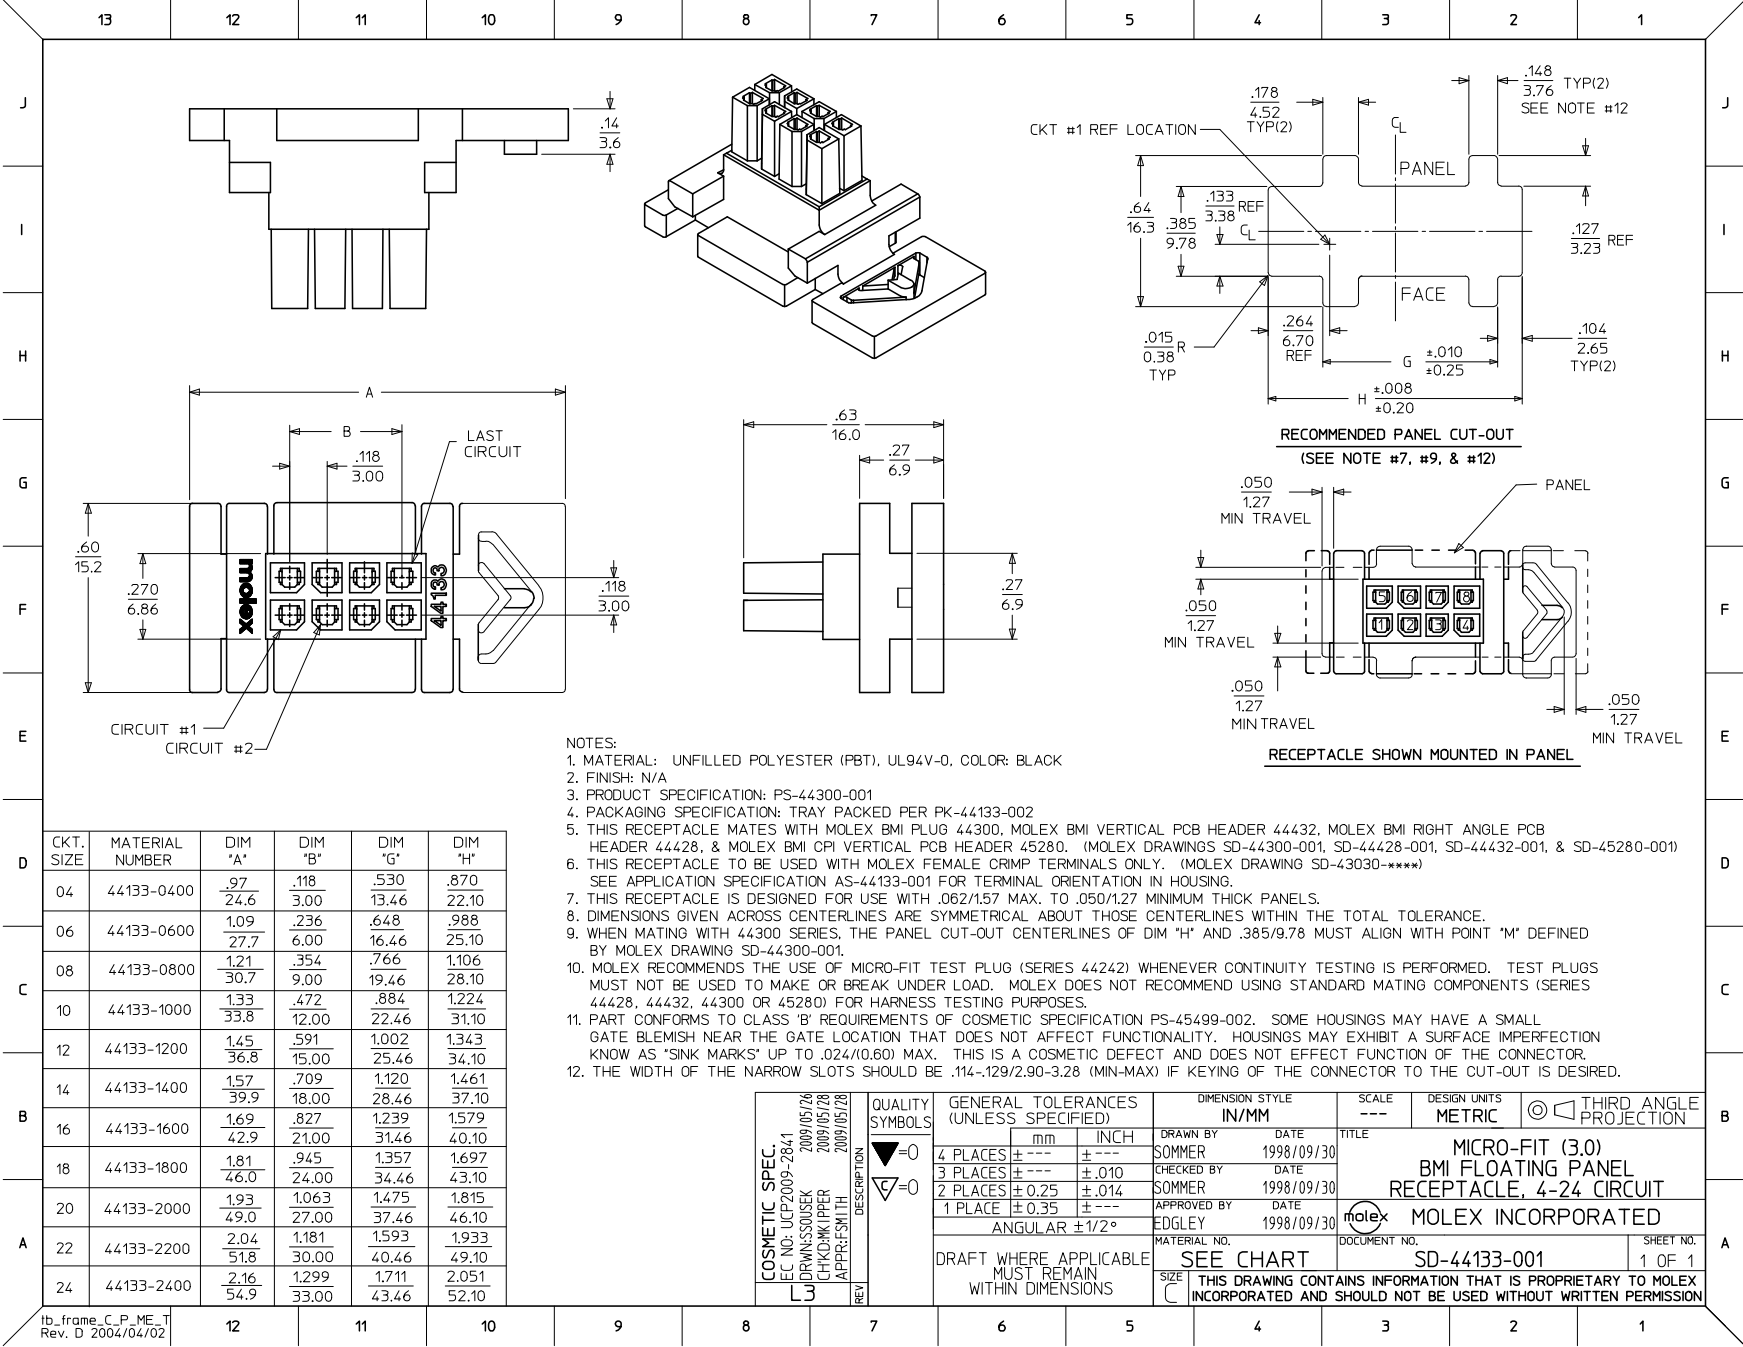
[picture p67: page 1]
