FeCoquito/Robot-s-design/RoboFEI 2014/Work in Progress 2014/Projeto Nova Frente/Componentes/Conector - placa.pdf

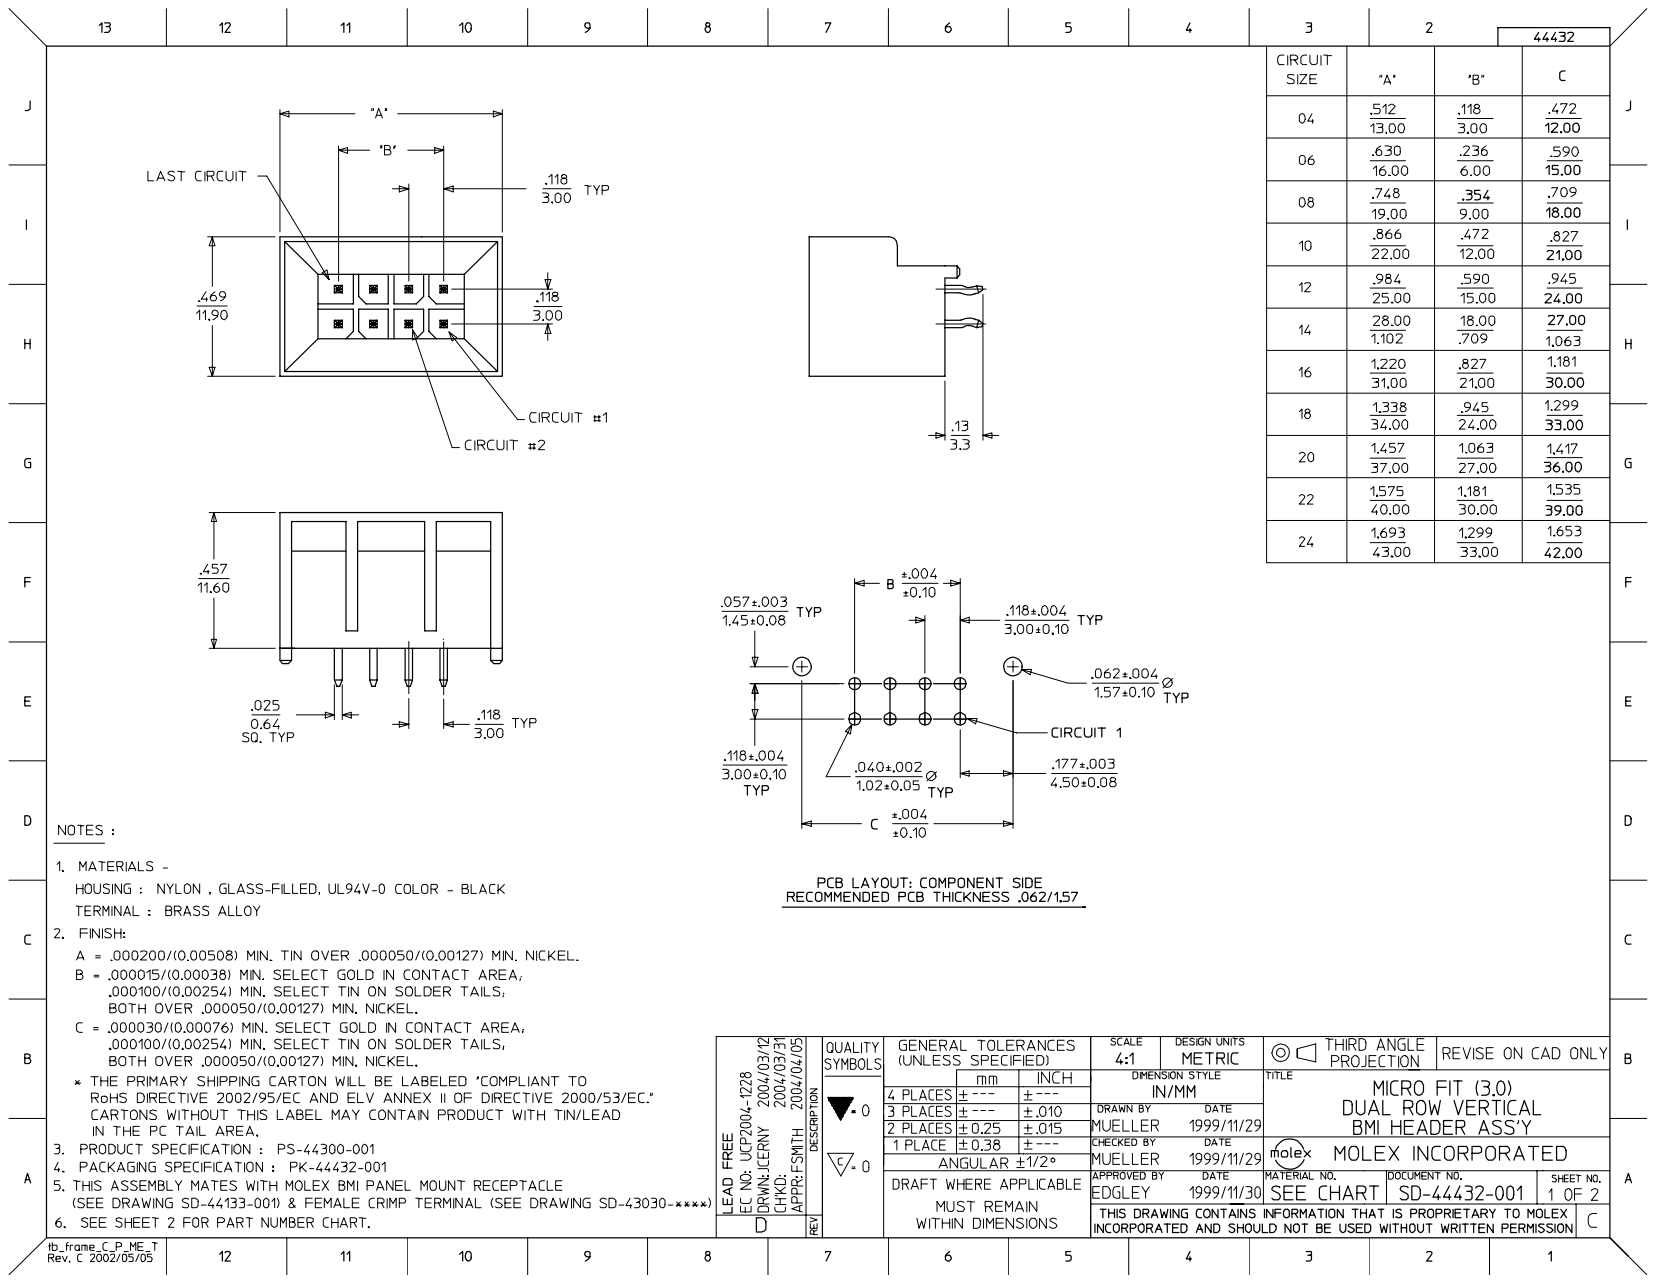
[picture p68: page 1]

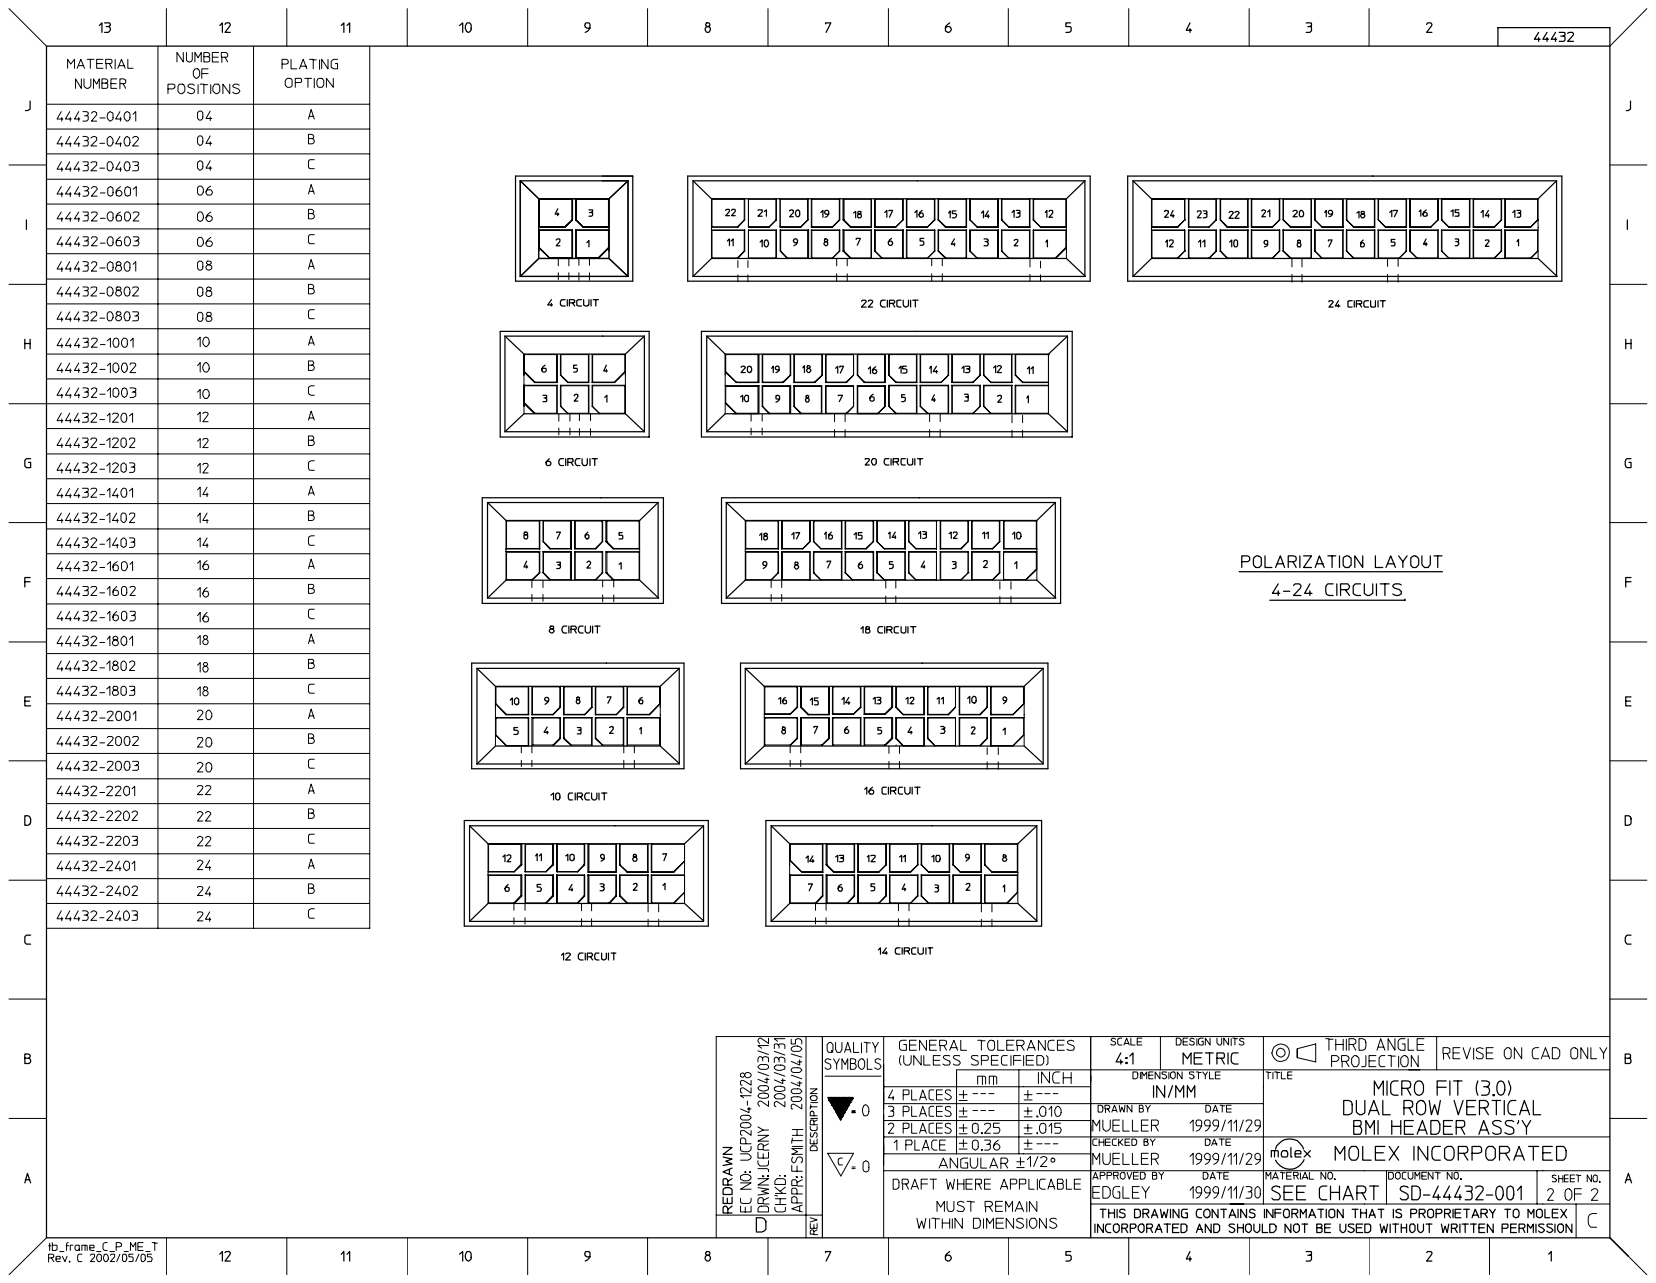
[picture p69: page 2]
