FeCoquito/Robot-s-design/RoboFEI 2014/Work in Progress 2014/Projeto Nova Frente/Conjuntos de Montagens/Conjunto Amortecedor/Amortecedor.pdf

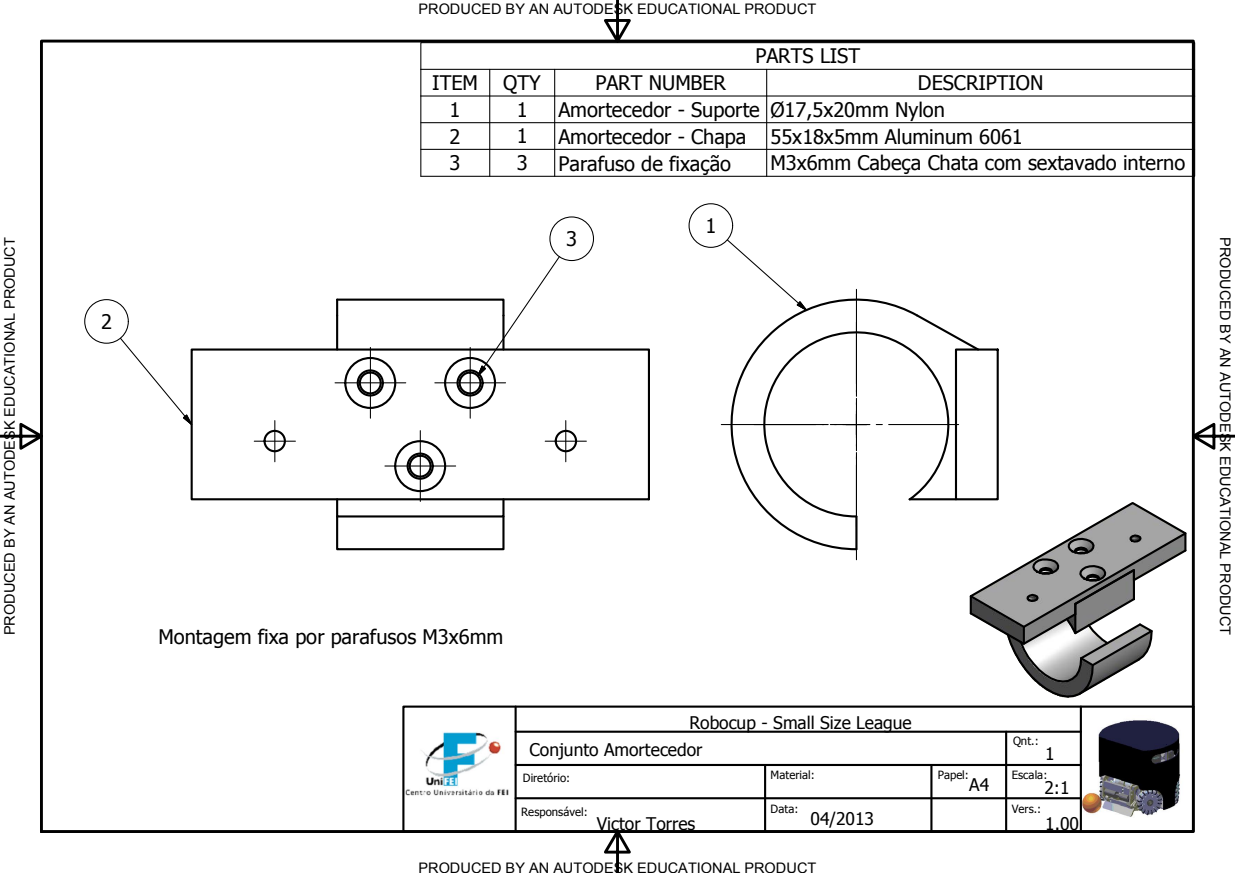
[picture p70: page 1]
PARTS LIST; ITEM; QTY; PART NUMBER; DESCRIPTION; Amortecedor - Suporte; Ø17,5x20mm Nylon; Amortecedor - Chapa; 55x18x5mm Aluminum 6061; Parafuso de fixaomo; M3x6mm Cabeoa Chata com sextavado interno; TIO; A U T O D E S K E D U C A TIO; Responsivel:; Victor Torres; Vers.:; Data:

PRODUCED BY AN AUTODESK EDUCATIONAL PRODUCT

Montagem fixa por parafusos M3x6mm

Robocup - Small Size League

Conjunto Amortecedor | Qnt.: 1

Diretyrio: | Material: | Papel: A4 | Escala: 2:1
