FeCoquito/Robot-s-design/RoboFEI 2014/Work in Progress 2014/Projeto Nova Frente/Conjuntos de Montagens/Conjunto Inferior/Conjunto 7.pdf

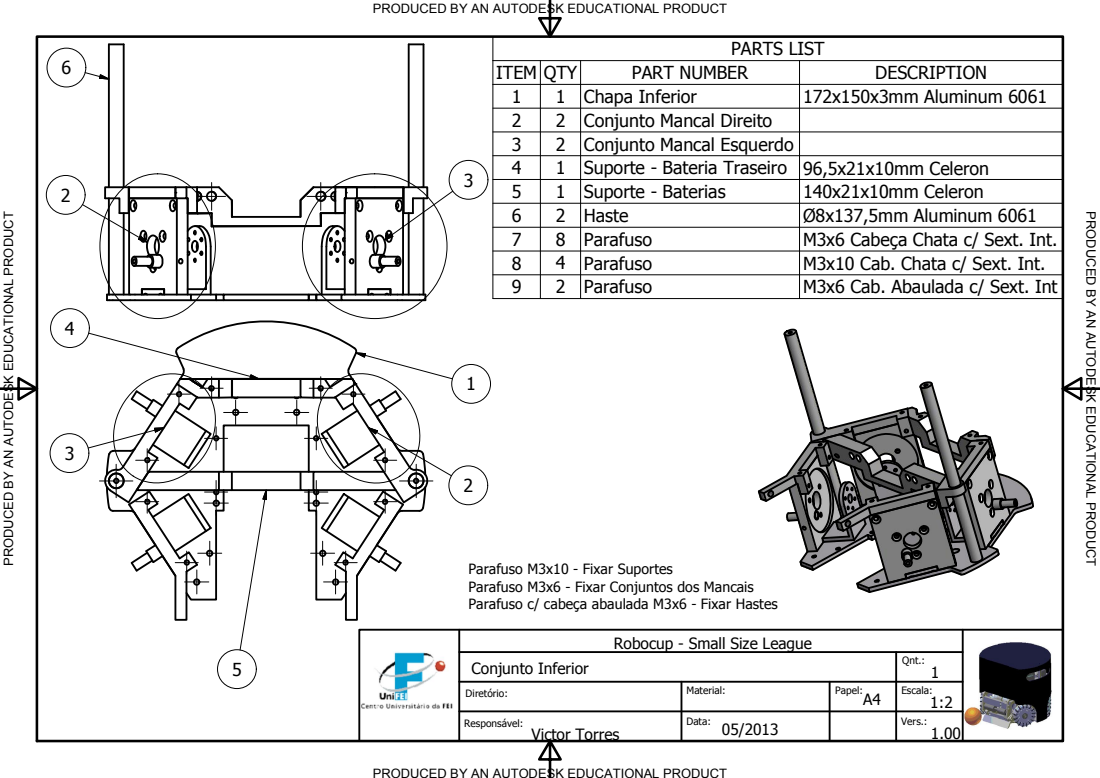
[picture p71: page 1]
Alu; ele; ula; TIO; all S

PRODUCED BY AN AUTODESK EDUCATIONAL PRODUCT

y D i r e t r i o : | M a t e r i al: | P a p el: A 4 | E s c ala : 1 : 2
