FeCoquito/Robot-s-design/RoboFEI 2014/Work in Progress 2014/Projeto Nova Frente/Conjuntos de Montagens/Conjunto Solenoide/Conjunto 6.pdf

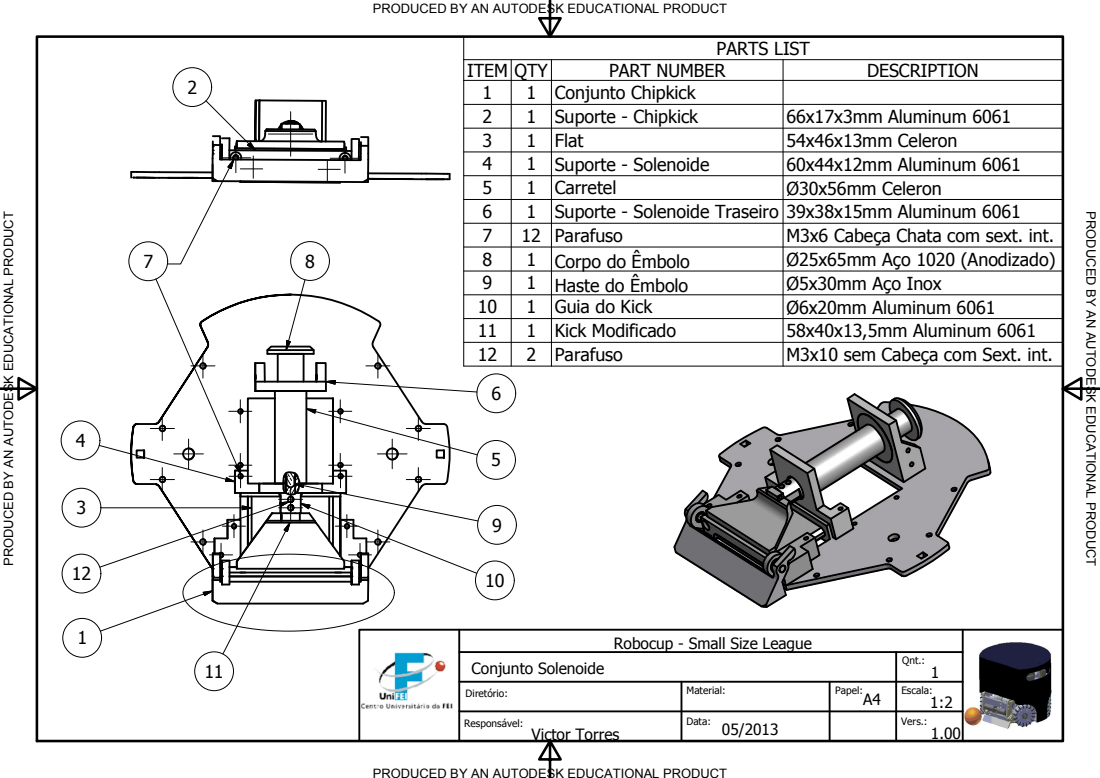
[picture p72: page 1]
Alu; Fla; ele; ole; olo; TIO; all S

PRODUCED BY AN AUTODESK EDUCATIONAL PRODUCT

C o n j u n t o S ole n o i d e | Q n t . : 1

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
