FeCoquito/Robot-s-design/RoboFEI 2014/Work in Progress 2014/Projeto Nova Frente/CAD/Capa.pdf

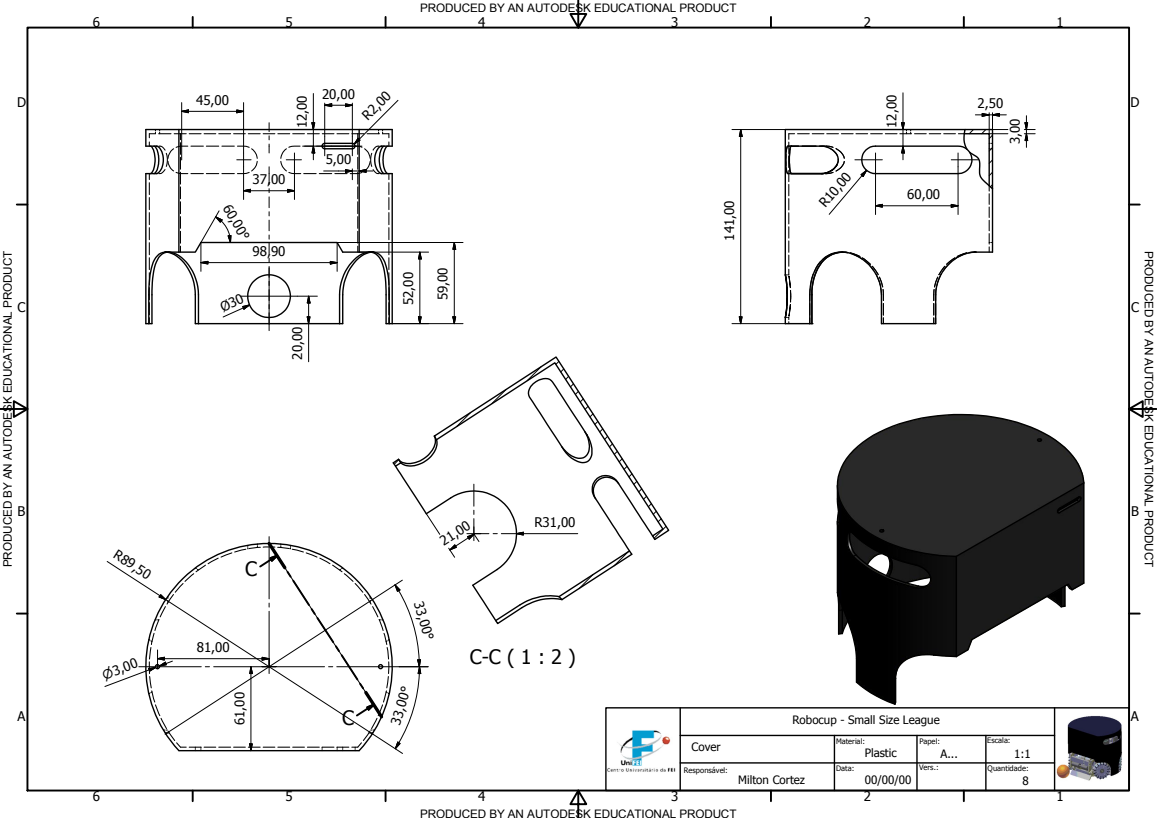
[picture p73: page 1]
TIO N; all S; ala; ilt; Pla

PRODUCED BY AN AUTODESK EDUCATIONAL PRODUCT
