FeCoquito/Robot-s-design/RoboFEI 2014/Work in Progress 2014/Projeto Nova Frente/CAD/Roda.pdf

0

0

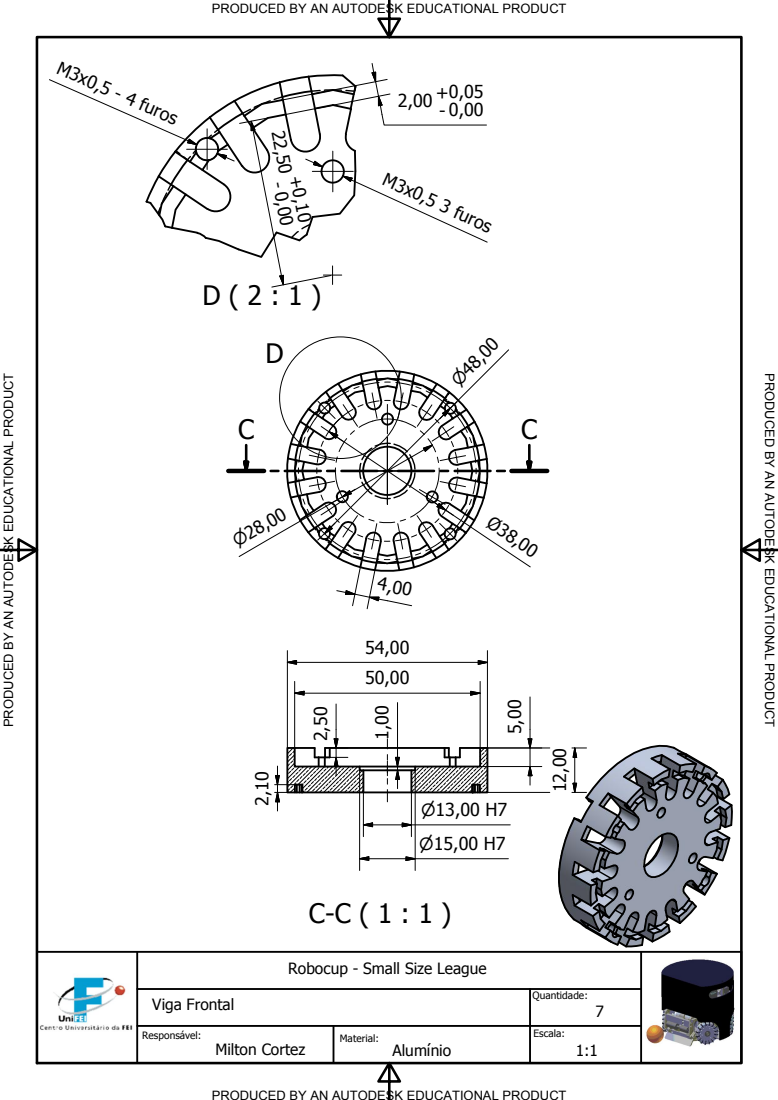
[picture p74: page 1]
TIO; all S; ala; Milton Cortez; Alu; M3x0, 5 - 4 furos; M3x0, 5 3 furos

PRODUCED BY AN AUTODESK EDUCATIONAL PRODUCT
