FeCoquito/Robot-s-design/(commit log)

2024-11-05 Adicionando arquivos grandes com Git LFS
    [0435.250KRS.ipt, 0435.250KRS001.ipt, 0435.250KRS002.ipt, 0435.250KRS003.iam, 3386-T.ipt, 44133-0800.stp, 473460001.iam, ANSI (in).dwg]
2024-11-05 Adicionando arquivos Robo 2022 e 2024
    [0435.250KRS.0001.ipt, 0435.250KRS.ipt, 0435.250KRS001.0001.ipt, 0435.250KRS001.ipt, 0435.250KRS002.0001.ipt, 0435.250KRS002.ipt, 0435.250KRS003.0001.iam, 0435.250KRS003.iam]
2024-11-05 Adicionando arquivos RoboFEI 2014
    [251003x6.ipt, Amortecedor - Chapa.idw, Amortecedor - Chapa.ipt, Amortecedor - Suporte.idw, Amortecedor - Suporte.ipt, Amortecedor.iam, Amortecedor.idw, Area 180mm.0001.ipt]
