FeCoquito/Robot-s-design/(notices)

Notices in the files:
README.md:
License: RoboFEI
